YagelTasa/Smart_water_bar/PCB.png

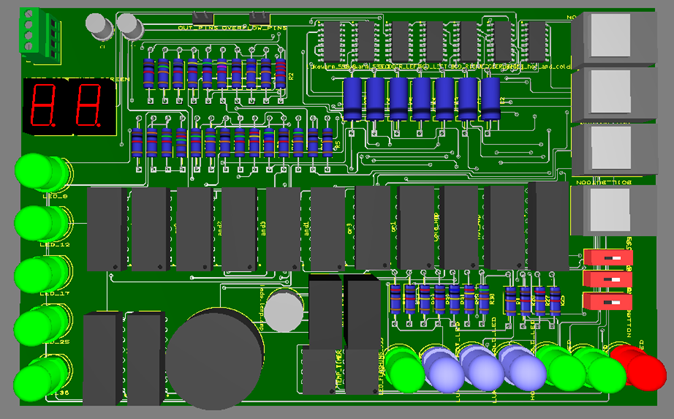
PCB.png
