YagelTasa/Smart_water_bar/Matrix image.jpg

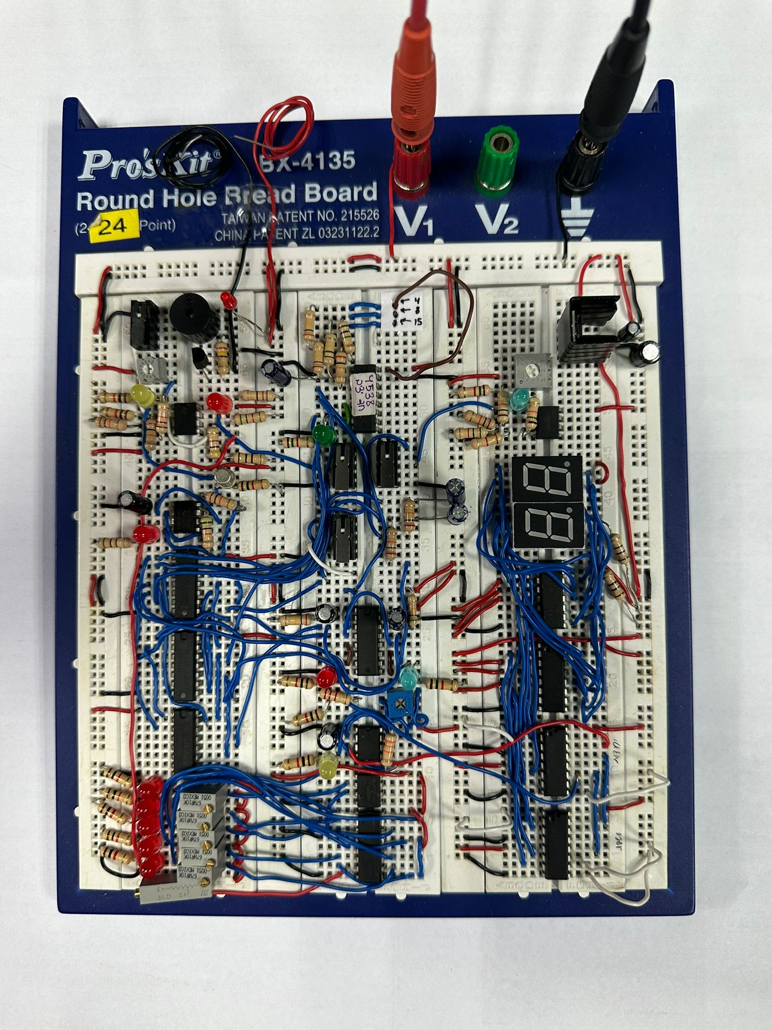
Matrix image.jpg
