YagelTasa/Smart_water_bar/Project summary (poster).pdf

## תיאור המערכת

.1 בקרת טווח טמפרטורה- בר המים שומר על טווח טמפרטורה מתאים, מים חמים

# בטווח של °C90 > ttttttt > °C50 ומים קרים בטווח של °C10 > ttttttt > °C.5

.2 הרתחת מים חמים- לאחר לחיצה על כפתור הרתחת מים מתבצע תהליך חימום

המים ל- °C92 (נבחר להרתיח את המים ב- °C2 מעל הדרישה על מנת לוודא שהדרישה תתקיים), בזמן הרתחת המים נדלקת נורת 1LLLLL אשר מהבהבת.

.3 מזיגת מים חמים- כפתור לחיצה המאפשר מזיגת מים חמים כאשר טמפרטורת המים

°C90 < ttttttt, בעת מזיגת המים נדלקת נורת 1LLLLL באופן רצוף.

.4 מזיגת מים קרים- לאחר לחיצה על כפתור מזיגת מים קרים מתבצעת הפעלת

משאבת המים הקרים, בעת מזיגת המים נדלקת נורת 2LLLLL באופן רצוף.

.5 לחיצה על כל לחצן במערכת בזמן מזיגת מים תפסיק באופן מידי את מזיגת המים. .6 הגדרת כמות מזיגת המים (גודל הכוס קרים וחמים)- ישנם 3 כפתורים אשר שולטים במשך זמן מזיגת המים, אפשרויות גודל הכוס הם מילוי מים במשך 4/8/15 שניות.
.7 מזיגת מים פושרים- כפתור לחיצה המאפשר מזיגת כוס מים פושרים למשך 8 שניות

בטווח טמפרטורת מים °C35 > ttttttt > °C,25 בעת מזיגת המים נדלקת נורת
3LLLLL באופן רצוף.

.8 הצגת טמפרטורת המים החמים והקרים בזמן אמת. .9 נורת אזהרה מפני גלישת מים- כאשר תא אחסון המים העודפים מלא (כתוצאה ממים שזלגו מחוץ לכוס) נדלקת נורת אזהרה מפני גלישת מים.
.10 צג אנלוגי המציג את משך הזמן הנותר למילוי הכוס (מניה לאחור בעת שהמשאבה עובדת).

מטרת הפרויקט .11 מימוש הפרויקט הן כ- PPPPP וגם באמצעות בקר מתוכנת (ארדואינו).

מטרת הפרויקט היא ליצור בר המים הנקרא "אריאל 8" אשר הינו מכשיר חשמלי נוח וקל לתפעול שמנגיש ומספק מי שתייה קרים וחמים ושמירתם בטמפרטורה הרצויה. בר המים מקרר או מחמם את המים עד לטמפרטורה שהוגדרה לו בעת תכנונו באמצעות שימוש בחיישנים ומערכות בקרה המתוכננות באמצעות רכיבי מעבדה. בנוסף לכך, מטרת הפרויקט היא למידה עמוקה של תכנון ובניית מערכת חשמלית עד הפרטים הקטנים על ידי סימולציות ומימוש אלקטרוני.

## מבוא

אופן צריכת מי שתייה נמצא בהתפתחות רבה בשנים האחרונות, השתלבות עולם ההנדסה בהתפתחות זו בא לידי ביטוי ביצור מערכות בקרה ושליטה על כלל הפרמטרים הנדרשים. התפתחות זו נבעה בשל צורך גדול בשיפור אספקת והנגשת מי השתייה. בעשורים האחרונים הגיעו לשוק ברי מים ושינו לטובה בצורה ניכרת את דרכי צריכת מי השתייה כיום.
ברי המים עובדים בצורה חכמה ויעילה כאשר גופי החימום והקירור, מופעלים על ידי חיישנים המודדים את טמפרטורת המים מידי פרק זמן קצוב, במידה והחיישנים מזהים שינוי טמפרטורה משמעותי במים, מופעלים שוב גופי החימום והקירור המחזירים את המים לטמפרטורה הרצויה.
פעולה זו המפעילה אך ורק בעת הצורך את גופי החימום או קירור מאפשרת למתקני בר מים להיות חסכוניים ומדויקים יחסית בצריכת החשמל. בשל הרצון להפיכתם לחסכוניים אף יותר, מתקני בר מים רבים מעלים או מורידים את הטמפרטורה מעט יותר כדי לאפשר פרק זמן גדול יותר בו גוף החימום או קירור לא יפעל. בנוסף לבקרת טמפרטורת המים, קיימות מערכות טכנולוגיות לשליטה ובקרה על כמות מזיגת המים לכוס, מזיגת מים פושרים באמצעות שילוב המים הקרים והחמים, אזהרה מפני גלישת מים עודפים, הרתחת מים, אינדיקציות המציגות בזמן אמת את מצב המכשיר באמצעות צג ונורות LED ועוד.

## תקציר

בפרויקט זה פותחה ומומשה מערכת חכמה מתקדמת לבקרה ושליטה על בר מים חכם. התהליך התחיל עם ניתוח הדרישות המלאות והפרמטרים הנדרשים למערכת. הדרישות כללו שליטה בטמפרטורה של מים חמים וקרים, הרתחת מים, מילוי כוסות חמות וקרות לפי זמן נבחר, שליטה בזמני המילוי, תצוגה של טמפרטורת המים בזמן אמת, תצוגת משך זמן הנותר למילוי הכוס ואזהרה מפני גלישת מים מתא האחסון. לאחר ניתוח הדרישות, נבנה תרשים באמצעות סכמת בלוקים המתארת את מבנה המערכת והקשרים בין הרכיבים. לאחר מכן, בוצע תכנון החומרה, אשר כלל תכנון של רכיבים וחיבורים בתוכנת הסימולציה Multisim.
במהלך תכנון החומרה, בוצעו סימולציות שנועדו לוודא את פעילות המעגל ולוודא את תקינותו.
לאחר התכנון, בוצע המימוש על גבי מטריצת החיבורים, לאחר המימוש נערכו בדיקות מתאימות על מנת לוודא שהמעגלים אכן פועלים כראוי. בנוסף, בוצע תכנון PCB המוכן להדפסה עבור המערכת. לאחר מכן, המערכת כולה תוכננה ומומשה באמצעות מיקרו-בקר (ארדואינו). המערכת יושמה בעזרת שפת תכנות ייעודית המתארת את דרישות המערכת. במהלך הבדיקות במעבדה בוצע תיעוד מפורט על מדידות, תוצאות ותיקונים שבוצעו. התיעוד תרם לשיפור ביצועי המערכת ולוודא שהיא פועלת באמינות וביעילות.

## תוצאות עיקריות

1 . בלוק מים חמים – בלוק זה מורכב מ- מעגל בקרת טמפרטורה, מעגל הרתחת מים ומעגל מזיגת מים.

2 . בלוק מים קרים – בלוק זה מורכב מ- מעגל בקרת טמפרטורה ומעגל מזיגת מים.

סיכום 3 . בלוק עצירת מערכת – בלוק זה אחראי על הפסקת המערכת בעת הצורך. בפרויקט הנדסי זה תוכננה ויושמה מערכת בר מים חכמה אשר מספקת ומנגישה מים חמים, קרים ופושרים לשתייה. מתוך דרישות הפרויקט תוכננה סכמת בלוקים אשר באמצעותה תוכננה ויושמה המערכת כולה ברמת החיבורים והרכיבים. תכנון החומרה בוצע לאחר מכן באמצעות תוכנת הדמיית הסימולציה Multisim אשר שימשה לבדיקה והדמיה של המעגלים במערכת בכדי לוודא שהם תקינים ואיכותיים. לאחר השלמת תכנון החומרה, התכנון יושם על גבי מטריצת חיבורים. מטריצת החיבורים הראתה כיצד הרכיבים יהיו מחוברים זה לזה פיזית. לאחר מכן בוצעו בדיקות תקינות המעגלים במטריצת החיבורים באמצעות סקופ. הסקופ שימש לבדיקת המעגלים כדי לוודא שהם פועלים כהלכה. בנוסף, המערכת כולה תוכננה ומומשה באמצעות מיקרו-בקר (ארדואינו), וב- PCB.

# תכנון ומימוש בר המים "אריאל 8"

## מגישים: ינון כהן יגל טסה

ת.ז: 208582643 206767469
מנחים : מר אלמוג גילדוב מר אור שלום.
