YagelTasa/Smart_water_bar/Project book.pdf

## הפקולטה להנדסה

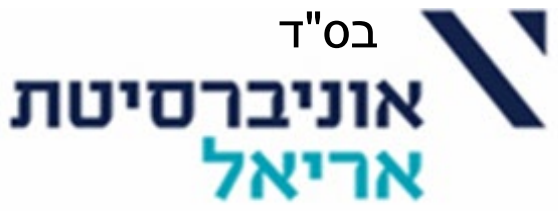
[picture p3: figure]

## המחלקה להנדסת חשמל ואלקטרוניקה

# תכנון ומימוש מערכת בר המים החדש "אריאל 8"

## פרויקט גמר המהווה חלק מהדרישות לתואר Sc.B

### מוגש ע"י: ינון כהן – 208582643 יגל טסה - 206767469

אחראיים אקדמיים : אלמוג גילדוב ואור שלום.

### תאריך הגשה: יוני .2023

תקציר.

בפרויקט זה פותחה ומומשה מערכת חכמה מתקדמת לבקרה ושליטה על בר מים חכם. התהליך התחיל עם ניתוח הדרישות המלאות והפרמטרים הנדרשים למערכת. הדרישות כללו שליטה בטמפרטורה של מים חמים וקרים, הרתחת מים, מילוי כוסות חמות וקרות לפי זמן נבחר, שליטה בזמני המילוי, תצוגה של טמפרטורת המים בזמן אמת, תצוגת משך זמן הנותר למילוי הכוס ואזהרה מפני גלישת מים מתא האחסון. לאחר ניתוח הדרישות, נבנה תרשים באמצעות סכמת בלוקים המתארת את מבנה המערכת והקשרים בין הרכיבים.
לאחר מכן, בוצע תכנון החומרה, אשר כלל תכנון של רכיבים וחיבורים בתוכנת הסימולציה .Multisim
במהלך תכנון החומרה, בוצעו סימולציות שנועדו לוודא את פעילות המעגל ולוודא את תקינותו.
לאחר התכנון, בוצע המימוש על גבי מטריצת החיבורים, לאחר המימוש נערכו בדיקות מתאימות על מנת לוודא שהמעגלים אכן פועלים כראוי. בנוסף, בוצע תכנון PCB המוכן להדפסה עבור המערכת. לאחר מכן, המערכת כולה תוכננה ומומשה באמצעות מיקרו-בקר (ארדואינו). המערכת יושמה בעזרת שפת תכנות ייעודית המתארת את דרישות המערכת. במהלך הבדיקות במעבדה בוצע תיעוד מפורט על מדידות, תוצאות ותיקונים שבוצעו. התיעוד תרם לשיפור ביצועי המערכת ולוודא שהיא פועלת באמינות וביעילות.

תוכן עניינים .

.1 מבוא.
אופן צריכת מי שתייה נמצא בהתפתחות רבה בשנים האחרונות, השתלבות עולם ההנדסה בהתפתחות זו בא לידי ביטוי ביצור מערכות בקרה ושליטה על כלל הפרמטרים הנדרשים. התפתחות זו נבעה בשל צורך גדול בשיפור אספקת והנגשת מי השתייה.

.1.1 התפתחות אספקת מי השתייה. מימי קדם הייתה מציאת מקורות מים צורך חשוב מאין כמוהו להישרדותו של האדם ולהתפתחות הציוויליזציה.
בתחילה צריכת המים הייתה באמצעות מקורות מים טבעיים, כגון מעיינות, בורות ונחלי מים. לאחר מכן כשבני האדם התחילו לבנות את המבנים הוקמו והתווספו בארות המים למקורות הטבעיים.
השימוש במקורות המים היה באמצעות העלאת המים בדליים בעזרת כוח האדם, מאוחר יותר הומצאה מכונה הממשיכה בתפקיד זה עוד בימינו בארצות הנחשלות והנקראת 'שאדוף'. מכונת השאדוף פועלת לפי עקרון המנוף, והוא עמוד קבוע באדמה עליו מתנופפת קורה ארוכה אשר אל הצד הפונה לעבר המים קושרים חבל עם דלי ואל הצד השני הפונה לעבר היבשה קושרים שק חול שמדמה משקולת. המים מועלים ביותר קלות מכיו ון והחלק הפנימי מכביד מצד השני ומקל על הדליה.

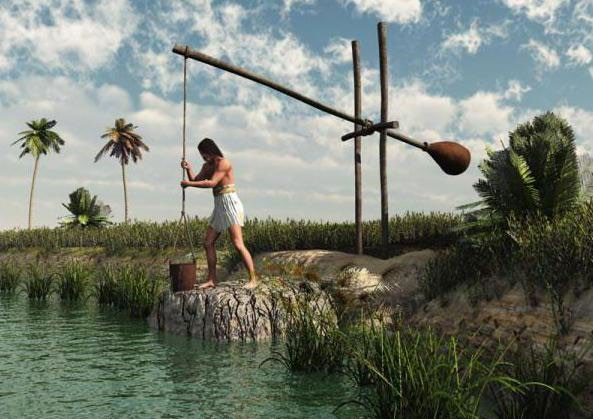
[picture p4: figure]

איור -1 מכונת השאדוף. השאדוף מורכב ממוט ארוך על ציר, בקצהו האחד דלי, או מצקת לשאיבת המים, ובקצהו השני משקל מאזן. המפעיל מושך את החבל עד שהכלי מלא במים ומאפשר למשקל המאזן להרים את המים. הפעלת השאדוף היא ידנית לגמרי, קל יותר למשוך את החבל כלפי מטה מאשר להרים את המים.

בהתפתחות העולם המודרני אספקת מי השתייה התקדמה לעבר השימוש בבקבוקים.

.1.2 אספקת מי שתייה בשילוב טכנולוגיה הנדסית. בעשורים האחרונים הגיעו לשוק ברי מים ושינו לטובה בצורה ניכרת את דרכי צריכת מי השתייה כיום.
ברי המים עובדים בצורה חכמה ויעילה כאשר גופי החימום והקירור, מופעלים על ידי חיישנים המודדים את טמפרטורת המים מידי פרק זמן קצוב, במידה והחיישנים מזהים שינוי טמפרטורה משמעותי במים, מופעלים שוב גופי החימום והקירור המחזירים את המים לטמפרטורה הרצויה.
פעולה זו המפעילה אך ורק בעת הצורך את גופי החימום או קירור מאפשרת למתקני בר מים להיות חסכוניים ומדויקים יחסית בצריכת החשמל. בשל הרצון להפיכתם לחסכוניים אף יותר, מתקני בר מים רבים מעלים או מורידים את הטמפרטורה מעט יותר כדי לאפשר פרק זמן גדול יותר בו גוף החימום או קירור לא יפעל. בנוסף לבקרת טמפרטורת המים, קיימות מערכות טכנולוגיות לשליטה ובקרה על כמות מזיגת המים לכוס, מזיגת מים פושרים באמצעות שילוב המים הקרים והחמים, אזהרה מפני גלישת מים עודפים, הרתחת מים, אינדיקציות המציגות בזמן אמת את מצב המכשיר באמצעות צג ונורות LED ועוד.

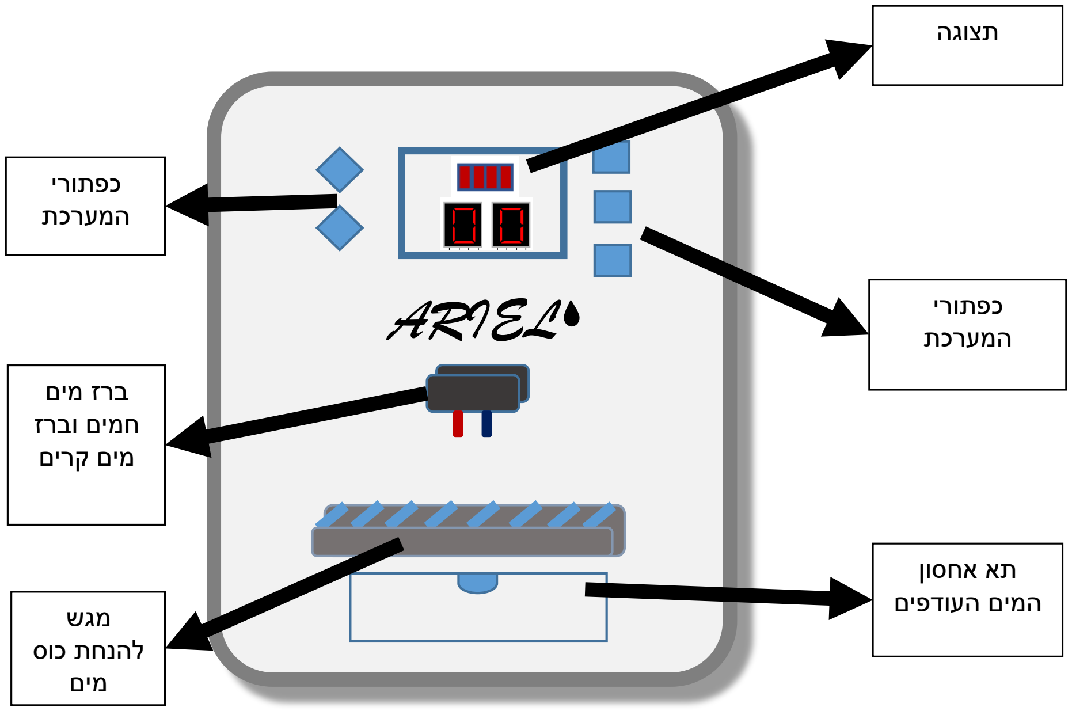
[picture p5: figure]
תצוגה; כפתורי המערכת; ברז מים חמים וברז מים קרים; מגש להנחת כוס מים; תא אחסון המים העודפים; ARIEL

איור -2 תצוגת בר המים אריאל .8

.1.3 יתרונות ברי המים.
- מים זמינים בקלות.
כיום ידוע שצריכת מים מספקת לכל אדם היא הכרח לאורח חיים בריא ומאוזן יותר. מאוד נוח כאשר יש בר מים על השולחן בבית או במשרד המספק באופן זמין מים קרים או חמים במהירות ובכמות מספקת על ידי לחיצת כפתור. אין צורך לסחוב בקבוקים או להעביר שישיות של מים ממקום למקום, דבר אשר מסיר מעלינו מעמסה כבדה ובמיוחד עבור קשישים או אנשים שיש להם קושי או מגבלה פיזית. בר המים גורם לכך שהמשתמשים השונים שותים יותר, בגלל הזמינות והנוחות. יתרון זה תקף למבוגרים וגם לילדים כאחד.
- ידידותי לסביבה.
מדי שנה מגיעים אל האשפה מיליוני בקבוקי מים מפלסטיק מתוך מיליארדים שנמצאים בשימוש ברחבי העולם. מדובר בנזק משמעותי לסביבה ממנו אפשר להימנע באמצעות בר מים. בר מים הוא מכשיר אשר מספק מי השתייה וניתן למלא באמצעותו בקבוקים ריקים ובכך לעשות בהם שימוש חוזר. מלבד זאת, אפשר לוותר על הצורך בבקבוק ולמזוג מים ישירות לכוס רב פעמית בנוחות מקסימלית ובכך לסייע לצמצם את המספרים העצומים של מוצרי פלסטיק אשר נזרקים ומזיקים לסביבה.
- חיסכון כספי.
אם עד עכשיו הייתם משקיעים את הכסף ברכישת בקבוקים של מים מינרלים, לאחר רכישת בר מים לא תצטרכו לעשות זאת יותר ותוכלו ליהנות מחיסכון מרבי. למרות שצפוי כי תשקיעו על רכישת המתקן, אולם מלבד זאת לא יהיו לכם הוצאות מרובות על תפעול ותחזוקה. בר מים זו דרך חסכונית לשתות יותר מים ובגלל זה היא מועדפת על רבים. כאשר תהיו צמאים אינכם צריכים לרכוש מים, המים במתקן זמינים עבורכם סביב השעון וכל שעליכם לעשות הוא פשוט למזוג, במבט לעתיד, זו השקעה משתלמת לכל הדעות.

.1.4 הצורך.
כפי שראינו, ישנו צורך גדול ויתרונות רבים בשימוש בבר מים. פיתוח בר המים "אריאל 8" ייתן מענה בנושא וישפר משמעותית את איכות החיים שלנו.

.2 מטרת הפרויקט.
מטרת הפרויקט היא ליצור בר המים הנקרא "אריאל 8" אשר הינו מכשיר חשמלי נוח וקל לתפעול שמנגיש ומספק מי שתייה קרים וחמים ושמירתם בטמפרטורה הרצויה. בר המים מקרר או מחמם את המים עד לטמפרטורה שהוגדרה לו בעת תכנונו באמצעות שימוש בחיישנים ומערכות בקרה המתוכננות באמצעות רכיבי מעבדה. בנוסף לכך, מטרת הפרויקט היא למידה עמוקה של תכנון ובניית מערכת חשמלית עד הפרטים הקטנים על ידי סימולציות ומימוש אלקטרוני.

.2.1 תנאי התכנון.
בר המים "אריאל 8" שתוכנן במסגרת הקורס יכלול:
- שליטה על טווח טמפרטור ת המים הקרים והחמים .
- שליטה על טווח טמפרטורת המים הפושרים באמצעות שילוב המים הקרים והחמים.
- הרתחת מים חמים.
- מערך כפתורים הנותן אפשרויות שונות של כמות מזיגת מים (קרים וחמים).
- מתן אפשרות להפסקת מזיגת המים באמצעות לחיצה על כל כפתור במכשיר.
- צג המציג למשתמש בזמן אמת את טמפרטורת המים ואת משך הזמן הנותר למזיגת כוס המים.
- התראה למשתמש כאשר תא אחסון המים העודפים מלא.

.2.2 דרישות המערכת.
עבור תכנון בר המים נדרשים הפרמטרים הבאים:
- בקרת טווח טמפרטורה- על בר המים לשמור על טווח טמפרטורה מתאים, מים חמים

# בטווח של °C90 > ttttttt > °C50 ומים קרים בטווח של °C10 > ttttttt > °C.5

- הרתחת מים חמים- לאחר לחיצה על כפתור הרתחת מים מתבצע תהליך חימום המים ל-

°C92 (נבחר להרתיח את המים ב- °C2 מעל הדרישה על מנת לוודא שהדרישה תתקיים), בזמן הרתחת המים נדלקת נורת 1LLLLL אשר מהבהבת.

- מזיגת מים חמים- כפתור לחיצה המאפשר מזיגת מים חמים כאשר טמפרטורת המים

°C90 < ttttttt, בעת מזיגת המים נדלקת נורת 1LLLLL באופן רצוף.

- מזיגת מים קרים- לאחר לחיצה על כפתור מזיגת מים קרים מתבצעת הפעלת משאבת

המים הקרים, בעת מזיגת המים נדלקת נורת 2LLLLL באופן רצוף.

- לחיצה על כל לחצן במערכת בזמן מזיגת מים תפסיק באופן מידי את מזיגת המים.
- הגדרת כמות מזיגת המים (קרים וחמים), כלומר גודל הכוס. ישנם 3 כפתורים אשר שולטים במשך זמן מזיגת המים, אפשרויות גודל הכוס הם מילוי מים במשך

# .15 SS SS, 8 SS SS, 4 SS SS

- מזיגת מים פושרים- כפתור לחיצה המאפשר מזיגת כוס מים פושרים למשך S S 8 בטווח טמפרטורת מים °C35 > ttttttt > °C,25 בעת מזיגת המים נדלקת נורת 3LLLLL באופן רצוף.
- צג אנלוגי המציג את טמפרטורת המים הקרים ואת טמפרטורת המים החמים בזמן אמת.
- נורת אזהרה מפני גלישת מים- כאשר תא אחסון המים העודפים מלא (כתוצאה ממים שזלגו מחוץ לכוס) נדלקת נורת אזהרה מפני גלישת מים.
- צג אנלוגי המציג את משך הזמן הנותר למילוי הכוס (מניה לאחור בעת שהמשאבה עובדת).
- מימוש הפרויקט הן כ- PPPPP וגם באמצעות בקר מתוכנת (ארדואינו).

.3 תיאור המערכת.
המערכת הנבנית היא מערכת הנקראת "אריאל 8" . מערכת זו הינה מכשיר חשמלי הנקרא בר מים, מכשיר זה נועד לאספקת מי שתייה קרים וחמים תוך שמירתם בטמפרטורה הרצויה שהוגדרה לו מראש.

.3.1 הסבר כללי על המערכת.
המערכת מופעלת על ידי חיישנים המודדים את טמפרטורת המים באמצעות ערך התנגדותי, במידה והחיישנים מזהים שינוי טמפרטורה משמעותי במים, מופעלים שוב גופי החימום והקירור המחזירים את המים לטמפרטורה הרצויה. בנוסף לכך, קיימות במערכת עוד הרבה אמצעי שליטה ובקרה נוספים שנועדו להקל על שימוש המשתמש במערכת, כמו שליטה בכמות מזיגת המים לכוס, מזיגת מים פושרים באמצעות שילוב המים הקרים והחמים, אזהרה מפני גלישת מים עודפים, הרתחת מים, אינדיקציות המציגות בזמן אמת את טמפרטורת המים וזמן שנותר למזיגה באמצעות צג ונורות LED ועוד .

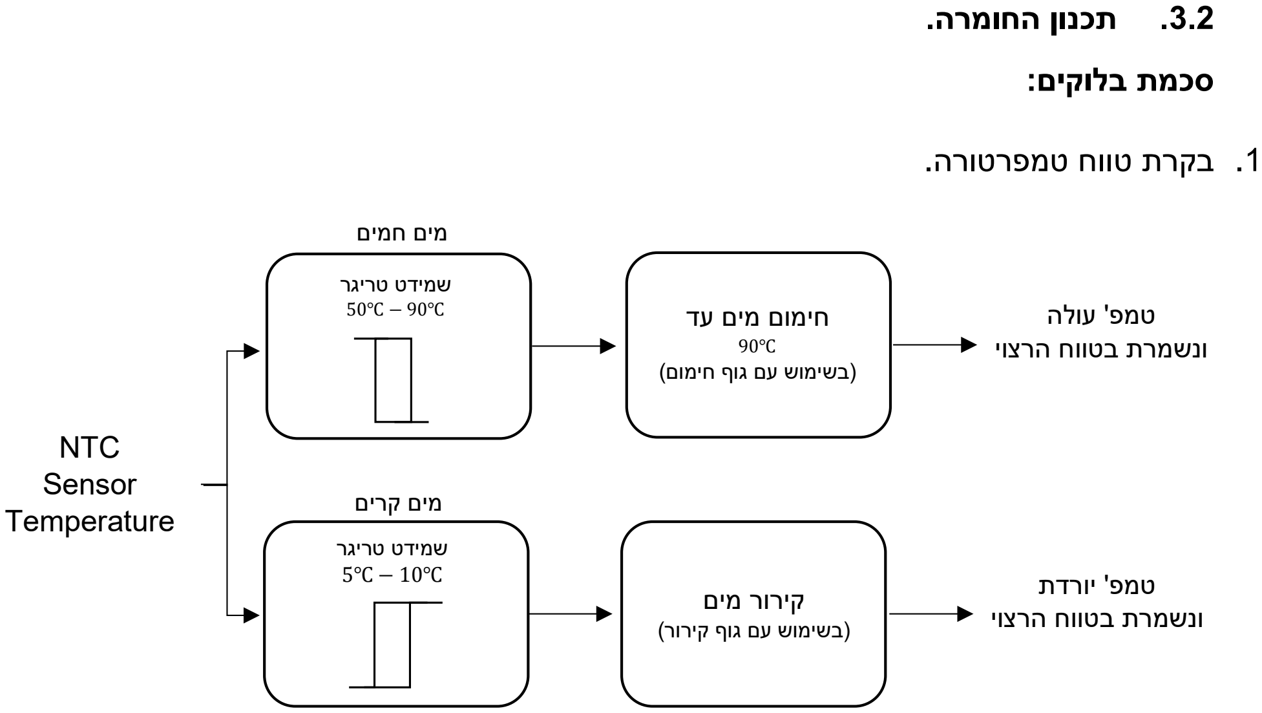
[picture p6: figure]
.3.2 תכנון החומרה. סכמת בלוקים:; .1 בקרת טווח טמפרטורה.; מים חמים; מים קרים; שמידט טריגר; NTC Sensor Temperature; חימום מים עד; (בשימוש עם גוף חימום); טמפ' עולה ונשמרת בטווח הרצוי; קירור מים (בשימוש עם גוף קירור); טמפ' יורדת ונשמרת בטווח הרצוי

איור -3 סכמת בלוקים עבור בקרת טמפרטורה.

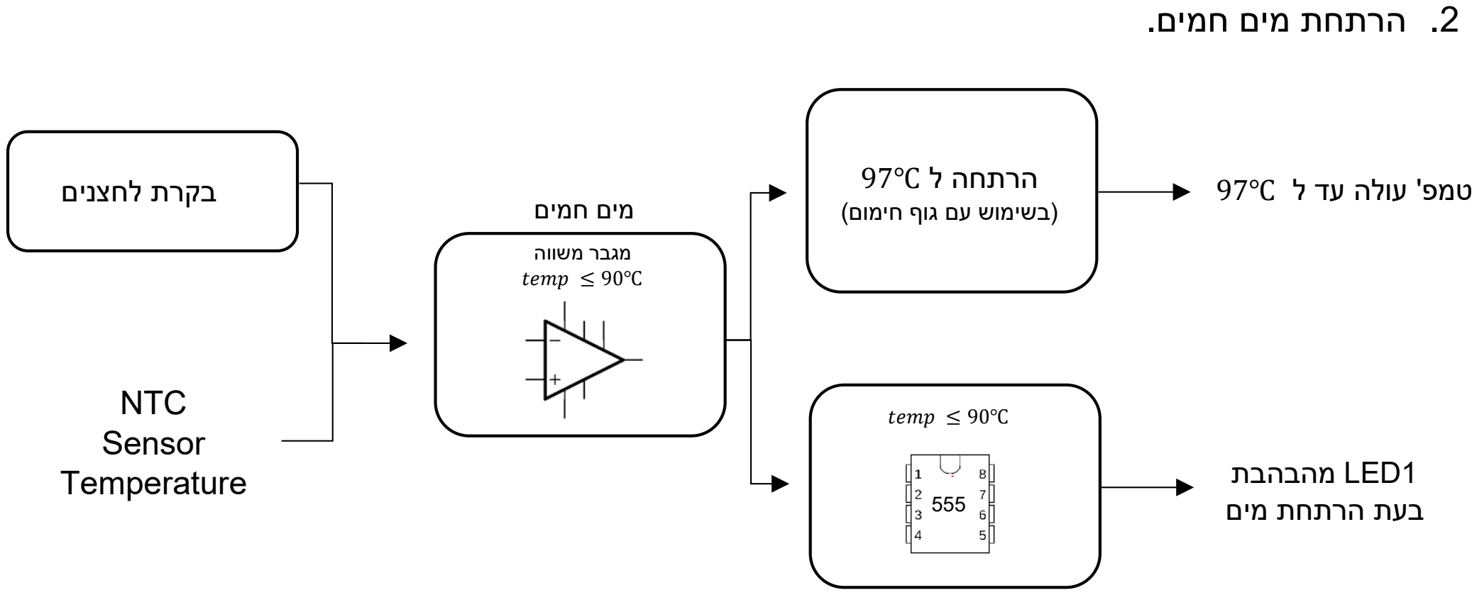
[picture p7: figure]
.2 הרתחת מים חמים.; מים חמים; מגבר משווה; tttttttt ≤ 90℃; הרתחה ל °C97; (בשימוש עם גוף חימום); טמפ' עולה עד ל °C97; 1LED מהבהבת; בעת הרתחת מים; בקרת לחצנים; NTC Sensor Temperature

איור -4 סכמת בלוקים עבור הרתחת מים חמים.

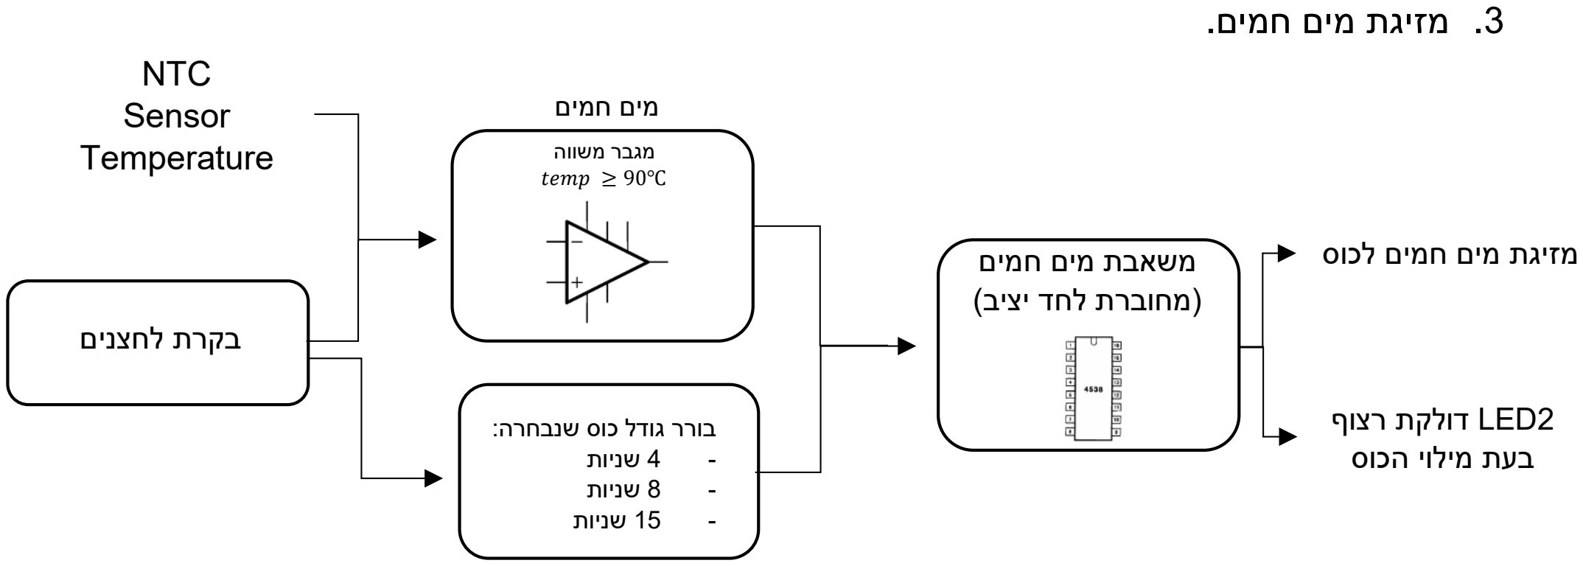
[picture p8: figure]
.3 מזיגת מים חמים.; משאבת מים חמים (מחוברת לחד יציב); מזיגת מים חמים לכוס; 2LED דולקת רצוף בעת מילוי הכוס; מים חמים; מגבר משווה; tttttttt ≥ 90℃; בורר גודל כוס שנבחרה: - 4 שניות - 8 שניות - 15 שניות; בקרת לחצנים; NTC Sensor Temperature

איור -5 סכמת בלוקים עבור מזיגת מים חמים.

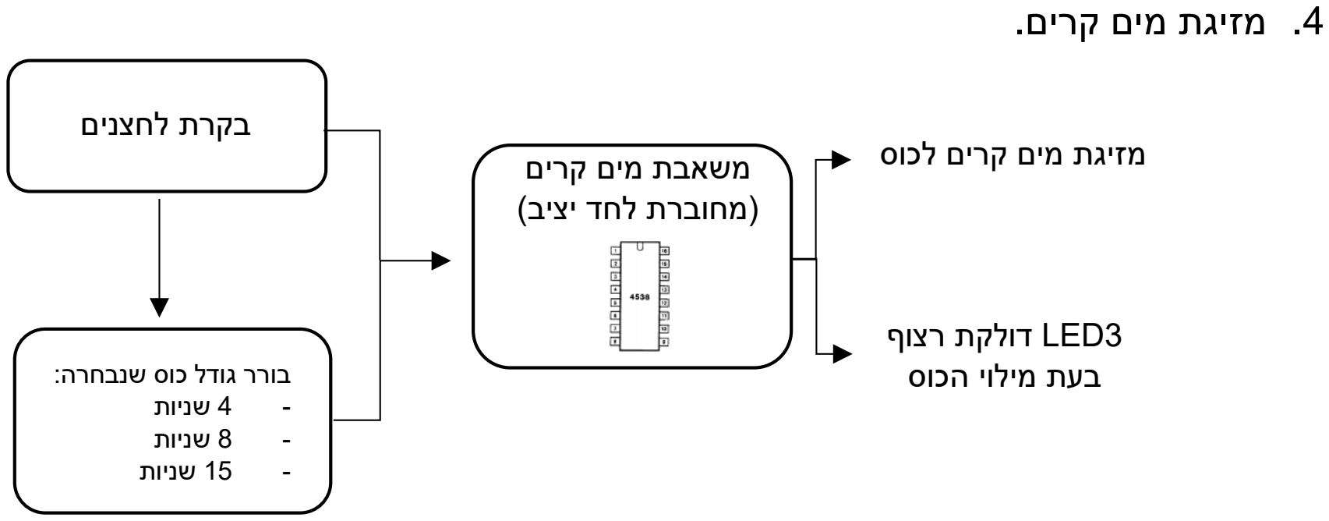
[picture p9: figure]
.4 מזיגת מים קרים.; משאבת מים קרים; מזיגת מים קרים לכוס; (מחוברת לחד יציב); 3LED דולקת רצוף בעת מילוי הכוס; בקרת לחצנים; בורר גודל כוס שנבחרה: - 4 שניות - 8 שניות - 15 שניות

איור -6 סכמת בלוקים עבור מזיגת מים קרים.

.5 בקרת גודל כוס (זמני מזיגה).

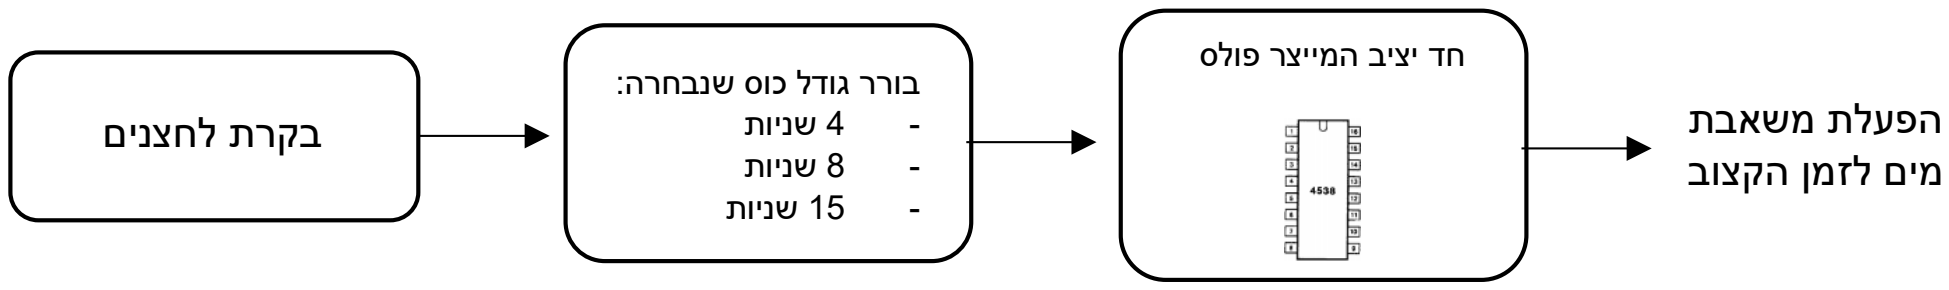
[picture p10: figure]
בקרת לחצנים; בורר גודל כוס שנבחרה: - 4 שניות - 8 שניות - 15 שניות; חד יציב המייצר פולס; הפעלת משאבת מים לזמן הקצוב

איור -7 סכמת בלוקים עבור בקרת גודל הכוס (זמן מזיגה).

.6 מזיגת מים פושרים (למשך 8 שניות).

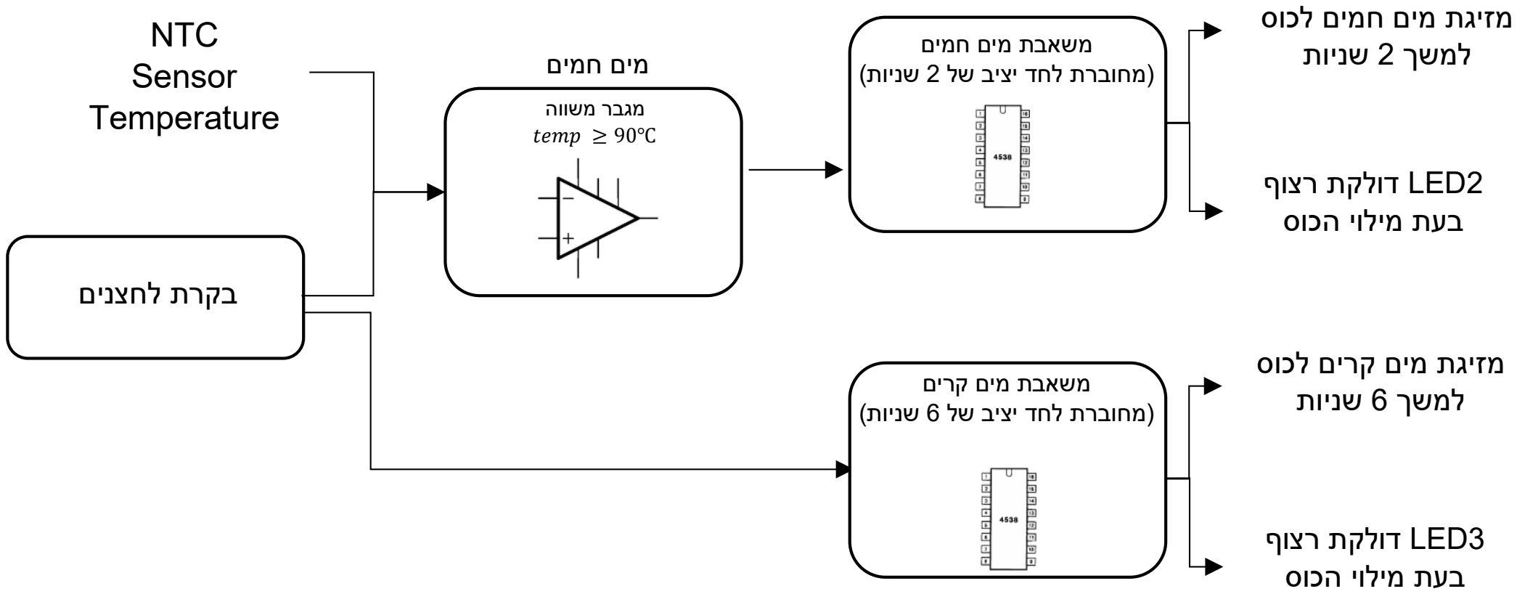
[picture p11: figure]
משאבת מים חמים (מחוברת לחד יציב של 2 שניות); מזיגת מים חמים לכוס למשך 2 שניות; 2LED דולקת רצוף בעת מילוי הכוס; מים חמים; מגבר משווה; tttttttt ≥ 90℃; בקרת לחצנים; NTC Sensor Temperature; משאבת מים קרים (מחוברת לחד יציב של 6 שניות); מזיגת מים קרים לכוס למשך 6 שניות; 3LED דולקת רצוף בעת מילוי הכוס

איור -8 סכמת בלוקים עבור מזיגת מים קרים. .7 ספירה לאחור בעת מזיגה.

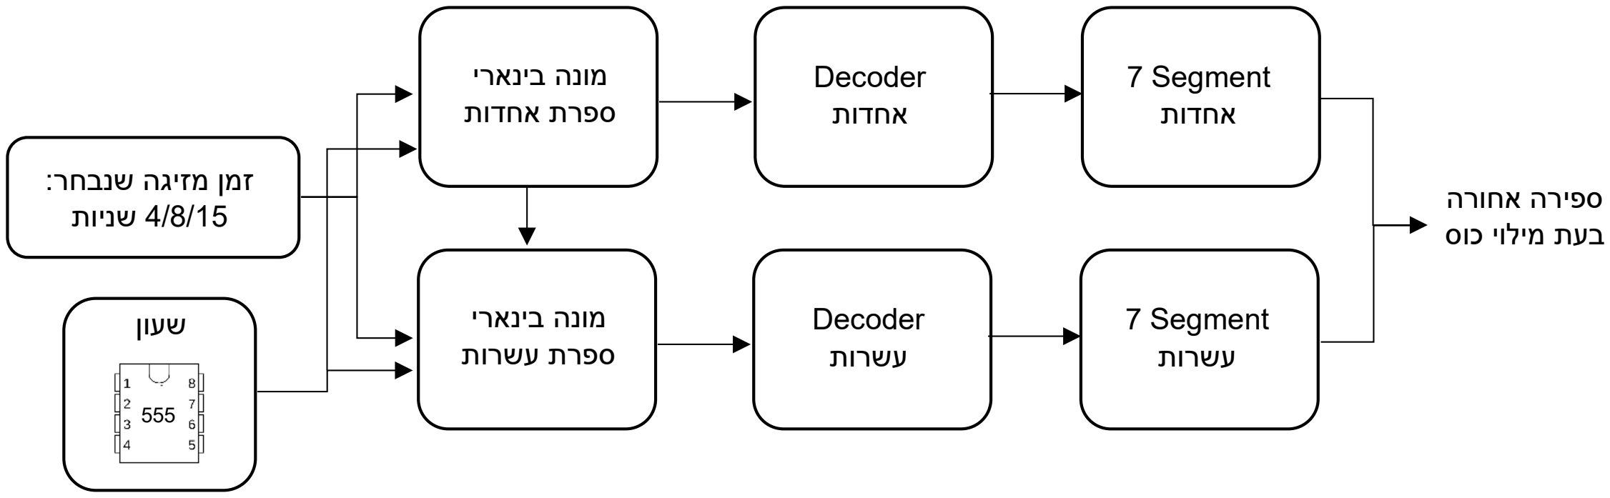
[picture p12: figure]
זמן מזיגה שנבחר: ספירה אחורה 4/8/15 שניות בעת מילוי כוס; מונה בינארי ספרת אחדות; Decoder אחדות; 7 Segment אחדות; מונה בינארי ספרת עשרות; Decoder עשרות; 7 Segment עשרות; שעון

איור -9 סכמת בלוקים עבור ספירה לאחור בעת מזיגה.

.8 הצגת ערך טווח טמפרטורה.

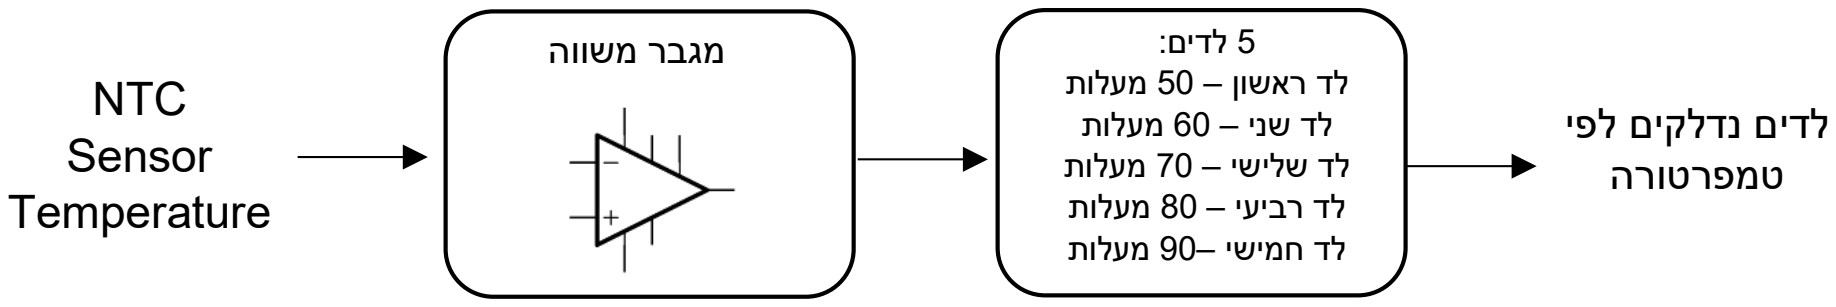
[picture p13: figure]
NTC Sensor Temperature; 5 לדים: מגבר משווה לד ראשון – 50 מעלות לד שני – 60 מעלות לד שלישי – 70 מעלות לד רביעי – 80 מעלות לד חמישי –90 מעלות; לדים נדלקים לפי טמפרטורה

איור -10 סכמת בלוקים עבור הצגת מערך טווח טמפרטורת.

.9 בקרת לחצנים (בודק לחיצה בעת מזיגה).

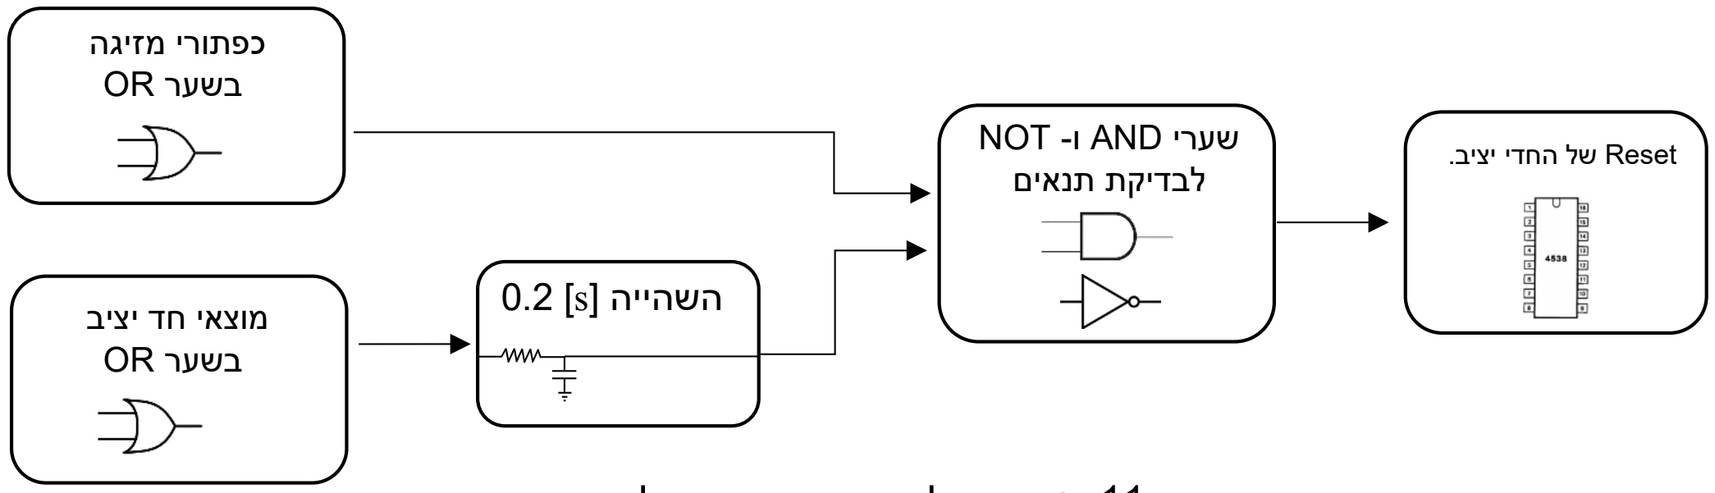
[picture p14: figure]
Reset של החדי יציב.; כפתורי מזיגה בשער OR; מוצאי חד יציב בשער OR; השהייה [s [0.2; שערי AND ו- NOT לבדיקת תנאים

איור -11 סכמת בלוקים עבור בקרת לחצנים.

.10בקרת גלישת מים.

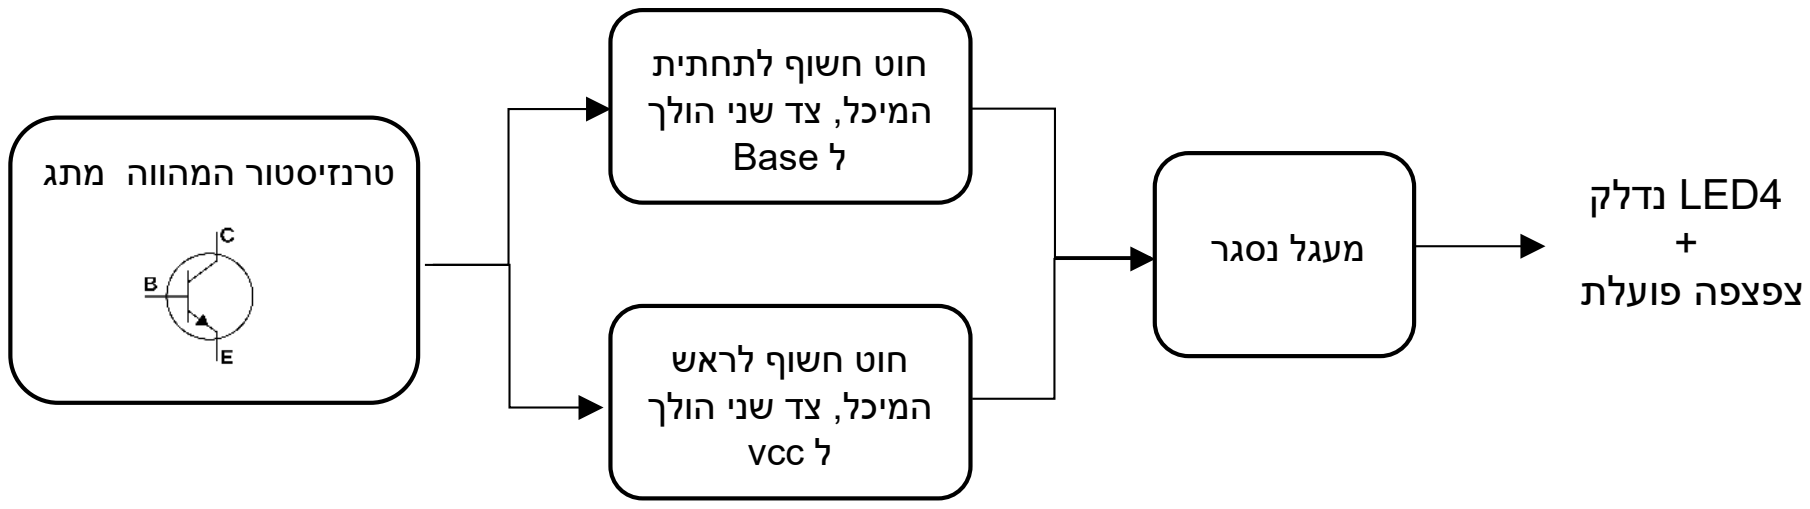
[picture p15: figure]
4LED נדלק + צפצפה פועלת; מעגל נסגר; חוט חשוף לתחתית המיכל, צד שני הולך ל Base; חוט חשוף לראש המיכל, צד שני הולך ל vcc; טרנזיסטור המהווה מתג

איור -12 סכמת בלוקים עבור בקרת גלישת מים.

מקרא רכיבים:
1LED – לד הרתחת מים.
2LED - לד מזיגת מים חמים.
3LED - לד מזיגת מים קרים.
4LED- לד אזהרה על גלישת מים במיכל.

תיאור החומרה:
טמפרטורה – חיישן NTC) Coefficient Temperature Negative (הוא חיישן שמשנה את ערכו ההתנגדותי בהתאם לשינוי בטמפרטורה. ההתנגדות של חיישן NTC יורדת כאשר הטמפרטורה עולה, ועולה כאשר הטמפרטורה יורדת. עבור תחומי הטמפרטורה הרצויים הובאו ערכי התנגדות החיישן מתוך דפי הנתונים כדלהלן:

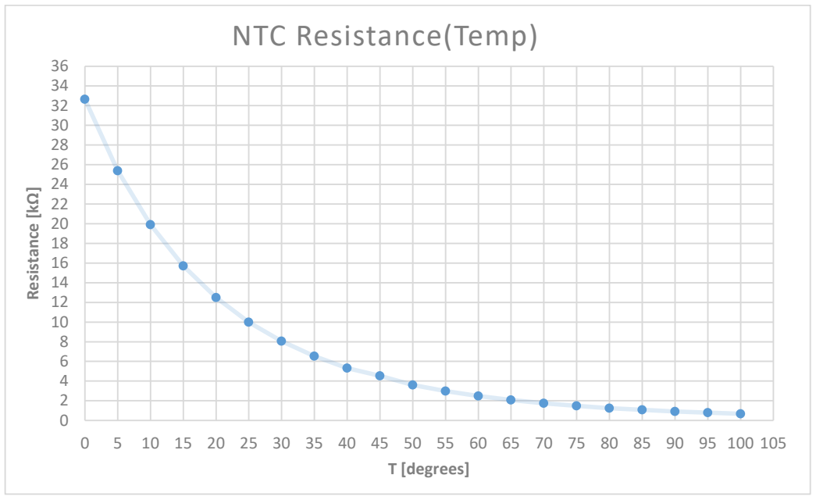
[picture p16: figure]
Resistance [k; T [degrees]; NTC Resistance(Temp)

איור -13 גרף של חיישן הטמפרטורה (NTC (ביחס להתנגדות. באיור 13 ניתן לראות את השפעת הטמפרטורה על ההתנגדות ומתוך כך ניתן לבנות את המערכת בהתאם לטווחי הטמפרטורה הרצויים בה. כמו כן ניתן לראות כי ההתנגדות של החיישן יורדת כאשר הטמפרטורה עולה, ועולה כאשר הטמפרטורה יורדת.

0 5 10 15 20 25 30 35 40 45 50 55 60 65 70 75 80 85 90 95 100 105

ערכים רצויים של חיישן הטמפרטורה לצורך דרישות המערכת: על מנת לקיים את דרישות המערכת לטווח טמפ' מים קרים, טווח טמפ' מים חמים והרתחת מים חמים, חיישן הטמפרטורה חובר לרב מודד כאשר בכל פעם הועלתה הטמפרטורה ונמדדה התנגדותו, לאחר מכן נעשה חישוב המתח על נגד הטמפ' בעזרת נוסחת המחלק מתח הבאה :

# (1) VVoooooo,NNNNNN = VV ∗ RR1kk RR1kk + RRNNNNNN

= 12 ∗ 1kk

# 1kk + RRNNNNNN

[VV]

טבלה 1 – ערכי התנגדות החיישן לפי הטמפרטורה:

בטבלה 1 ניתן לראות את ערכי הטמפ', ערכי ההתנגדות וערכי מתח המוצא של חיישן הטמפ' . בעזרת מתחים אלו נוכל לממש את דרישות המערכת.

טבלת יחס טמפרטורה למים פושרים: נדרש כי המים הפושרים יהיו בטווח הטמפרטורה של 35° − 25° למשך [ec[SS.8

על מנת לקיים דרישה זו תוכנן יחס הטמפרטורות בין המים הקרים לחמים,

כאשר זמן מזיגת מים חמים הינו [ec[SS2 , וזמן מזיגת מים קרים הינו [ec[SS.6

טבלה 2 – תיכנון מזיגת המים הפושרים

מטבלה 2 ניתן לראות את ערך טמפרטורות של המים החמים והקרים וערך הטמפרטורה של המים הפושרים לפי היחס בין זמני מזיגת המים החמים והקרים.

Temperature[ | RR RRRRRR RRRR [kkΩ] | VVoooooo,NNNNNN[VV] ° צורך | [
| | 3.39 25.4 5 טווח מים קרים
10 | 19.9 | 4.02
| | 2.6 3.6 50 טווח מים חמים
90 | 0.92 | 6.25
| | 6.89 0.74 97 הרתחה
[ טמפ' חמים | ° | [ טמפ' קרים ] | ° | [ טמפ' מים פושרים ] | ° ]
97 | 10 | 31.75
97 | 5 | 28

.3.3 תכנון התוכנה באמצעות מיקרו-בקר ( ארדואינו). ארדואינו (Arduino (הינו מערכת פיתוח פיזית ותוכנה פתוחה המבוססת על לוח מיקרו-בקר, המיועדת ליצירת מכשירים אלקטרוניים פשוטים ואינטראקטיביים. שפת התכנות המרכזית של ארדואינו היא " ++C".
ארדואינו מספקת ממשק פשוט ומותאם למתכנתים, המפשט את תהליך הפיתוח והקומפילציה של קוד בשפת ++C עבור מיקרו-בקרי הארדואינו. כלומר, אף על פי שמדובר בשפת תכנות מתקדמת ומורכבת, תהליך התכנות בארדואינו נעשה באמצעות פונקציות וספריות מובנות במערכת, שמסייעות למתכנתים ליישם פעולות פשוטות כמו קריאה לפורטים אנלוגיים או דיגיטליים, שליטה במנורה או במשאבה, ועוד. ארדואינו מאפשרת תכנות וטעינה של קוד ללוח מיקרו- בקר (הכרוך בשם "לוח ארדואינו") באמצעות חיבור הלוח למחשב באמצעות כבל USB. בנוסף ללוח המיקרו-בקר, לארדואינו יש סביבת פיתוח עצמאית שנקראת " "IDE Arduino (Environment Development Integrated(. זו תוכנה שנוצרה כדי לספק ממשק ידידותי למתכנתים ולאפשר להם ליצור, לערוך, לקמפל ולהעלות קוד ללוח הארדואינו. להלן תרשים זרימה כללי של המערכת:

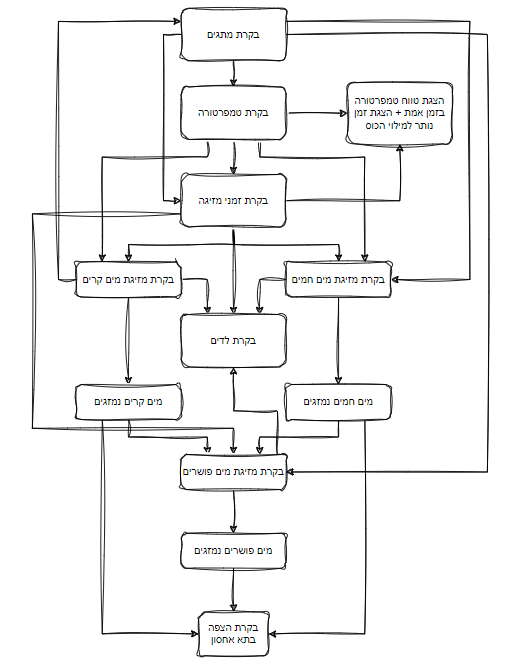
[picture p17: figure]

איור -14 תרשים זרימה כללי של המערכת.

.4 מימוש המערכת.
אופן המימוש בוצע על גבי מטריצת חיבורים אשר עליה נבנו כלל המעגלים על ידי הרכיבים הבאים:
.1 מימוש בקרת טווח טמפרטורת מים חמים, רכיבים- נגדים, מגבר 358LM) ע"מ לממש שמידט-טריגר הפוך), חיישן טמפרטורה NTC , נורת לד. .2 מימוש בקרת טווח טמפרטורת מים קרים, רכיבים- נגדים, מגבר 358LM) ע"מ לממש שמידט-טריגר), חיישן טמפרטורה NTC , נורת לד. .3 כפתור הרתחת מים חמים ונורה מהבהבת בעת מזיגה, רכיבים- נגדים, מגבר 358LM (מגבר משווה), נורות לד, טרנזיסטור 2222N,2 קבל, זמנן P555NE. .4 כפתור לחיצה המאפשר מזיגת מים חמים, רכיבים- כפתור, נגד ונורת לד. .5 כפתור לחיצה המאפשר מזיגת מים קרים, רכיבים- כפתור, נגד ונורת לד. .6 לחיצה על כל לחצן בעת מזיגה תפסיק את המזיגה, רכיבים- שערי NOT, OR, AND, נגדים וקבלים (לצורך השהייה). .7 בחירת גודל הכוס (זמן מזיגה), רכיבים- נגדים, קבלים וחד יציב 14538MC ושער OR. .8 כפתור לחיצה המאפשר מזיגת מים פושרים, רכיבים- כפתור, נגדים, קבלים, חד יציב 14538MC ו2 נורות לד.
.9 הצגת טמפרטורת המים בזמן אמת, רכיבים – נגדים משתנים, מגבר 358LM) מגבר משווה), 5 נורות לד, חיישן טמפרטורה NTC. .10נורת אזהרה מפני גלישת מים, רכיבים- טרנזיסטור 06031MPSA, Buzzer Active, נגד ונורת לד.
.11הצגת משך הזמן למילוי כוס, רכיבים – נגדים, רכיבי segment ,7 רכיבי D47LS74 Decoder, רכיבי BCD D190LS,74 לצורך שעון – נגדים, קבל, זמנן P555NE ונורת לד.
כמו כן המטריצה הוזנה לאספקת מתח קבוע של [V]12 להספקת כלל הרכיבים במעגלים.

אופן המימוש בארדואינו (בקר מתוכנת) בוצע על גבי מטריצת חיבורים אשר עליה הונחו הרכיבים הבאים:
7 כפתורים, נגדים, לוח UNO, מסך LCD, חיישן לחות, נורות במספר צבעים, 2 חיישני טמפרטורה NTC תוכנת IDE Arduino וחוטי קצר.

.4.1 מימוש החומרה.
סכמות חשמליות:
.1 תכנון מפורט ברמת החיבורים עבור בלוק בקרת טווח טמפרטורה מים חמים.

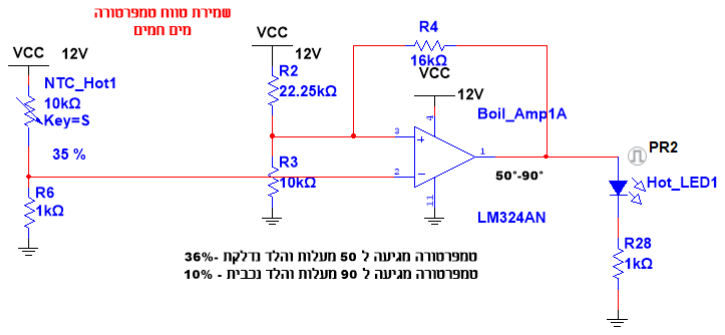
[picture p18: figure]

איור -15 מעגל שמירת טווח טמפ' של המים החמים.

חיישן הטמפ' NTC הינו נגד משתנה כפונקציה של הטמפרטורה, הוא מזין מתח כניסה למגבר משווה (נכנס לרגל ,2הרגל השלילית של המגבר). באיור 15 ניתן להבחין כי מעגל זה הינו שמידט טריגר הפוך שמוציא מתח בהתאם לטמפרטורה הנמדדת מהחיישן טמפ' (לפי עקומת החשל). במהלך הפעלת המעגל מתבצעת השוואה בין רגלי הכניסה של המגבר ומתח המוצא משתנה בהתאם למתחי הסף.
תפקיד ה – LED הינו לאותת למשתמש האם מתבצע חימום (טמפ' מתחת ל 50 מעלות) או שלא.

הסבר על אופן פעולת המעגל:
כאשר הנגד המשתנה על 36% - טמפרטורה מגיעה ל 50 מעלות והלד נדלקת. וכאשר הנגד המשתנה על 10% - טמפרטורה מגיעה ל 90 מעלות והלד נכבית.

.2 תכנון מפורט ברמת החיבורים עבור בלוק בקרת טווח טמפרטורה מים קרים.

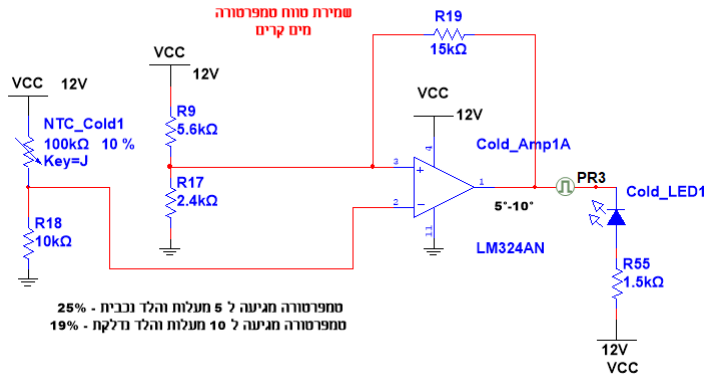
[picture p19: figure]

איור -16 מעגל שמירת טווח טמפ' של המים הקרים.

חיישן הטמפ' NTC הינו נגד משתנה כפונקציה של הטמפרטורה, הוא מזין מתח כניסה למגבר משווה (נכנס לרגל ,2הרגל השלילית של המגבר). באיור 16 ניתן להבחין כי מעגל זה הינו שמידט טריגר הפוך שמוציא מתח בהתאם לטמפרטורה הנמדדת מהחיישן טמפ' (לפי עקומת החשל). במהלך הפעלת המעגל מתבצעת השוואה בין רגלי הכניסה של המגבר ומתח המוצא משתנה בהתאם למתחי הסף.
ניתן לראות שבמוצא המגבר חובר הספק כך שיתקבל מעגל שמידט טריגר רגיל ולא הפוך כמו באיור .15
תפקיד ה – LED הינו לאותת למשתמש האם מתבצע קירור (טמפ' מעל 10 מעלות) או שלא.

הסבר על אופן פעולת המעגל:
כאשר הנגד המשתנה על 25% - טמפרטורה מגיעה ל 5 מעלות והלד נכבה. וכאשר הנגד המשתנה על 19% - טמפרטורה מגיעה ל 10 מעלות והלד נדלקת.

.3 תכנון מפורט ברמת החיבורים עבור בלוק הרתחת מים חמים.

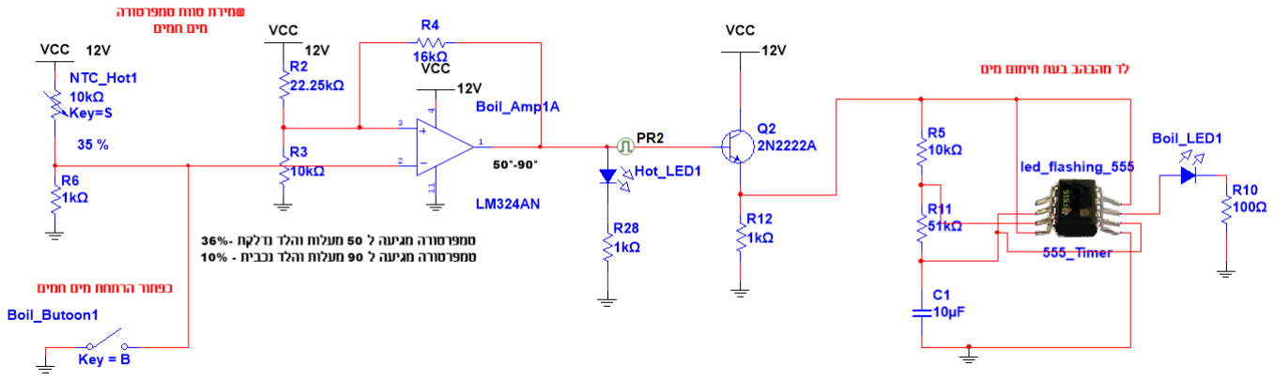
[picture p20: figure]

איור -17 מעגל הרתחת מים, נורת הלד מהבהבת בעת ההרתחה.

בתכנון בלוק זה (איור 17) בוצע שימוש בשני מעגלים:
- בוצע שימוש במגבר משווה מאיור ,15 שמתפקד כמעגל שמידט טריגר. רגל המינוס של המגבר חוברה לענף של נגד הטמפ' כדי לקבל מידע על הטמפ'.
- בוצע שימוש בטרנזיסטור כמתג להפעלת הבהוב בלד הרתחה.
- בוצע שימוש בזמנן (רכיב 555) על מנת לגרום לנורת לד להבהב בעת הרתחת המים. רכיב זה פועל כל עוד מקבל מתח הזנה (מתח ממוצא המגבר).

הסבר על אופן פעולת המגבר:
כאשר הנגד המשתנה על 9% - טמפרטורה מגיעה ל 90 מעלות והלד תכבה. במצב זה לא יהיה מתח במוצא המגבר ולכן מעגל ה - 555 יפסיק לפעול. כאשר הטמפרטורה יורדת ההתנגדות גדלה ולכן כל עוד הנגד המשתנה גדול מ 9% וקטן מ 36% (הטמפ' בין 50 מעלות ל 90 מעלות) הלד ידלק. במצב זה יהיה במוצא המגבר מתח אשר יאפשר את הפעלת מעגל ה – 555 והלד תתחיל להבהב.

כאשר כפתור הרתחת המים ילחץ, ענף הטמפ' יקוצר, מה שיגרום לקבל ערך של [V[0 לרגע

קצר ברגל השלילית של המגבר (שמידט טריגר) וכך המעגל יופעל כי "יחשוב" שהטמפ' מתחת ל 50 מעלות. במצב זה המעגל יופעל ויתבצע חימום עד ל 90 מעלות.

.4 תכנון מפורט ברמת החיבורים עבור בלוק מזיגת מים חמים.

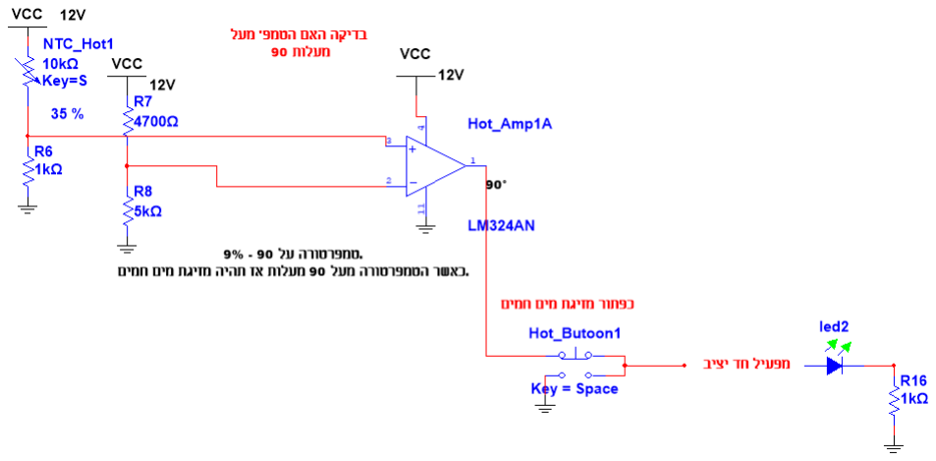
[picture p21: figure]

איור -18 מעגל מזיגת מים חמים.

בבלוק זה (איור 18) בוצע שימוש במגבר משווה שבודק שטווח הטמפרטורה מעל 90 מעלות ובמידה וכן מוציא מתח כדי להפעיל את מעגל החד יציב (איור 21) ולאפשר מזיגת מים חמים לכוס (בהתאם לזמני המזיגה/גודל הכוס).

הסבר על אופן פעולת המגבר:
כאשר הנגד המשתנה על 9% - טמפרטורה מעל 90 מעלות והלד נדלקת ובכך מעגל החד יציב יופעל, מה שמאפשר מזיגת מים חמים (כי הדרישה שהטמפ' מעל 90 מעלות מתקיימת).
כאשר הטמפרטורה יורדת ההתנגדות של הנגד טמפ' גדלה ולכן כל עוד גדול מ 9% הלד יכבה, כלומר המעגל יוציא מתח אפסי ובכך מעגל החד יציב לא יופעל.

.5 תכנון מפורט ברמת החיבורים עבור בלוק מזיגת מים קרים.

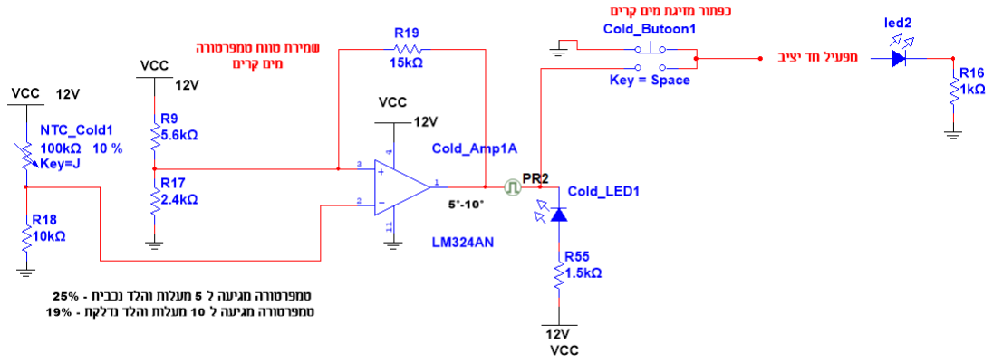
[picture p22: figure]

איור -19 מעגל מזיגת מים קרים.

ניתן לראות באיור ,19 כי בלוק "בקרת טווח טמפרטורה מים קרים" (איור 16) חובר במוצאו לכפתור המחובר למעגל החד יציב (הפועל לפי זמן מזיגה, איור 21), כך שכאשר טווח הטמפ' בין 5 ל 10 מעלות יתקבל מתח במוצא המגבר. כאשר כפתור המזיגה ילחץ, מתח מוצא המגבר יועבר להפעלת החד יציב, כך שכאשר הטפ' בטווח הרצוי תתאפשר מזיגת מים קרים.

הסבר על אופן פעולת המגבר:
כאשר הנגד המשתנה על 25% - טמפרטורה על 5 מ עלות והלד תכבה ובכך המעגל מאפשר מזיגת מים קרים (הסבר מפורט על אופן פעולת המגבר ניתן לראות באיור 16). כאשר הטמפרטורה עולה ההתנגדות של נגד הטמפ' קטנה ולכן כל עוד קטן מ 19% הלד נדלק, והמעגל יוציא מתח אפסי, מה שיגרום לכך שמעגל החד יציב לא יופעל. במצב זה לא תתאפשר מזיגה.

.6 תכנון מפורט ברמת החיבורים עבור בלוק עצירת מערכת בעת מזיגה ולחיצה.

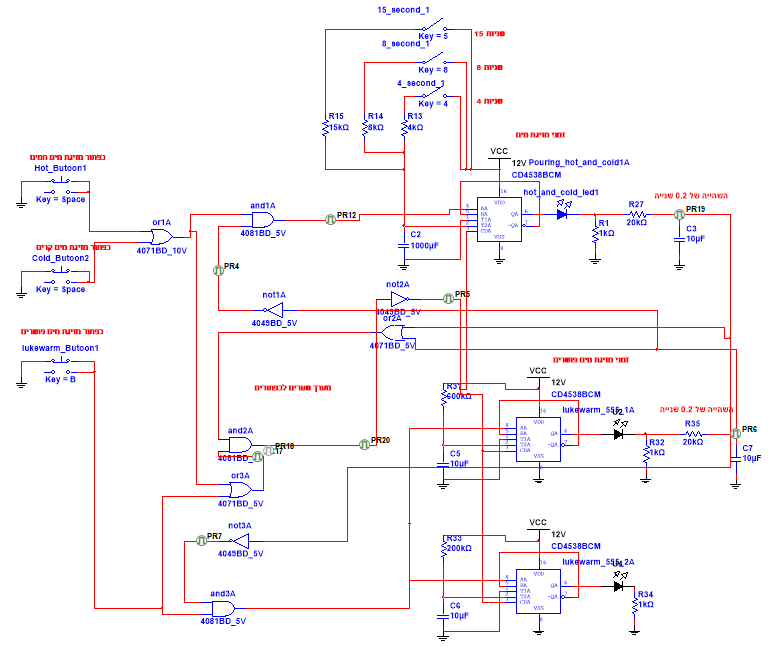
[picture p23: figure]

איור -20 בלוק עצירת מערכת בעת מזיגה ולחיצה.

באיור 20 ניתן לראות את המעגל שתפקידו לכבות את המשאבה כאשר נלחץ כפתור במערכת במהלך פעילות המשאבה. במעגל זה בוצע שימוש בשערים לוגים (AND ,NOT ,OR (על מנת לבדוק תנאים לוגיים ולבצע פעולות בהתאמה.

כמו כן חובר מעגל השהייה של [Sec[0.2 למוצאי החד יציב (האחרים על זמני המזיגה,

איורים ,21 22), מעגל ההשהיה חובר על מנת למנוע שגיאה כך שכאשר ילחץ כפתור מזיגת מים, המשאבה תפעל ותכבה בו זמנית עקב התנאים שהוגדרו. כאשר מעגל החד יציב פועל ונלחץ כפתור במערכת, מתבעת בדיקה דרך השערים הלוגיים

ומתקבל מתח של [V]0 לרגל 3 של החד יציב (רגל ה Reset (, מה שגורם לכיבוי מעגל החד

יציב ולהפסקת המזיגה.

.7 תכנון מפורט ברמת החיבורים עבור בלוק בקרת גודל כוס (זמני מזיגה).

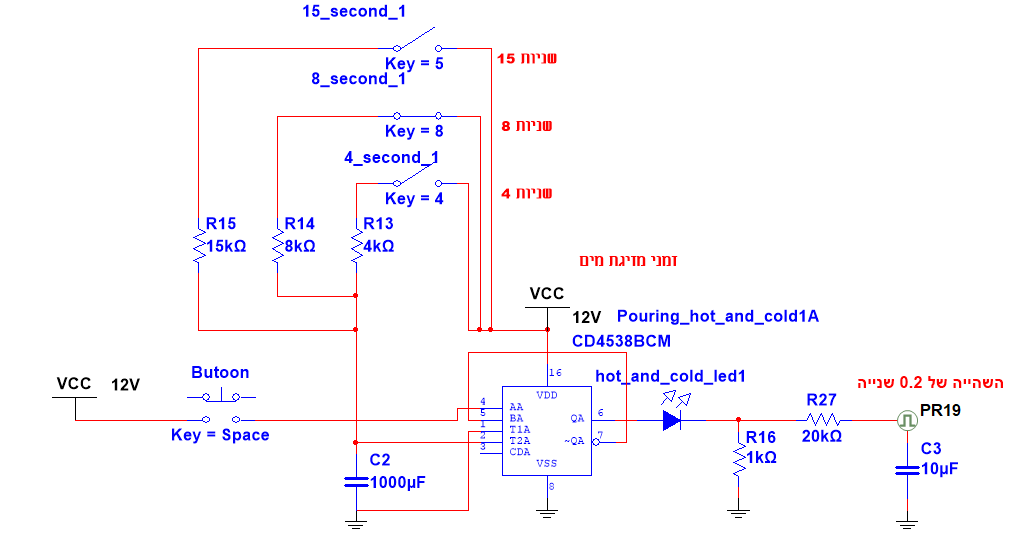
[picture p24: figure]

איור -21 מעגלי בקרת גדלי כוס. ניתן לראות באיור 21 כי בוצע שימוש ברכיב החד יציב על מנת לייצר פולס לזמן מוקצב להפעלת המשאבה של המים החמים והקרים בהתאם לזמן המזיגה הנבחר (גודל הכוס). ניתן לראות כי ישנם 3 ענפים עם נגדים אשר תפקידם זהה, ענפים אלו אחראיים על זמני המזיגה (4/8/15 שניות). כאשר מחברים את הענף עם המעגל נבחר זמן מזיגה (מעין בורר מצבים).
זמן המזיגה חושב לפי הנוסחה הבאה:

# 2 ∗ נבחרR = T (2)

תפקיד מעגל ההשהיה הינו לצורך בקרת הכיבוי במקרה של לחיצה בעת מזיגה (איור 20).

הסבר על אופן פעולת המעגל:
המשתמש בוחר את זמן המזיגה על ידי חיבור הענף וסגירת המעגל. במידה ונלחץ כפתור מזיגת מים מתקבל פולס אשר מפעיל את המערכת, במצב זה יתקבל פולס למשך זמן נבחר (לפי הענף המחובר) במוצא החד יציב, מה שיאפשר מזיגה למשך הזמן הנבחר.

.8 תכנון מפורט ברמת החיבורים עבור בלוק בקרת מים פושרים.

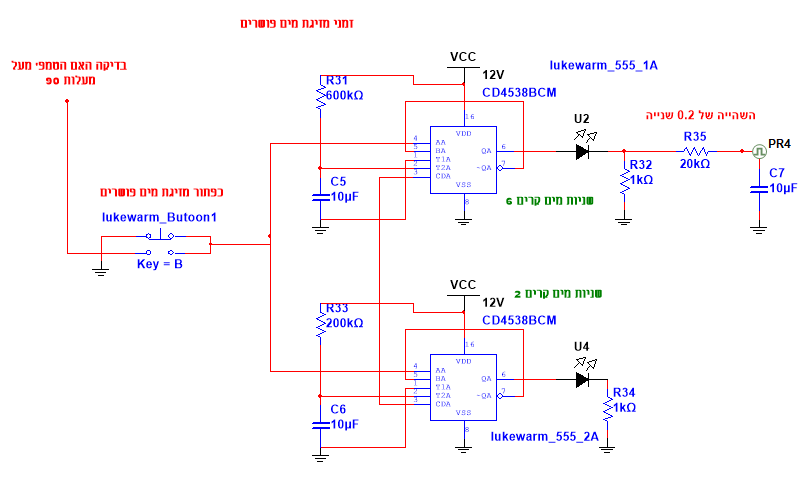
[picture p25: figure]

איור -22 מעגל בקרת מים פושרים. ניתן לראות באיור 22 כי בוצע שימוש ברכיבי החד יציב על מנת לייצר פולס לזמן מוקצב

להפעלת המשאבה של המים החמים והקרים על מנת למזוג מים פושרים (למשך [Sec[8(.

זמן המזיגה חושב לפי נוסחה (2). תפקיד מעגל ההשהיה במעגל העליון הינו לצורך בקרת הכיבוי במקרה של לחיצה בעת מזיגה (איור 20).

הסבר על אופן פעולת המעגלים: כאשר מתבצעת לחיצה על כפתור המים הפושרים, מתבצעת בדיקה האם הטמפ' מעל 90 מעלות (איור 18), במידה וכן מתקבל פולס בכניסות החד יציב אשר מפעיל אותם. המעגל העליון מחובר למשאבת המים הקרים והוא אחראי על מזיגת מים קרים למשך

[Sec[,6 והמעגל התחתון מחובר למשאבת המים החמים והוא אחראי על מזיגת מים קרים

# למשך [Sec[.2

במצב זה מתקבל טווח הטמפ' הרצוי למים הפושרים (ניתן לראות חישובים בטבלה 2).

.9 תכנון מפורט ברמת החיבורים עבור בלוק הצגת טמפרטורת חמים בזמן אמת.

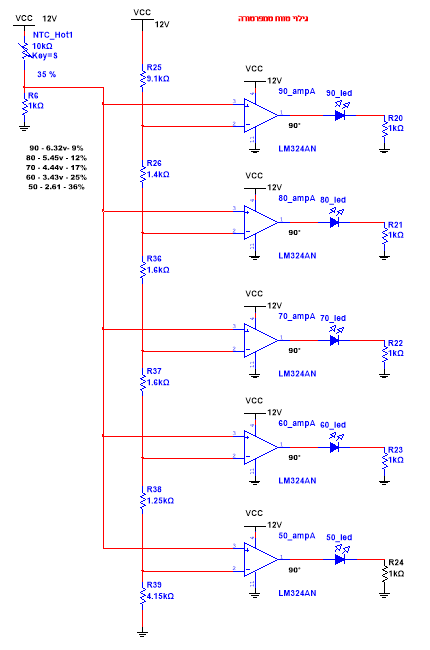
[picture p26: figure]

איור -23 מעגל הצגת טמפרטורת חמים בזמן אמת.

מאיור 23 ניתן לראות כי בוצע שימוש במספר מגברי משווה שתפקידם לבצע השוואה בין 2 רגלי הכניסה שלהם.
בוצע שימוש בענף נגדים שמשמשים כמחלק מתח הספקה אשר מתחברים לרגלי המינוס של המגבר, ולרגל הפלוס של המגברים חובר נגד הטמפ רטורה.

כאשר המתח ברגל פלוס (מתח של נגד הטמפרטורה) גדולה מרגל המינוס (מתח הסף המייצג ערך טמפרטורות) יתקבל במוצאי המגברים מתח בהתאמה, מה שיאפשר את הפעלת הלדים. מעגל זה מראה את ערך הטמפרטורה בזמן אמת, בטווח של 50-90 מעלות בקפיצות של 10 מעלות בין כל לד.

ניתן לראות בטבלה הבאה את ערך המתח המפעיל כל מגבר המייצג טמפרטורה: טבלה 3 – מתח כתלות בטמפרטורה.

מטבלה 3 ניתן לראות כי כל טמפרטורה מיוצגת כמתח הנכנס אל רגל הפלוס של המגבר. כמו כן, מתח הסף חושב לפי מחלק מתח (נוסחה 1) והופחת במעט כך שכאשר הטמפ' בערך הרצוי יתקבל מתח במוצא המגבר. מעגל זה מפעיל את הלדים המייצגים את ערך הטמפ' המדוד בזמן אמת.

[ טמפרטורה | ° | [V] מתח סף (רגל מינוס) [V] מתח נגד הטמפ' (רגל פלוס) ]
90 | 6.32 | 6.30
80 | 5.45 | 5.42
70 | 4.44 | 4.42
60 | 3.43 | 3.41
50 | 2.61 | 2.60

.10תכנון מפורט ברמת החיבורים עבור בלוק אזהרה מפני גלישת מים.

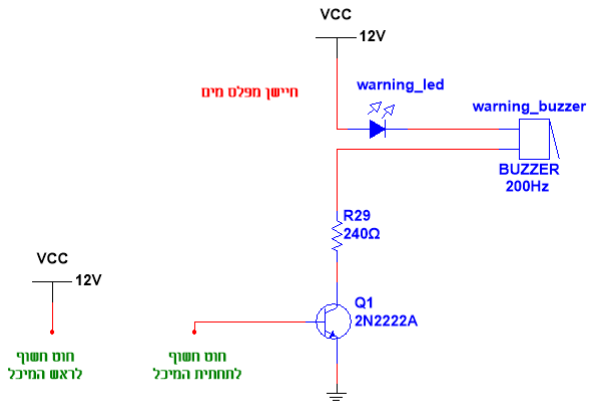
[picture p27: figure]

איור -24 מעגל אזהרה מפני גלישת מים.

באיור 24 ניתן כי בוצע שימוש בטרנזיסטור מסוג NPN אשר משמש כמתג. כמו כן ניתן לראות שלרגל ה BASE של הטרנזיסטור חובר חוט קצר חשוף אשר מחובר לתחתית מיכל המים. בנוסף חובר חוט חשוף נוסף אשר מחובר למתח ההספקה של המערכת, חוט זה מחובר לראש מיכל המים. במעגל זה בוצע שימוש בתכונת המים אשר הינם מוליכים.

הסבר על אופן פעולת המעגל:
כאשר מפלס המים עולה עד לסוף המיכל, המעגל נסגר וזורם זרם ל BASE של הטרנזיסטור.
במצב זה הטרנזיסטור במצב פעיל, מה שמאפשר זרימת זרם בין האמיטר לקולקטור, במצב זה יופעל לד וזמזם אזהרה.
כאשר אין סגירת מעגל (מפלס המים נמוך) הטרנזיסטור במצב קיטעון והלד והזמזם לא יופעלו.

.11תכנון מפורט ברמת החיבורים עבור בלוק משך זמן נותר למילוי כוס.

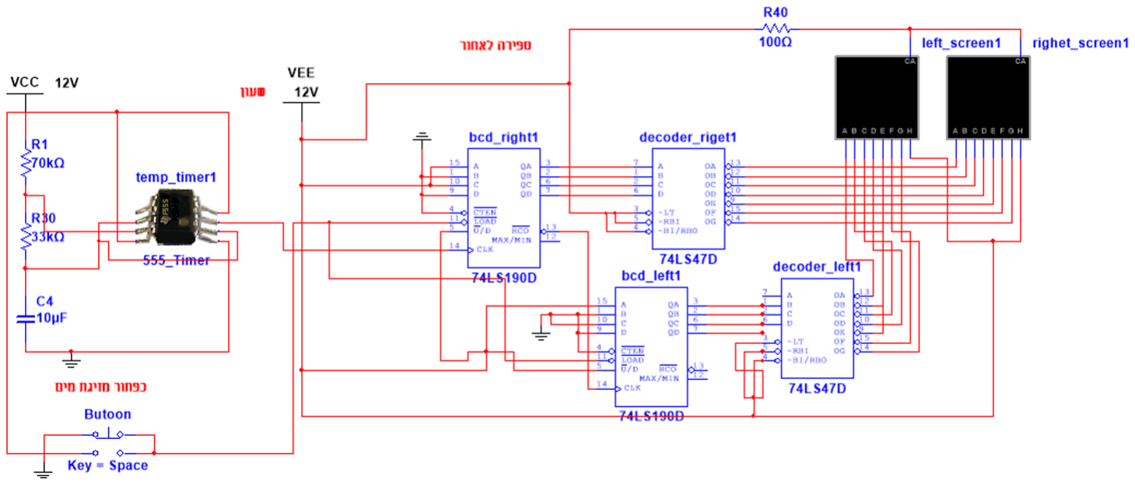
[picture p28: figure]

איור -25 מעגל הצגת משך זמן נותר למילוי כוס.

במעגל שבאיור 25 ניתן להבחין בשני מעגלים עיקריים:
- מעגל ספירה לאחור – מעגל זה בנוי ממספר רכיבים: .1 רכיב BCD אשר תפקידו לספור מ 9 עד ,0 מונה זה סופר מטה ע"י הכנסת ערך '1' לוגי לרגל .5 ניתן להכניס לרגלי הרכיב (9,10,1,15) ערך ממנו המונה יתחיל למנות מטה. כאשר כפתור המזיגה ילחץ יתקבל ערך לוגי '1' לרגל LOAD) רגל 11) המונה יתחיל למנות המערך הנבחר ומטה (לפי בחירת המשתמש). רכיב זה משורשר לרכיב BCD נוסף (הרכיב התחתון) אשר אחראי על ספרת העשרות, כאשר העליון אחראי על ספרת היחידות. ניתן לראות כי מוצאי הרכיבים מחוברים לרכיב ה Decoder. .2 רכיב Decoder אשר תפקידו להמיר את הכניסות שמקבל (ממוצאי המונה הבינארי) למספר יציאות גדול יותר ובכך מאפשר להדפיס בעזרת רכיב ה Segment 7 להדפיס את ערף מוצא המונה הבינארי כספרה עשרונית. .3 רכיב Segment 7 אשר תפקידו להראות את ערך מוצאי המונה הבינארי ולהציג את הערך כמספר עשרוני (ע"י מעבר ברכיב ה Decoder (
- שעון לספירת המונה הבינארי - מעגל זה בנוי מרכיב 555 אשר זמן המחזור שלו הינו

# .1[Sec]

מוצא השעון חובר לרגל השעון (רגל 14) של רכיב ה BCD, מה שמאפשר מנייה בכל שנייה.

בטבלה הבאה ניתן לראות את ערכי כניסות המונה הבינארי (9,10,1,15) ואיזה מספר עשרוני הם מייצגות.
טבלה 4 – ערכי כניסות המונה הבינארי.
| | | BCD עליון (אחדות) BCD תחתון (עשרות) ערך בינארי ערך עשרוני
| אחדות עשרות | 9 MSB | 10 | 1 | 15 LSB | 9 MSB | 10 | 1 | 15 LSB
15 | 0001 | 0101 | 0 | 0 | 0 | 1 | 0 | 1 | 0 | 1
8 | 0000 | 1000 | 0 | 0 | 0 | 0 | 1 | 0 | 0 | 0
4 | 0000 | 0100 | 0 | 0 | 0 | 0 | 0 | 1 | 0 | 0

ניתן לראות בטבלה 4 את ערכי הכניסות של המונה הבינארי (רגלים 9,10,1,15) וכיצד ניתן להגדיר מאיזה ערך עשרוני הספירה מטה תחל, בהתאם לבחירת המשתמש. רכיב ה BCD פועל כך שכאשר לא מחובר ערך לכניסות 9,10,1,15 הוא יתחיל למנות מ ,9 כלומר חשוב לשים לב ולחבר אדמה בכניסות הרצויות שיהיו 0 לוגי בהתאם לטבלה.

.12תכנון מפורט ברמת החיבורים עבור מעגל מייצב מתח.

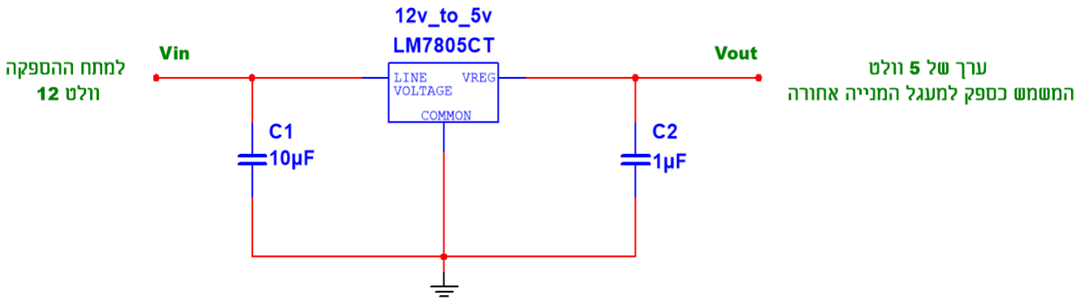
[picture p29: figure]

איור -26 מעגל המייצב מתח.
באיור 26 ניתן לראות מעגל מייצב מתח, תפקיד מעגל זה הוא להמיר מתח של [V]12 למתח

# של [V].5

הצורך במעגל זה נובע בגלל הגבלת מתח ההספקה של רכיב ה BCD מסעיף 11 (איור 25).

הגבלת מתח הרכיב הינה עד ל [V],5 כאשר מתח האספקה של המערכת הינו [V].12

מעגל זה בנוי מרכיב 7805LM בשילוב עם 2 קבלים.

רכיב זה פועל כך שבכניסתו מתקבל מתח מסוים, והוא מוציא מתח קבוע של [V],5 הפרש

המתח נופל על הרכיב עצמו.

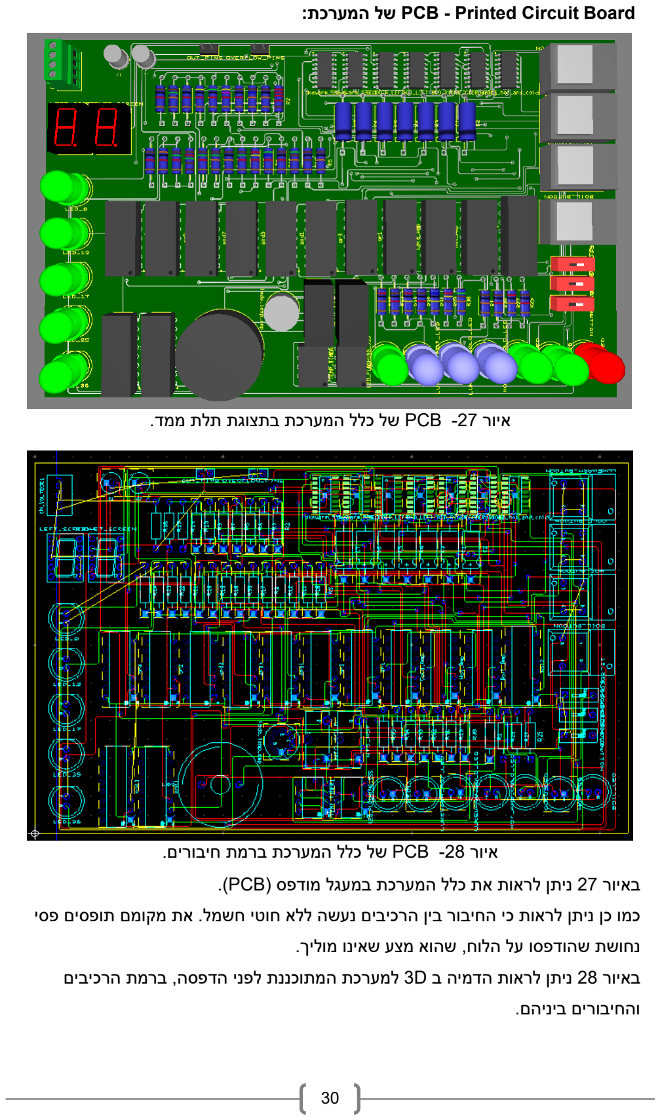
[picture p30: page 31]

: | המערכת | של PCB - Printed Circuit Board

איור -27 PCB של כלל המערכת בתצוגת תלת ממד.

איור -28 PCB של כלל המערכת ברמת חיבורים.
באיור 27 ניתן לראות את כלל המערכת במעגל מודפס (PCB(. כמו כן ניתן לראות כי החיבור בין הרכיבים נעשה ללא חוטי חשמל. את מקומם תופסים פסי נחושת שהודפסו על הלוח, שהוא מצע שאינו מוליך. באיור 28 ניתן לראות הדמיה ב D3 למערכת המתוכננת לפני הדפסה, ברמת הרכיבים והחיבורים ביניהם.

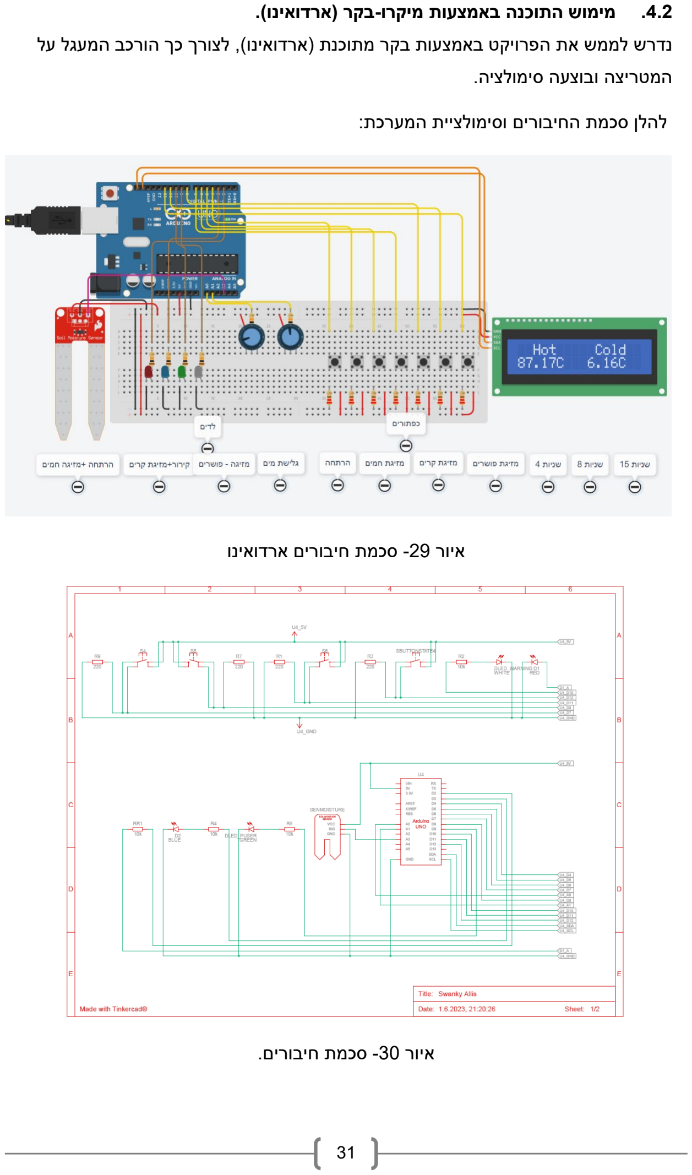
[picture p31: page 32]

.4.2 מימוש התוכנה באמצעות מיקרו-בקר ( ארדואינו). נדרש לממש את הפרויקט באמצעות בקר מתוכנת (ארדואינו), לצורך כך הורכב המעגל על המטריצה ובוצעה סימולציה.
להלן סכמת החיבורים וסימולציית המערכת:

איור -29 סכמת חיבורים ארדואינו

איור -30 סכמת חיבורים.

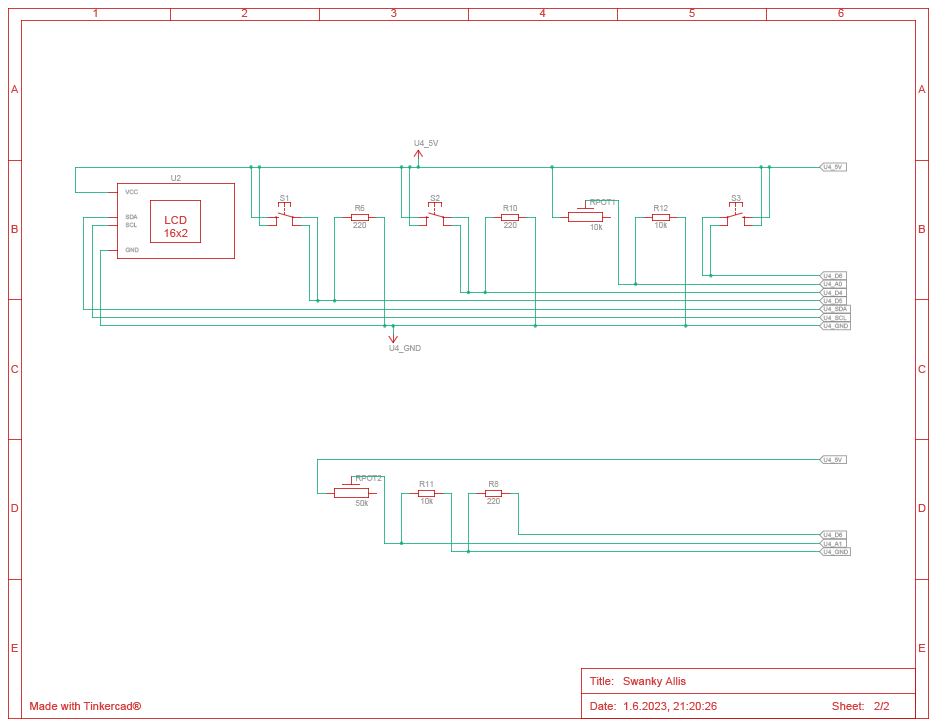
[picture p32: figure]

איור -31 סכמת חיבורים.
באיור 29 ניתן לראות את הסימולציה וסכמת חיבור המעגל לצורך מימוש הפרויקט באמצעות בקר מתוכנת.
באיורים ,30 31 ניתן לראות את סכמת החיבורים עם ערכי הרכיבים ששמשו לצורך בניית מערכת זו.
לאחר מכן בוצע שימוש בתוכנת IDE Arduino ונכתב קוד המתאים לדרישות המערכת. קוד זה נכתב בשפת תכנות "++C "ובוצע שימוש במגוון ספריות ע"מ לבצע שימוש ברכיבים אשר במעגל.
קוד זה נכתב ונבנה לפי תרשים הזרימה (איור 14) , תוך מתן תשומת לב לדרישות ולהתניות של המערכת.
לצורך חישוב ערך טמפרטורת חיישן ה NTC בוצע שימוש בנוסחה הבאה:

# (3)HHHH TT TT TTTT = 1 0.001129148+0.000234125∗nn nn_ll +0.0000000876741∗(NNNN llll)3 −

273.15

כאשר:

# (4)NN ll = log ((5 ∗ 10

# (RRNNNNNN) ∗ 5

1023

− 10) ∗ 1000)

נוסחה זו נרשמה כקוד וכך ניתן לקבל את הטמפרטורה בזמן אמת לפי התנגדות חיישן הטמפרטורה.
לאחר סיום כתיבת הקוד, הקוד הועלה ללוח ה UNO לצורך הפעלת המערכת ובדיקתה.

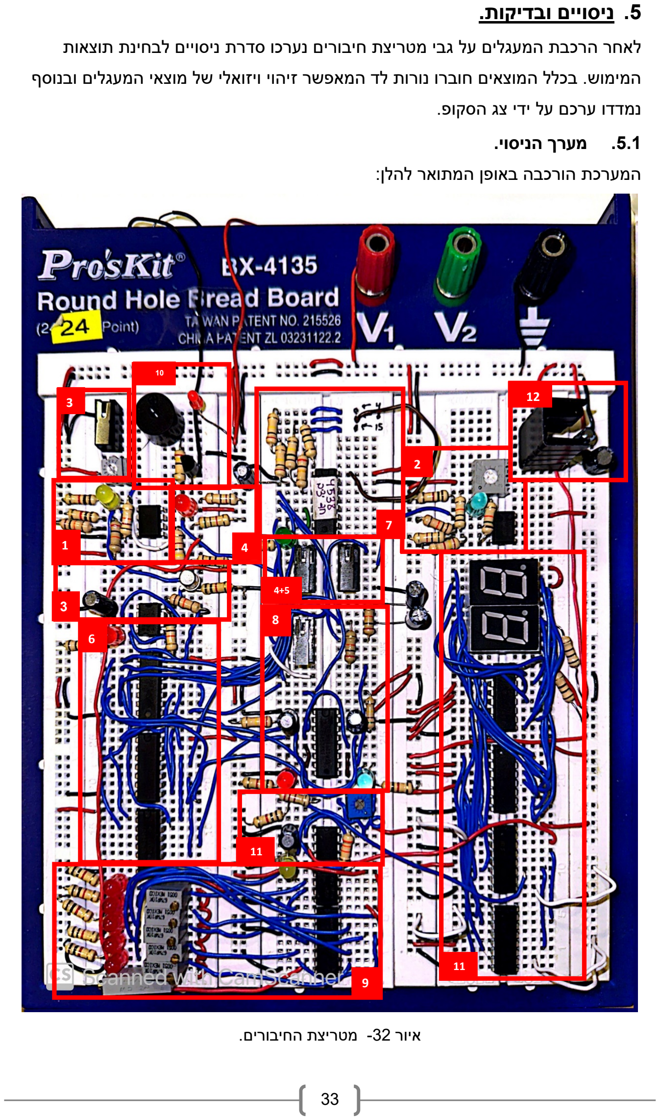
[picture p33: page 34]

.5 ניסויים ובדיקות .
לאחר הרכבת המעגלים על גבי מטריצת חיבורים נערכו סדרת ניסויים לבחינת תוצאות המימוש. בכלל המוצאים חוברו נורות לד המאפשר זיהוי ויזואלי של מוצאי המעגלים ובנוסף נמדדו ערכם על ידי צג הסקופ. .5.1 מערך הניסוי.
המערכת הורכבה באופן המתואר להלן:

איור -32 מטריצת החיבורים.

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
.5.2 מכשירי המדידה.
לצורך בדיקת תקינות מעגל בקרת טווח טמפרטורת מים חמים שנמצא בבלוק 1 באיור 32 במטריצה, ובסכמת החיבורים באיור ,15 חובר הסקופ למעגל. להלן תוצאות צג הסקופ:

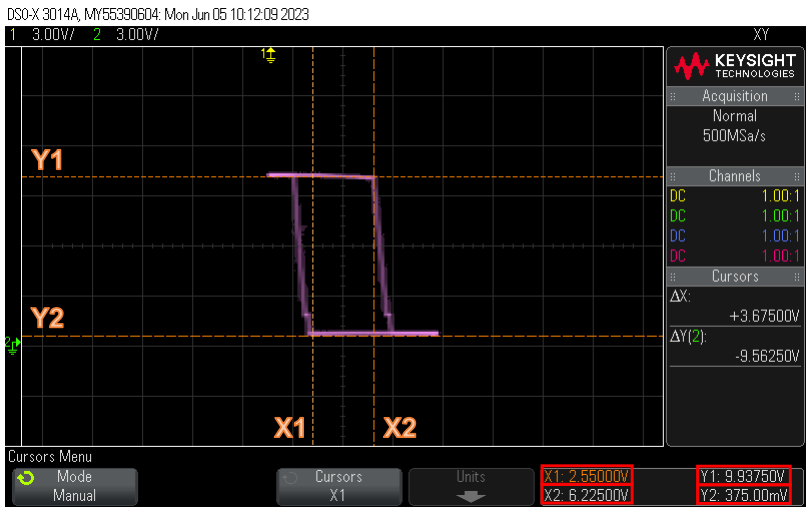
[picture p34: figure]

איור -33 מעגל בקרת טווח טמפרטורת מים חמים.

ניתן לראות באיור 33 את תצורת מעגל בקרת טווח טמפרטורת מים חמים במישור XY. בנוסף, ניתן להבחין כי מדובר בעקומת חשל ברורה שערכי הסף שלה מסומנים באמצעות .Cross X2 -ו Cross X1
עקומת חשל (עקומת היסטרזיס) היא עיכוב בתגובה לעירור של מערכת. ברגע שאות הכניסה מגיע למתח הסף התחתון (1X Cross (מתקבל במוצא 1 לוגי וברגע שאות הכניסה מגיע למתח הסף העליון (2X Cross (אות המוצא מקבל ערך של 0 לוגי. ערכי הסף 1X Cross ו- 2X Cross שהתקבלו הינם בהתאמה [V[2.55 ו- [V[.6.225 ערכים מדודים אלה כמעט זהים לערכים התיאורטיים שהינם:

מתח [V[2.6 מצביע על °C50 ומתח [V[6.25 מצביע על °C.90

ניתן לראות את הערכים התיאורטיים בטבלה .1 מתוך כך ניתן לראות כי אכן טווח הטמפרטורה הרצוי נשמר.

לצורך בדיקת תקינות מעגל בקרת טווח טמפרטורת מים קרים שנמצא בבלוק 2 באיור 32 במטריצה, ובסכמת החיבורים באיור ,16 חובר הסקופ למעגל. להלן תוצאות צג הסקופ:

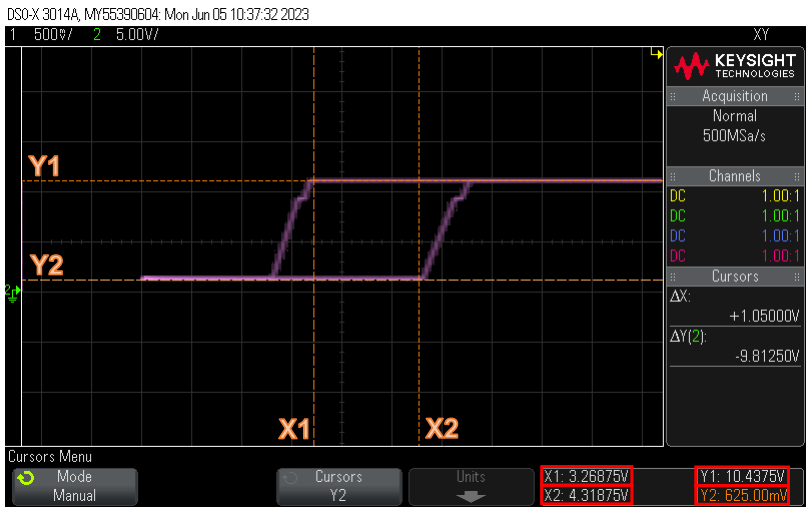
[picture p35: figure]

איור -34 מעגל בקרת טווח טמפרטורת מים קרים.

ניתן לראות באיור 34 את תצורת מעגל בקרת טווח טמפרטורת מים קרים במישור XY. בנוסף, ניתן להבחין כי מדובר בעקומת חשל ברורה שערכי הסף שלה מסומנים באמצעות .Cross X2 -ו Cross X1
עקומת חשל (עקומת היסטרזיס) היא עיכוב בתגובה לעירור של מערכת. ברגע שאות הכניסה מגיע למתח הסף התחתון (1X Cross (מתקבל במוצא 0 לוגי וברגע שאות הכניסה מגיע למתח הסף העליון (2X Cross (אות המוצא מקבל ערך של 1 לוגי. ערכי הסף 1X Cross ו- 2X Cross שהתקבלו הינם בהתאמה [V[3.27 ו- [V[.4.31 ערכים מדודים אלה קרובים מאוד לערכים התיאורטיים שהינם:

מתח [V[3.39 מצביע על 5° ומתח [V[4.02 מצביע על °C.10

ניתן לראות את הערכים התיאורטיים בטבלה .1 מתוך כך ניתן לראות כי אכן טווח הטמפרטורה הרצוי נשמר.

לצורך בדיקת תקינות מעגל הרתחת מים חמים שנמצ א בבלוק 3 + 4 באיור 32 במטריצה, ובסכמת החיבורים באיור ,17 חובר הסקופ למעגל. להלן תוצאות צג הסקופ:

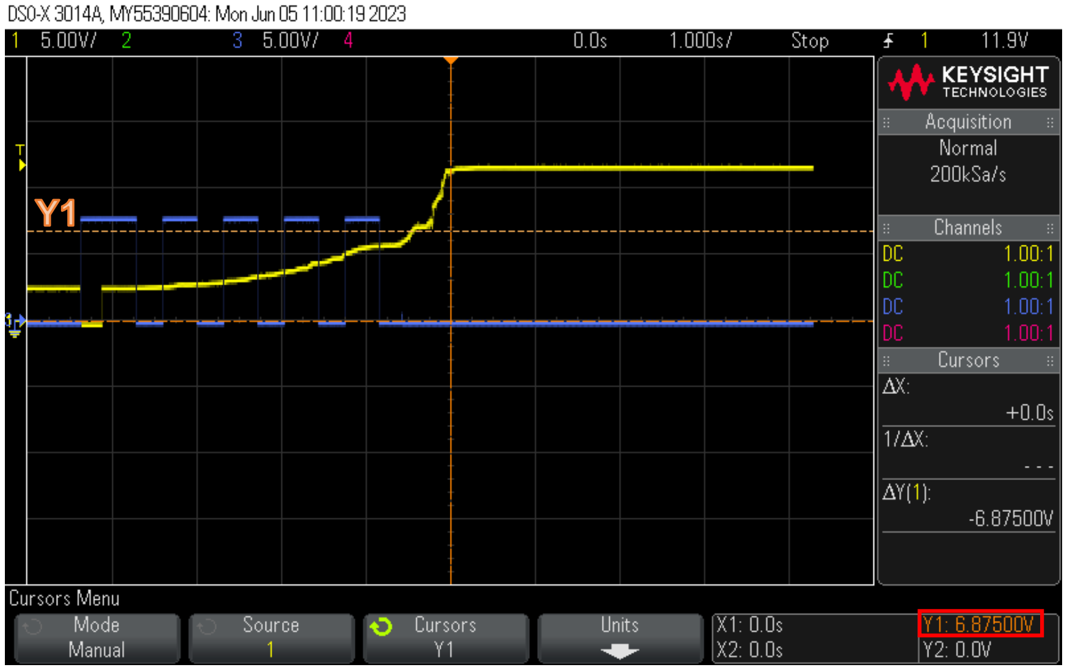
[picture p36: figure]
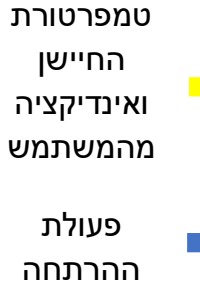
[picture p37: figure]
טמפרטורת החיישן ואינדיקציה מהמשתמש; פעולת ההרתחה

איור -35 מעגל הרתחת מי ם חמים.

ניתן לראות באיור 34 שני גרפים. בגרף הצהוב ניתן לראות את טמפרטורת החיישן באמצעות המתח עליו (ככל שטמפרטורת המים עולה כך יורד ערך ההתנגדות של החיישן וכתוצאה מכך המתח על החיישן עולה) ואת אינדיקציית ההפעלה מהמשתמש, בנוסף, ניתן לראות אות 'הלם' שלילי הנוצר מלחיצת המשתמש על כפתור מזיגת המים החמים. בגרף הכחול ניתן לראות את הבהוב נורת ההרתחה. ניתן להבחין כי לאחר שמתקבלת בגרף הצהוב אינדיקציה (לחיצת כפתור) מהמשתמש מתקבל בגרף הכחול אות ריבועי שמראה את הבהוב נורת ההרתחה, בנוסף לכך, המתח על החיישן גדל (כלומר הטמפרטורה גדלה) עד אשר הוא מגיע למתח של [V[6.875 שמצביע על

°C,97 מתח מדוד זה כמעט זהה לערכו התיאורטי שהוא [V[6.89 לפי טבלה .1

כאשר המתח על החיישן מגיע למתח זה ניתן לראות את הפסקת האות הריבועי, מתוך זה

ניתן לראות שהסתיימה פעולת ההרתחה ל- °C.97

לצורך בדיקת תקינות מעגל מזיגת מים חמים שנמצא בבלוק 4 + 5 באיור 32 במטריצה, ובסכמת החיבורים באיור ,18 חובר הסקופ למעגל. להלן תוצאות צג הסקופ:

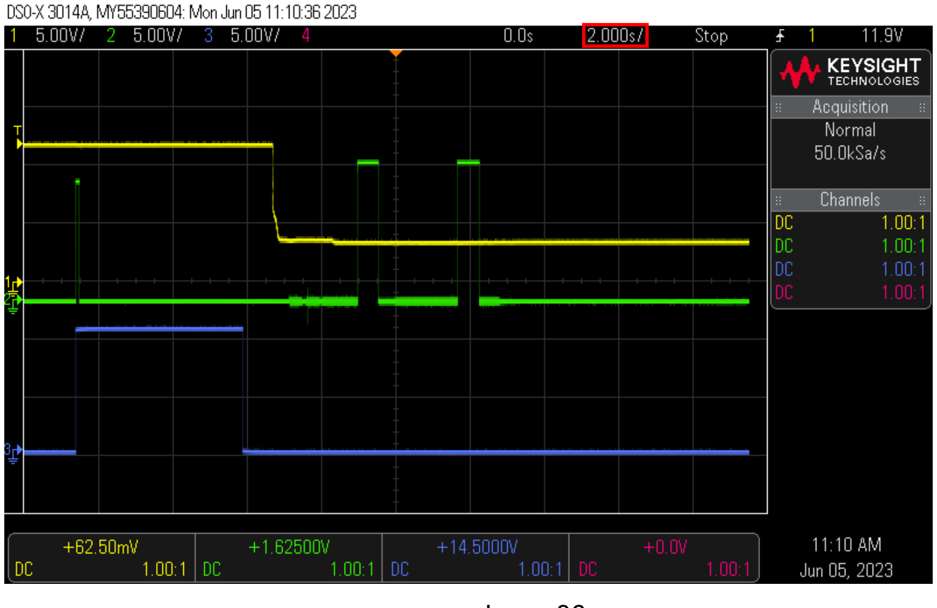
[picture p38: figure]
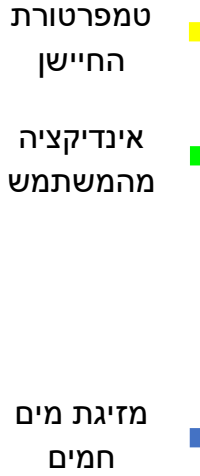
[picture p39: figure]
טמפרטורת החיישן; אינדיקציה מהמשתמש; מזיגת מים חמים

איור -36 מעגל מזיגת מים חמים.

ניתן לראות באיור 36 שלושה גרפים. בגרף הצהוב ניתן לראות את טמפרטורת החיישן באמצעות המתח עליו (ככל שטמפרטורת המים עולה כך יורד ערך ההתנגדות של החיישן וכתוצאה מכך המתח על החיישן עולה). בגרף הירוק ניתן לראות 'הלמים', הלמים אלו נוצרים מלחיצתו של המשתמש על מתג המזיגה.
בגרף הכחול ניתן לראות את משך פעולת המזיגה. כל ריבוע בתצוגה מייצג [Sec[2 וכי רוחבו של הפולס המתקבל הוא בערך שני ריבועים, דבר זה מראה על תקינות זמן המזיגה ([Sec[4(. ניתן להבחין בשלושה ניסיונות מזיגת מים מהמשתמש ('הלמים') כאשר רק הניסיון הראשון מצליח לגרום לפעולת מזיגה בעוד הניסיונות האחרים לא מצליחים, שוני זה נובע מכך

שטמפרטורת המים מעל °C90 רק בזמן ניסיון הלחיצה הראשון, בעוד שניתן לראות שלאחר

מכן בזמן הניסיונות האחרים המתח על החיישן ירד משמעותית, כלומר טמפרטורת המים

ירדה מ- °C,90 לכן ניסיונות הלחיצה האחרים לא מצליחים לגרום לפעולת מזיגה.

לצורך בדיקת תקינות מעגל מזיגת מים קרים שנמצא בבלוק 2 + 4 + 5 באיור 32 במטריצה, ובסכמת החיבורים באיור ,19 חובר הסקופ למעגל. להלן תוצאות צג הסקופ:

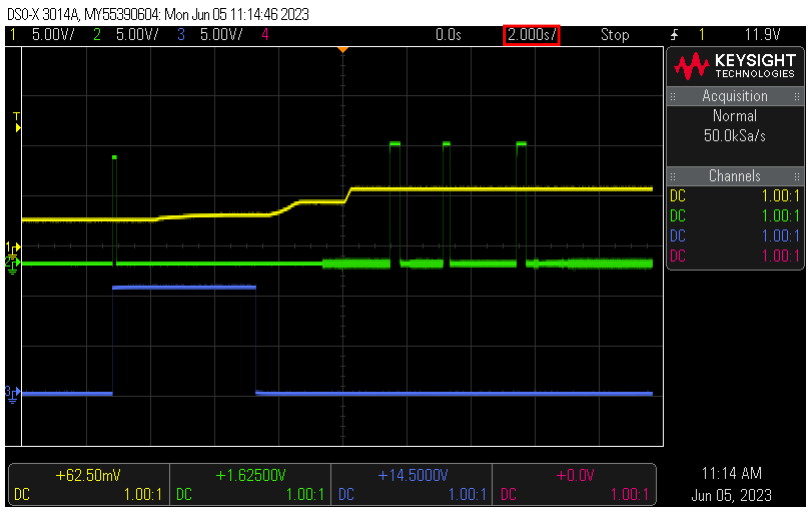
[picture p40: figure]
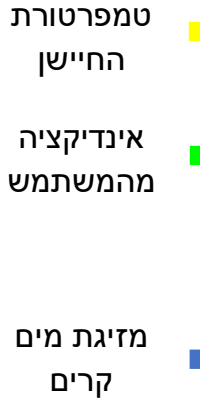
[picture p41: figure]
טמפרטורת החיישן; אינדיקציה מהמשתמש; מזיגת מים קרים

איור -37 מעגל מזיגת מים קרים.

ניתן לראות באיור 37 שלושה גרפים. בגרף הצהוב ניתן לראות את טמפרטורת החיישן באמצעות המתח עליו (ככל שטמפרטורת המים עולה כך יורד ערך ההתנגדות של החיישן וכתוצאה מכך המתח על החיישן עולה). בגרף הירוק ניתן לראות 'הלמים', הלמים אלו נוצרים מלחיצתו של המשתמש על מתג המזיגה.
בגרף הכחול ניתן לראות את משך פעולת המזיגה. כל ריבוע בתצוגה מייצג [Sec[2 וכי רוחבו של הפולס המתקבל הוא בערך שני ריבועים, דבר זה מראה על תקינות זמן המזיגה ([Sec[4(. ניתן להבחין בארבעה ניסיונות מזיגת מים מהמשתמש ('הלמים') כאשר רק הניסיון הראשון מצליח לגרום לפעולת מזיגה בעוד הניסיונות האחרים לא מצליחים, שוני זה נובע מכך

שטמפרטורת המים בטווח הרצוי °C10 > ttttttt > °C5 רק בזמן ניסיון הלחיצה הראשון,

בעוד שניתן לראות שלאחר מכן בזמן הניסיונות האחרים המתח על החיישן עלה משמעותית,

כלומר טמפרטורת המים עלתה מ- °C10 וכבר לא בטווח הרצוי, לכן ניסיונות הלחיצה

האחרים לא מצליחים לגרום לפעולת מזיגה.

לצורך בדיקת תקינות מעגל הפסקת מזיגת מים שנמצא בבלוק 6 באיור 32 במטריצה, ובסכמת החיבורים באיור ,20 חובר הסקופ למעגל. להלן תוצאות צג הסקופ:

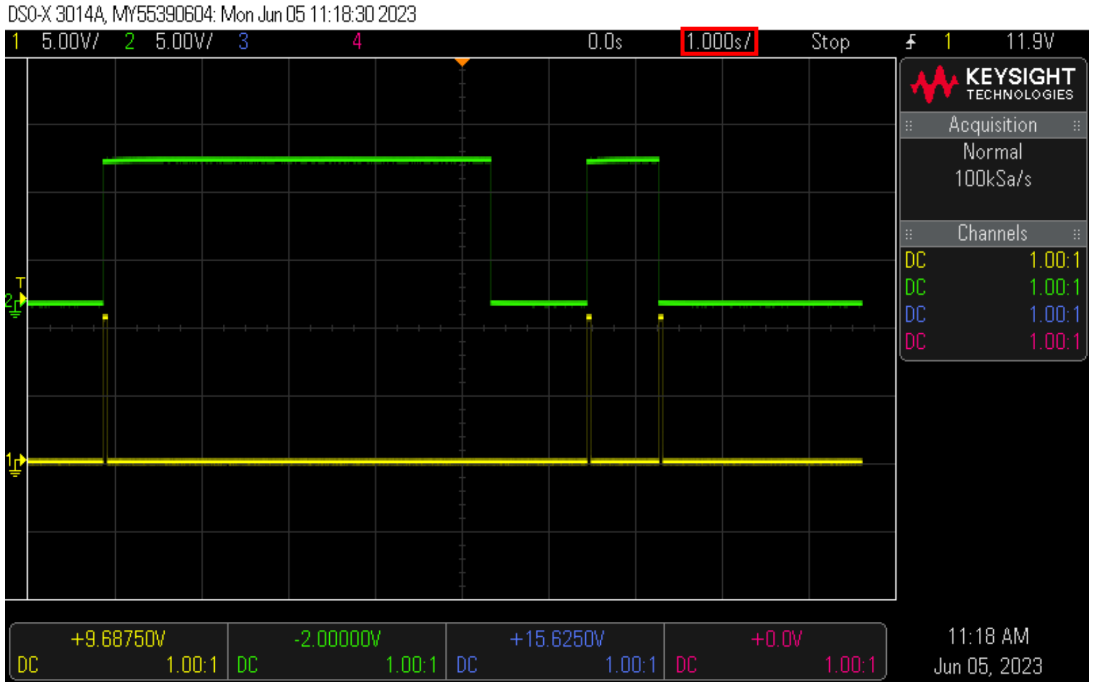
[picture p42: figure]

איור -38 מעגל הפסקת מזיגת מים.

ניתן לראות באיור 38 שני גרפים. בגרף הירוק ניתן לראות את משך פעולת מזיגת המים. בגרף הצהוב ניתן לראות ' הלמים', הלמים אלו נוצרים מלחיצתו של המשתמש על מתג המזיגה.
כל ריבוע בתצוגה מייצג [Sec[.1 בניסיון הלחיצה הראשון ניתן להבחין שזמן המזיגה הוא [Sec[,4 בערך 4 ריבועים, לאחר מכן, בוצע ניסיון הלחיצה השני וניתן לראות כי התחילה שוב פעולת מזיגה, לבסוף, בוצע ניסיון הלחיצה השלישי וניתן לראות שפעולת המזיגה שהתחילה בניסיון המזיגה הקודם נקטעה ונעצרה.
קטיעה זו נוצרת כתוצאה מלחיצה חוזרת על אחד מלחצני המערכת, דבר הגורם לעצירה מוחלטת של פעולת המזיגה לפי הדרישות.

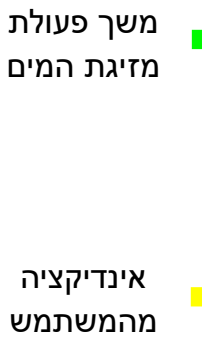
[picture p43: figure]
משך פעולת מזיגת המים; אינדיקציה מהמשתמש

לצורך בדיקת תקינות מעגל הגדרת גודל הכוס שנמצא בבלוק 7 באיור 32 במטריצה, ובסכמת החיבורים באיור ,21 חובר הסקופ למעגל. להלן תוצאות צג הסקופ:

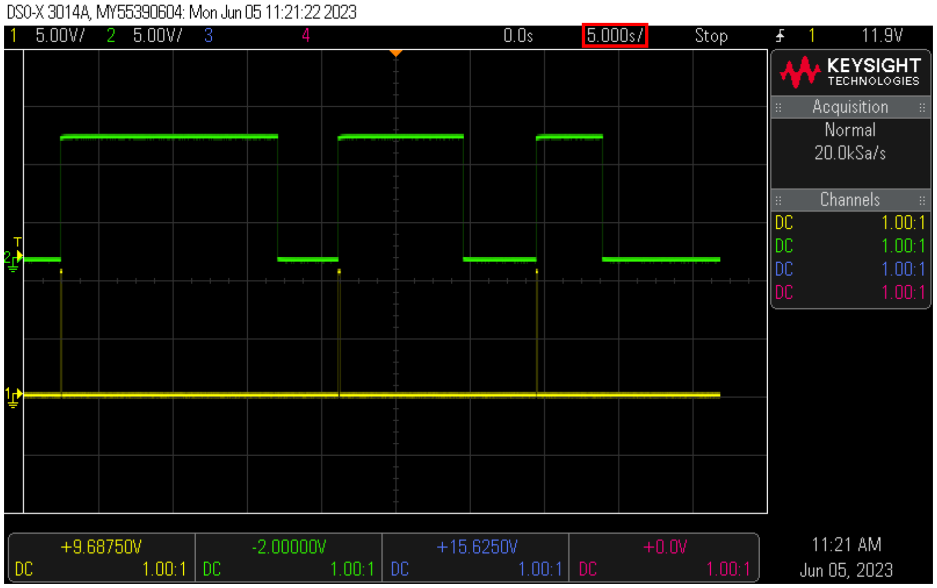
[picture p44: figure]

איור -39 מעגל הגדרת גודל הכוס.

ניתן לראות באיור 39 שני גרפים. בגרף הירוק ניתן לראות את זמני מזיגת המים. בגרף הצהוב ניתן לראות ' הלמים', הלמים אלו נוצרים מלחיצתו של המשתמש על מתג המזיגה.
כל ריבוע בתצוגה מייצג [Sec[.5 בכל פעם ברגע שמתקבל מהמשתמש לחיצת מזיגת מים נוכל להבחין שמתחיל פולס, כל פעם באורך אחר, דבר זה נובע מהבחירה שהמשתמש מזין למערכת. בלחיצה הראשונה ניתן להבחין באורך פולס המשתרע על בערך 3 משבצות אשר מייצג את זמן המזיגה הארוך שהוא [Sec[,15 לאחר מכן בלחיצה השנייה ישנו פולס המשתרע על בערך משבצת וחצי אשר מייצג את זמן המזיגה הבינוני שהוא [Sec[8 ולבסוף בלחיצה השלישית ישנו פולס המשתרע על כמעט משבצת אחת אשר מייצג את זמן המזיגה הקצר שהוא [Sec[.4

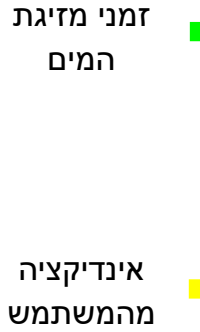
[picture p45: figure]
זמני מזיגת המים; אינדיקציה מהמשתמש

לצורך בדיקת תקינות מעגל מזיגת מים פושרים שנמצא בבלוק 8 באיור 32 במטריצה, ובסכמת החיבורים באיור ,22 חובר הסקופ למעגל. להלן תוצאות צג הסקופ:

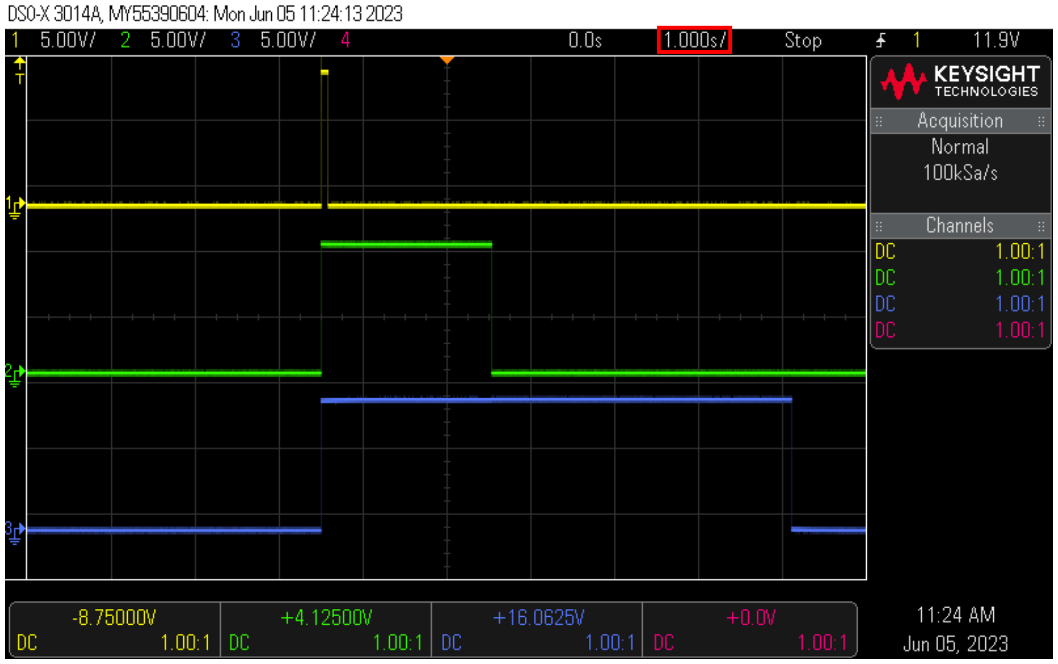
[picture p46: figure]

איור -40 מעגל מזיגת מים פושרים.

ניתן לראות באיור 40 שלושה גרפים. בגרף הצהוב ניתן לראות ' הלמים', הלמים אלו נוצרים מלחיצתו של המשתמש על מתג המזיגה.
בגרף הירוק ניתן לראות את משך פעולת המזיגה של המים החמים ובגרף הכחול את משך פעולת המזיגה של המים הקרים. כל ריבוע בתצוגה מייצג [Sec[.1 לאחר ניסיון הלחיצה מהמשתמש ניתן לראות את משך זמן המזיגה של המים החמים שהוא [Sec[,2 בערך 2 משבצות ואת משך זמן המזיגה של המים הקרים שהוא [Sec[,6 כמעט 6 משבצות.
ערכים מדודים אלו קרובים וכמעט זהים לערכים התיאורטיים שחושבו באמצעות טבלה .2

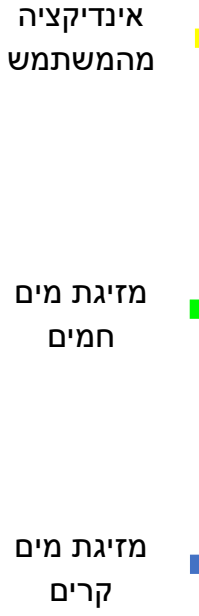
[picture p47: figure]
אינדיקציה מהמשתמש; מזיגת מים חמים; מזיגת מים קרים

לצורך בדיקת תקינות מעגל הצגת טמפרטורת מים חמים בזמן אמת שנמצא בבלוק 9 באיור 32 במטריצה, ובסכמת החיבורים באיור ,23 חובר הסקופ למעגל. להלן תוצאות צג הסקופ:

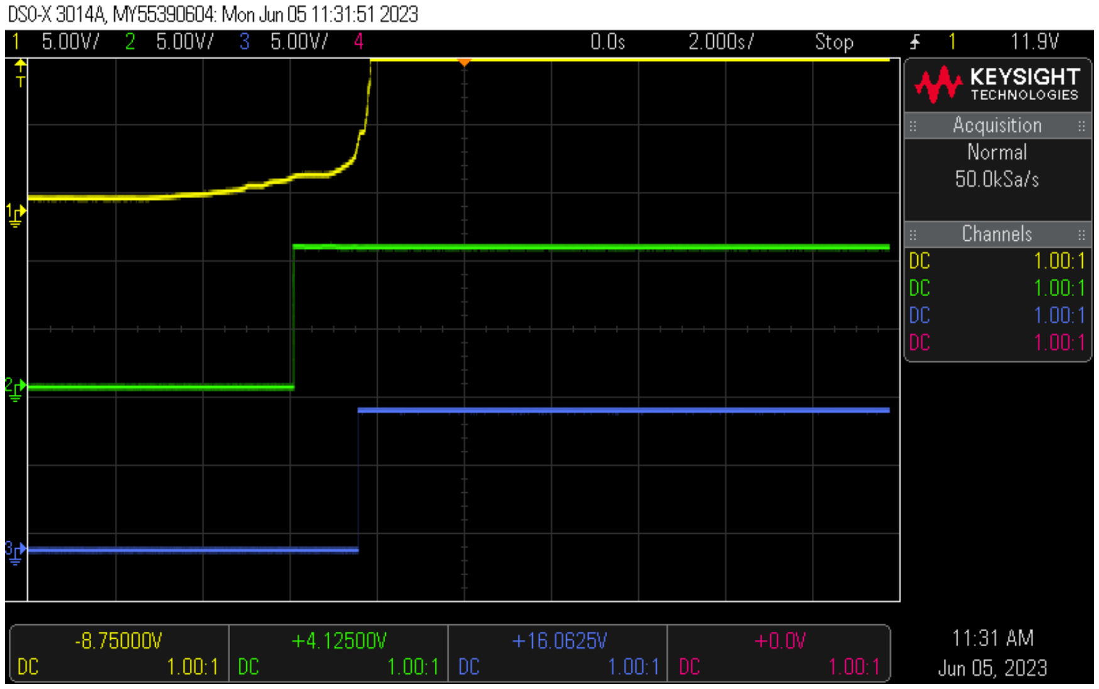
[picture p48: figure]

איור -41 מעגל הצגת טמפרטורת מים חמים בזמן אמת.

ניתן לראות באיור 41 שלושה גרפים. בגרף הצהוב ניתן לראות את טמפרטורת החיישן באמצעות המתח עליו (ככל שטמפרטורת המים עולה כך יורד ערך ההתנגדות של החיישן וכתוצאה מכך המתח על החיישן עולה). לאחר מכן טמפרטורת החיישן גדלה וניתן לראות שינויים בגרפים הירוק והכחול. בגרף הירוק ניתן לראות לאחר שטמפרטורת החיישן גדלה קצת את הדלקת נורת הלד

הראשונה שמסמלת שטמפרטורת המים הגיעה לטווח °C60 − °C.50

בגרף הכחול ניתן לראות לאחר שטמפרטורת החיישן גדלה יותר את הדלקת נורת הלד

האחרונה שמסמלת שטמפרטורת המים הגיעה ליותר מ- °C.90

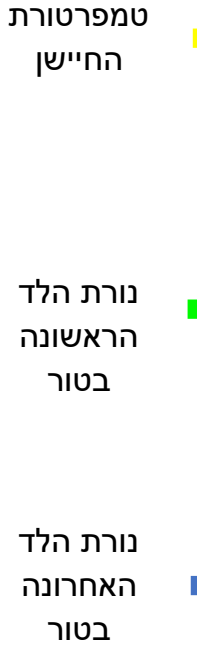
[picture p49: figure]
טמפרטורת החיישן; נורת הלד הראשונה בטור; נורת הלד האחרונה בטור

לצורך בדיקת תקינות מעגל אזהרה מפני גלישת מים שנמצא בבלוק 10 באיור 32 במטריצה, ובסכמת החיבורים באיור ,24 חובר הסקופ למעגל. להלן תוצאות צג הסקופ:

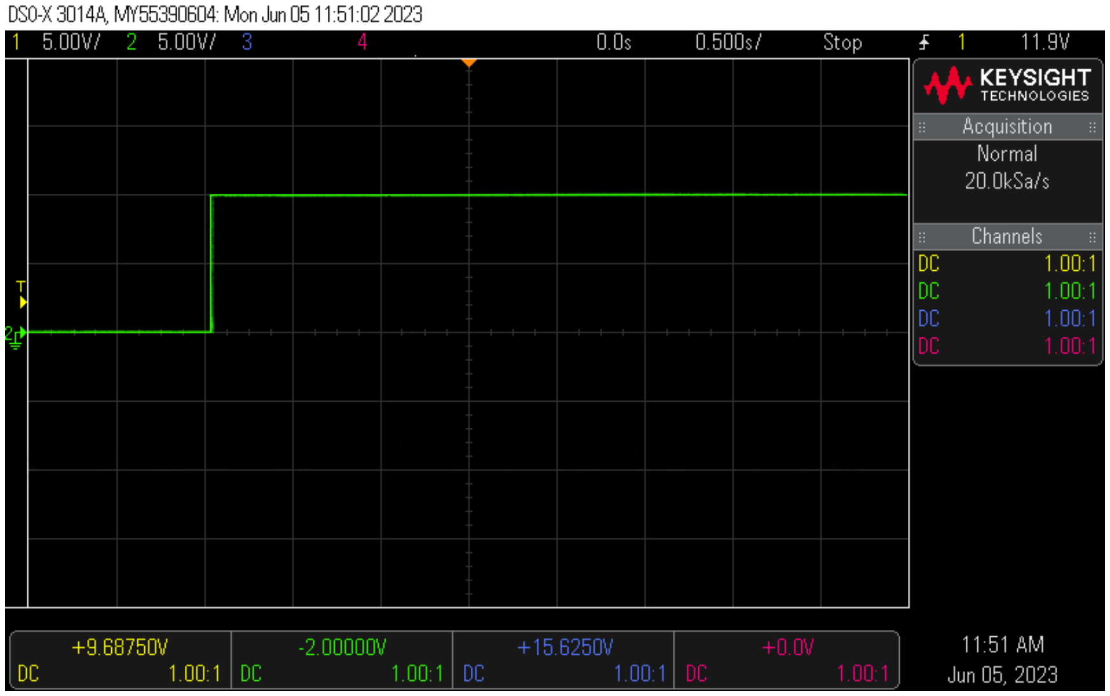
[picture p50: figure]

איור -42 מעגל אזהרה מפני גלישת מים.

ניתן לראות באיור 42 גרף אחד. ניתן להבחין בתצוגה ולראות כי כאשר נסגר המעגל, כלומר כאשר תא אחסון המים מתמלא במים וגורם לכך שהמעגל ייסגר, המשתמש מקבל אזהרה מפני גלישת מים בתא האחסון באמצעות נורת לד.

לצורך בדיקת תקינות שעון המערכת של מעגל הצגת משך הזמן הנותר למילוי הכוס שנמצא בבלוק 11 באיור 32 במטריצה, ובסכמת החיבורים באיור ,25 חובר הסקופ למעגל. להלן תוצאות צג הסקופ:

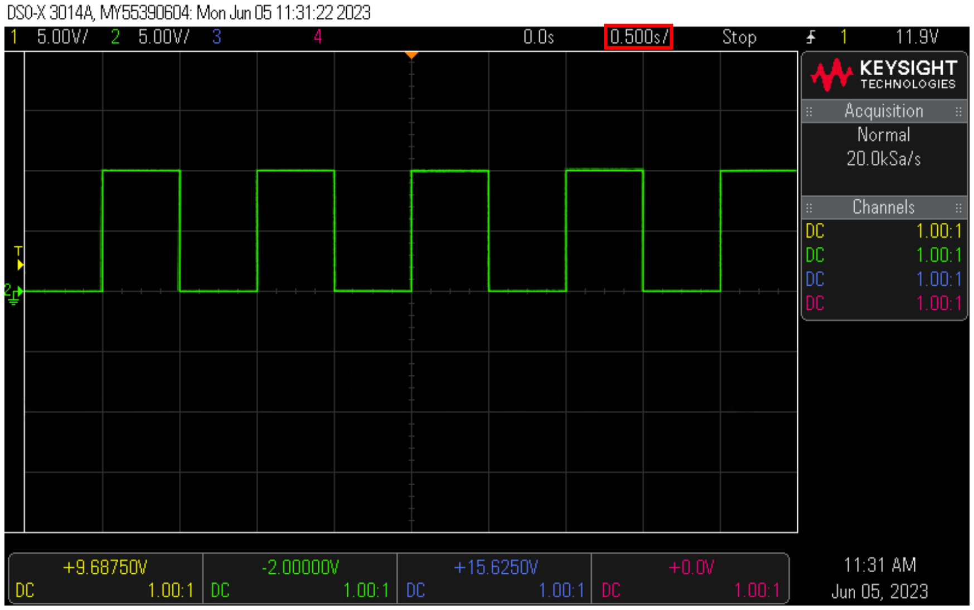
[picture p51: figure]

איור -43 מעגל הצגת משך הזמן הנותר למילוי הכוס.

ניתן לראות באיור 43 גרף אחד. ניתן להבחין בתצוגה ולראות את שעון המערכת. שעון זה משמש ליצירת המונה הבינארי הנועד לצורך הצגת משך הזמן הנותר למילוי הכוס באמצעות רכיבי segment .7
ניתן לראות שכל ריבוע בתצוגה מייצג [Sec[,0.5 בנוסף, את זמן המחזור של הגרף שווה בדיוק ל2- משבצות, לכן ניתן להבין מכך שזמן המחזור של שעון המערכת הינו [Sec[.1

לצורך בדיקת תקינות מעגל מייצב מתח שנמצא בבלוק 12 באיור 32 במטריצה, ובסכמת החיבורים באיור ,26 חובר הסקופ למעגל. להלן תוצאות צג הסקופ:

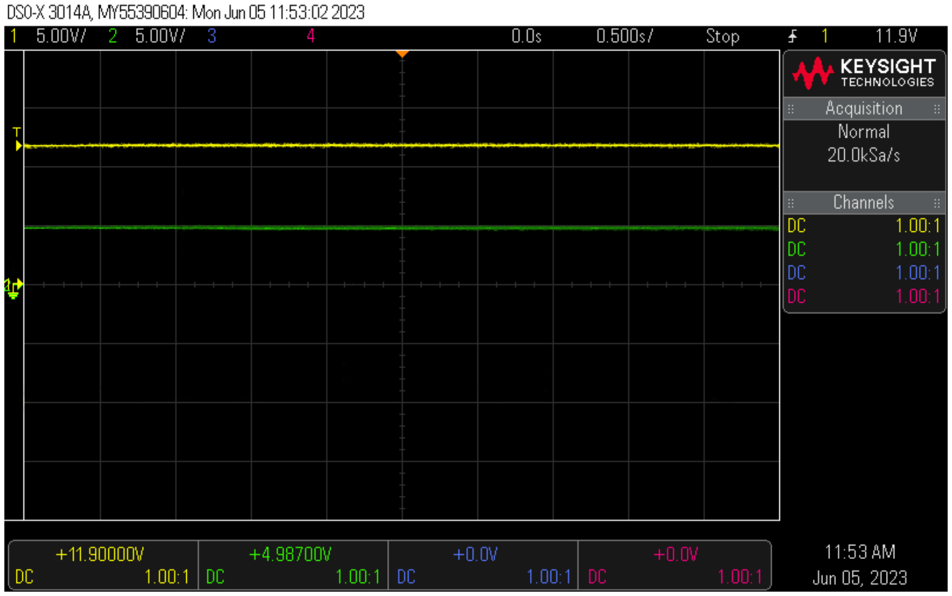
[picture p52: figure]

איור -44 מעגל מייצב מתח.

ניתן לראות באיור 44 שני גרפים. בגרף הצהוב ניתן לראות את רמת המתח לפני מייצב המתח. בגרף הירוק ניתן לראות את רמת המתח לאחר מייצב המתח. ניתן להבחין שהמעגל עושה את תפקידו כנדרש וכצפוי ומוריד את רמת המתח מ- [V[12 לפני מייצב המתח ל- [V[5 אחרי מייצב המתח.

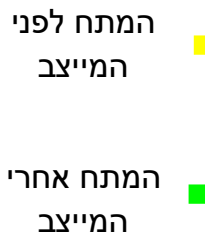
[picture p53: figure]
המתח לפני המייצב; המתח אחרי המייצב

.6 תוצאות ומסקנות הפרויקט.
.6.1 תוצאות הפעלת המערכת.
- במעגלי טווח הטמפרטורה התקבל כצפוי כי עבור טווח טמפרטורה רצוי במים חמים קיים

היסטרזיס בין °C90 − °C50 להפעלת מכשיר חימום בכדי להגיע לרתיחה, וכן עבור טווח טמפרטורה רצוי במים קרים קיים היסטרזיס בין °C10 − °C5 להפעלת מכשיר קירור

בכדי להוריד טמפרטורה למצב הרצוי.
- במעגל הרתחת מים חמים התקבלה עבור אינדיקציית הרתחה מהמשתמש הפעלת נורת

לד מהבהבת כנדרש והפעלת מכשיר חימום בכדי להגיע לרתיחה ב- °C97 כצפוי.

- במעגלי מזיגת מים חמים או קרים בהתאמה מתקבלת כצפוי הפעלה של המשאבה האחראית על מזיגת המים והפעלת הלד המתאים עבור אינדיקציה מתאימה מהמשתמש

לטווח הטמפרטורה הרצוי במים החמים ( °C90 − °C50) או הקרים (°C10 − °C5).

כשמתקבלת בהתאמה אינדיקציה מהמשתמש למזיגת מים חמים או קרים כאשר המים לא בטווח הטמפרטורה הרצוי שלהם לא מופעלת המשאבה.
- במעגל הפסקת מזיגת מים חמים, קרים או פושרים מתקבלת כצפוי עצירה מוחלטת של פעולת המזיגה עבור קבלת אינדיקציה כלשהיא מהמשתמש באמצעות אחד הכפתורים במעגל בזמן מזיגת המים.
- במעגל הגדרת גודל הכוס התקבלו זמני המזיגה הנדרשים ([S S]15 ,[S S]8 ,[S S]4)

כפי שהיה ניתן לצפות בעבור קבלת האינדיקציה המתאימה מהמשתמש.
- במעגל מזיגת מים פושרים מתקבלת כצפוי הפעלה של המשאבות האחראיות על מזיגת

המים החמים ( [S S]2) והקרים ([S S]6) במקביל והפעלת הלד המתאים עבור אינדיקציה מהמשתמש המתאימה לטווח הטמפרטורה הרצוי במים הפושרים ( − °C25 °C35). כשמתקבל ת אינדיקציה מהמשתמש למזיגת מים פושרים כאשר המים לא בטווח

הטמפרטורה הרצוי לא מופעלות המשאבות.
- במעגל הצגת טמפרטורת מים חמים בזמן אמת התקבל (באמצעות הסקופ ובאמצעות

רצף נורות הלד על המטריצה) שכאשר טמפרטורת המים החמים הם °C50 נדלקת נורת הלד הראשונה וכאשר טמפרטורת המים החמים הם °C90 נדלקת נורת הלד האחרונה. ישנן 5 נורות לד, כל נורה מסמלת את המעלות שבין °C90 − °C50 בטווח של °C.10

- במעגל אזהרה מפני גלישת מים התקבל כנדרש הפעלת נורת הלד והצפצפה כאשר נסגר מעגל ותא אחסון המים התמלא לחלוטין.
- במעגל הצגת משך הזמן הנותר למילוי הכוס התקבלה באמצעות רכיבי ה- segment 7

הצגת משך הזמן המתאים ([S S]15 או [S S]8 או [S S]4) שנותר למילוי הכוס

באמצעות שעון המערכת וחיבורי הרכיבים המתאימים במטריצה כצפוי. בנוסף, המעגל הופעל רק באמצעות רמת המתח שהתקבלה לאחר מייצב המתח- [V[.5

.6.1.1 שגיאות במערכת.

טווח טמפרטורה מים חמים וקרים- ישנה אפשרות שגיאה של עד כ- .±2° טווח טמפרטורה מים פושרים- ישנה אפשרות שגיאה של עד כ- .±1° טווח זמני המזיגה והספירה לאחור- ישנה אפשרות שגיאה של עד כ- [S S].±0.5

- כל השגיאות במערכת נובעות מחוסר אידיאליות של רכיבי המעבדה וציוד הבדיקה.

.6.1.2 אתגרים במהלך הפרויקט . במהלך הפרויקט נתקלנו בקשיים ואתגרים רבים במעגלים שונים שדרשו חשיבה מאומצת. על ידי ביצוע ניסויים ובדיקות רבות בוצעו שינויים ותוספות מתאימות למעגלים השונים בכדי להגיע לפתרונות מתאימים ויעילים. מוצגים להלן האתגרים הרבים בהן נתקלנו ודרכי החשיבה והפתרון שלהן:

- בקרת טווח טמפרטורת מים חמים- בתחילה נקבע מתח סף של °C90 למים החמים ובכל

פעם כשירדה אפילו מעלה אחת הופעלה מחדש פעולה ההרתחה.
- בעיה זאת נפתרה בעזרת מגבר משוב חיובי הנותן עקומת חשל בטווח הטמפרטורה הרצוי.
- בקרת טווח טמפרטורת מים קרים- בתחילה נבדק המעגל כאשר קוטביות נורת הלד שלו בממתח קדמי (כמו במים החמים) והמעגל אינו הגיב כצפוי.
- רק לאחר בדיקה והסקת המסקנה שנורת הלד צריכה להיות בממתח אחורי המעגל הגיב ותפקד כצפוי.
- בקרת טווח טמפרטורת מים פושרים- לא נמצאה הדרך להגיע למצב כלשהו שיתקבלו מים פושרים בטווח הנדרש באמצעות ערבוב ביחס מסוים של מים חמים וקרים.
- לאחר בדיקות וניסיונות רבות נמצאה הדרך לקבלת מים פושרים בטווח הרצוי. מים

פושרים יתקבלו רק כאשר טמפרטורת המים החמים תהיה מעל ל- °C90 באמצעות יחס מזיגה של מים חמים- [ S]2 ושל מים קרים- [S S].6

- הרתחת מים חמים- כשנבנה המעגל בחיבור בטור למעגל בקרת טווח טמפרטורת מים חמים קרה משהו מוזר לרמת המתח במעגל, מסיבה לא ברורה המתח לאחר חיבור המעגל בטור ירד למתח אפסי שגרם לכך שהמעגל לא יפעל ולא תתבצע הרתחה, למרות זאת שכאשר המעגל היה מנותק מהטור המתח בנקודת חיבור המעגל נבדק באמצעות הרב מודד שהראה שהיה גבוה בהרבה וברור שמספיק להפעלת המעגל.
- בעיה זו נפתרה באמצעות טרנזיסטור כאשר חובר המתח בנקודה לרגל B של הטרנזיסטור, הטרנזיסטור שלט בהעברת המתח למעגל באמצעות קבלת מתח ברגל B.

- הגדרת גודל הכוס- כשהורכבו רכיבי החד יציב במעגל התקבלו מעגלים מרצדים כשכל נגיעה קטנה במטריצה גרמה להפעלה של פולס חדש כלשהו מרכיבי החד יציב.
- לאחר חקירה עמוקה נמצאה הסיבה והפתרון לתופעה. בתחילה הורכבו במעגלים כפתורים שאין להם חיבור לאדמה לכן כל תנועה קטנה גרמה לפולס (אות 'הלם') קטן אשר הפעיל את החד יציב. לאחר שהורכב בכל כפתור נגד עומס קטן שחובר לאדמה המעגלים עבדו כנדרש. לבסוף נמצאו כפתורים בעלי רגל נוספת אשר לה חיבור לאדמה, מה שגרם לכך שכבר אין צורך בנגד העומס הקטן.
- עצירת מזיגת מים- כשהורכב המעגל התגלתה בעיה בעצירת המערכת.
- בעיה זו נפתרה באמצעות השהייה קטנה של נגד וקבל לאחר כל כפתור, השהייה יצרה פעולה תקינה של ברכיבי החד יציב.
- הצגת משך הזמן הנותר למילוי הכוס- המעגל נבנה באמצעות כמה סוגי רכיבים כשחלק מהם הוא רכיבי ה- Decoder D47LS,74 לאחר שנבדק ה- Datasheet שלו נמצא כי

רכיב יכול לעבוד במקסימום מתח של [ VVV]5 מה שלא תואם את המערכת שלנו שהופעלה במתח של [ VVV].12

- לאחר חקירה על אמצעים להורדת מתח נמצאה ומומשה אפשרות של שימוש ברכיב

7805LM שתפקידו הוא מייצב מתח ל- [ VVV].5

- הצגת טמפרטורת מים חמים בזמן אמת- כשנבנה המעגל הובן שהמעגל צורך מעל [V[12 בשל צריכה רבה של נגדים ונורות לד, נבדקה האפשרות להגברת המתח באמצעות מגבר אך אפשרות זו לא צלחה והמתח לא הוגבר כראוי.
- לאחר חשיבה מרובה עלה הרעיון לפצל את המגבר ל- 5 מגברים ולשים מגבר לפ ני כל נורת לד עם הגברת מתח יותר קטנה מהתכנון וככה להתגבר על מכשול המגבר.

.6.2 מסקנות הפרויקט.
- התכנון הראשוני הינו גורם מאוד משמעותי באיכות מימוש המעגל, לכן נדרש לבצע תכנון ראשוני מעמיק הכולל הבנת דרישות, סכמת בלוקים וביצוע סימולציות. דבר זה יעלה משמעותית את איכות מימוש המערכת בפועל.
- בעת בחירת רכיב, חשוב לעבור על דפי הנתונים שלו ולבדוק את אופן פעולתו ומתח ההספקה אליו הוא נדרש, דבר ימנע שריפת רכיבים ופגיעה כללית במערכת.
- חשוב לבצע מדידות לאחר כל מימוש של מעגל ולבצע השוואה לסימולציות שבוצעו קודם לכן, דבר זה מאמת כי אכן המעגל נבנה ומומש כנדרש, והוא מקיים את הדרישות.
- כאשר יש קשר בין מעגלים שונים, מומלץ להשתמש בטרנזיסטור כמתג בין המעגלים (ניתן לראות איור 17 לדוגמא), דבר זה יכול לעזור למנוע פגיעה במעגלים.
- בעת מימוש חלקי המעגל על המטריצה, מומלץ לתכנן את אופן בניית המעגל וזאת כדי שיהיה מספיק מקום לבניית כל המערכת על מטריצת החיבורים.
- ניתן לצמצם רכיבים במעגל ע"י שימוש ברכיב אחד בעל מימוש כפול.
- בעת מדידות בפועל מתקלים שגיאות גדולות יותר ביחס לסימולציות התאורטיות, כדי למנוע זאת חשוב לוודא כי ערכם של הרכיבים קרוב ככל שניתן לערכם של הרכיבים התאורטיים.
- כאשר יש הגבלת מתח ברכיב, אשר קטנה ממתח האספקה של המעגל, ניתן להשתמש במעגל מייצב מתח (ניתן לראות באיור 26).
- שימוש בבקר מתוכנת (ארדואינו) יעיל בהרבה מבניית מעגל על מטריצה, ניתן לראות כי המימוש של הארדואינו הינו מימוש קל יותר, גמיש יותר, מהיר יותר, נוח יותר ופשוט יותר. כמו כן ניתן לשנות בקלות בכל רגע את דרישות המערכת על ידי שינוי הקוד בקלות. שינוי בדרישות המערכת על המטריצה הינו שינוי מאוד מסורבל וארוך.
- בעת ביצוע סימולציה למערכת טרם הדפסת ה PCB, חשוב מאוד לרשום את שמו של כל רכיב וזאת כדי לאפשר לנו למקם בקלות את הרכיבים לאחר קבלת המעגל המודפס.
- בעת עבודה במעבדה, חשוב מאוד להקפיד על עבודה תקניה עם הציוד, לשמור על סביבה יבשה ונקייה. דברים אלו מונעים בעיות לא נעימות.

.6.3 סיכום.
בפרויקט הנדסי זה תוכננה ויושמה מערכת בר מים חכמה אשר מספקת ומנגישה מים חמים, קרים ופושרים לשתייה.
בתחילה נלמדו ונותחו. דרישות אלו כללו: שליטה בטווח הטמפרטורו ת של מים קרים וחמים, יצירת מים פושרים בטווח מסוים על ידי ערבוב מים חמים קרים ביחס מסוים, הרתחת מים חמים, מזיגת כוסות מים חמים וקרים

בכמויות שונות ([S S]15 ,[S S]8 ,[S S]4), מתן אפשרות לעצירת מזיגת המים באמצעות

לחיצה על אחד מכפתורי המערכת, הצגת טמפרטורת המים החמים והקרים ואת משך הזמן שנותר למזיגת הכוס בזמן אמת והתראת אזהרה למשתמש כאשר תא אחסון המים העודפים מלא.
מתוך דרישות אלו תוכננה סכמת בלוקים אשר באמצעותה תוכננה ויושמה המערכת כולה ברמת החיבורים והרכיבים.
תכנון החומרה בוצע לאחר מכן באמצעות תוכנת הדמיית הסימולציה Multisim אשר שימשה לבדיקה והדמיה של המעגלים במערכת בכדי לוודא שהם תקינים ואיכותיים. לאחר השלמת תכנון החומרה, התכנון יושם על גבי מטריצת חיבור ים. מטריצת החיבורים הראתה כיצד הרכיבים יהיו מחוברים זה לזה פיזית. לאחר מכן בוצעו בדיקות תקינות המעגלים במטריצת החיבורים באמצעות סקופ . הסקופ שימש לבדיקת המעגלים כדי לוודא שהם פועלים כהלכה. לאחר השלמת בדיקות תקינות המעגל במטריצה, תוכנן מעגל PCB עבור המערכת. מעגל PCB הוא לוח מעגלים מודפסים אשר משמש להפוך את המעגלים לקלים יותר לייצור. לאחר המימוש תוכנן מעגל PCB המוכן להדפסה עבור מערכת זו. בנוסף, המערכת כולה תוכננה ומומשה באמצעות מיקרו-בקר (ארדואינו), מיקרו- בקר זה הוא מחשב קטן שניתן לתכנת ו לשלוט במכשירים אלקטרוניים. שימוש במיקרו-בקר מאפשר את יישום מערכת בר המים בקלות ומאפשר שדרוגים והתאמות אישיות עתידיות. במהלך כל העבודה בפרויקט נעשה תיעוד של המדידות שנעשו. תיעוד זה שימש לביצוע תיקונים במעגלים בכדי לייעל את המערכת.

.7 רשימות.
.7.1 רשימת טבלאות.
טבלה -1 ערכי התנגדות חיישן טמפרטורה 13 |
טבלה -2 ערכי התנגדות חיישן הטמפרטורה למים פושרים 13 |
טבלה -3 מתח כתלות בטמפרטורה עבור הצגת טמפ' 25 |
טבלה -4 ערכי כניסות המונה הבינארי 28 |

.7.2 רשימת איורים.
איור -1 מכונת השאדוף 3 |
איור -2 תצוגת בר המים אריאל .8 4 |
איור -3 סכמת בלוקים עבור בקרת טמפרטורה 8 |
איור -4 סכמת בלוקים עבור הרתחת מים חמים 9 |
איור -5 סכמת בלוקים עבור מזיגת מים חמים 9 |
איור -6 סכמת בלוקים עבור מזיגת מים קרים. 9 |
איור -7 סכמת בלוקים עבור בקרת גודל הכוס (זמן מזיגה)10 |
איור -8 סכמת בלוקים עבור מזיגת מים קרים 10 |
איור -9 סכמת בלוקים עבור ספירה לאחור בעת מזיגה10 |
איור -10 סכמת בלוקים עבור הצגת מערך טווח טמפרטורת11 |
איור -11 סכמת בלוקים עבור בקרת לחצנים. 11 |
איור -12 סכמת בלוקים עבור בקרת גלישת מים 11 |
איור -13 גרף של חיישן הטמפרטורה (NTC (ביחס להתנגדות 12 |
איור -14 תרשים זרימה כללי של המערכת 14 |
איור -15 מעגל שמירת טווח טמפ' של המים החמים 16 |
איור -16 מעגל שמירת טווח טמפ' של המים הקרים 17 |
איור -17 מעגל הרתחת מים, נורת הלד מהבהבת בעת ההרתחה 18 |
איור -18 מעגל מזיגת מים חמים19 |
איור -19 מעגל מזיגת מים קרים 20 |
איור -20 בלוק עצירת מערכת בעת מזיגה ולחיצה 21 |
איור -21 מעגלי בקרת גדלי כוס 22 |
איור -22 מעגל בקרת מים פושרים. 23 |
איור -23 מעגל הצגת טמפרטורת חמים בזמן אמת. 24 |
איור -24 מעגל אזהרה מפני גלישת מים. 26 |
איור -25 מעגל הצגת משך זמן נותר למילוי כוס. 27 |

איור -26 מעגל המייצב מתח29 |
איור -41 מעגל הצגת טמפרטורת מים חמים בזמן אמת42 |

.8 נספחים .
.8.1 דפי נתונים.
מגברי שרת 358LM-
https://www.sparkfun.com/datasheets/Components/General/LM358.pdf חיישן טמפרטורה NTC-
https://www.tme.eu/Document/7f93a3d121ea8402378cf8bc6239e8d2/B57164 K104J-EPCOS-datasheet-10192.pdf נורות לד-
http://www1.futureelectronics.com/doc/EVERLIGHT%C2%A0/334-15__T1C1-4WYA.pdf
טרנזיסטור 2222N-2
https://www.farnell.com/datasheets/296640.pdf -NE555P זמנן
https://www.ti.com/lit/ds/symlink/ne555.pdf שערי NOT-
https://www.ti.com/lit/ds/symlink/cd4049ub.pdf?ts=1686026190157&ref_url=ht tps%253A%252F%252Fwww.google.com%252F שערי AND-
https://www.ti.com/lit/ds/symlink/cd4081b.pdf?ts=1686048579648&ref_url=htt ps%253A%252F%252Fwww.google.com%252F שערי OR-
https://www.ti.com/lit/ds/symlink/cd4071b.pdf חד יציב 14538MC-
https://www.onsemi.com/pdf/datasheet/mc14538b-d.pdf טרנזיסטור 06031MPSA-
https://www.onsemi.com/pdf/datasheet/mpsa05-d.pdf -Active Buzzer
http://www.electronicoscaldas.com/datasheet/LTE12-Series.pdf -7 segment
https://www.farnell.com/datasheets/2095789.pdf -74LS47D Decoder
http://www.sycelectronica.com.ar/semiconductores/74LS47.pdf -74LS190D BCD
https://www.ti.com/lit/ds/symlink/sn74ls191.pdf?ts=1686064523218&ref_url=h ttps%253A%252F%252Fwww.google.com%252F

.8.2 קוד התוכנה של הבקר המתוכנת (ארדואינו).

#include <math.h>

#include <Wire.h>

#include <LiquidCrystal_I2C.h> // | למסך | ספרייה

#define sensor1 A0 // ntc | חמים

#define sensor2 A1 // ntc | קרים

#define lukewarm_led 9 // | פושרים | לד

#define warning_led 10 // | אזהרה | לד

LiquidCrystal_I2C lcd(0x27, 16, 2);

const int ntc_hot = A0; // | חמים | טמפרטורה | חיישן
const int ntc_cold = A1; // | קרים | טמפרטורה | חיישן
const int boil_led = 2; // | הרתחה | לד | הבהוב
int boil_button = 0; // | הרתחה
int hot_button = 0; // | חמים | מזיגה
int cold_button = 0; // | קרים | מזיגה
int lukewarm_button = 0; // | פושרים | מזיגה
int sec_4_button = 0; // 4 | מזיגה | שניות
int sec_8_button = 0; // 8 | מזיגה | שניות
int sec_15_button = 0; // 15 | מזיגה | שניות
משתנה לזמן מזיגת כוס // ;0=time_pouring int
חיישן לחות // ;0 = overflow int
משתנה לטמפרטורת מים פושרים // ;0 = temperature_lukewarm double

byte degree[] = {B00110,B01001,B01001,B00110,B00000,B00000,B00000,B00000}; קוד לסימן מעלות //

תוכנית ראשית שרצה בהתחלה // ()setup void
{
הפעלת מסך // ;()init.lcd
הפעלת תאורה אחורית // ;()backlight.lcd
הדפסה בשורה ועמודה ספציפית // ;(16,2)begin.lcd הגדרת 1 לסימן מעלות // ;(degree 1,(createChar.lcd הדפסה בשורה ועמודה ספציפית // ;(3,0)setCursor.lcd lcd.print("Welcome to"); // הדפסה
הדפסה בשורה ועמודה ספציפית // ;(5,1)setCursor.lcd lcd.print("Ariel 8");
השהייה של 2 וחצי שניות // ;(2500)delay
נקה מסך // ;()clear.lcd
הגדר קצב העברת נתונים עבור תקשורת טורית // ;(9600)begin.Serial לד הבהוב בעת הרתחה // ;(OUTPUT ,led_boil(pinMode
}

תוכנית שרצה בצורת לולאה // ()loop void
{
/*------------------------ בלוק חישוב טמפרטורת מים חמים וקרים---------------------*/ /*--------------חישוב טמפרוטרת חמים-----------------*/
int ntc_hot_adc;
double output_voltage_1, ntc_hot_resistance, ntc_hot_resistance_ln, hot_temperature;
ntc_hot_adc = analogRead(ntc_hot);
output_voltage_1 = ( (ntc_hot_adc * 5.0) / 1023.0 ); ntc_hot_resistance = ( ( 5 * ( 10.0 / output_voltage_1 ) ) - 10 ); /* Resistance in kilo ohms */
ntc_hot_resistance = ntc_hot_resistance * 1000;
ntc_hot_resistance_ln = log(ntc_hot_resistance); // | באוהם | התנגדות
hot_temperature = ( 1 / ( 0.001129148 + ( 0.000234125 * ntc_hot_resistance_ln ) + ( 0.0000000876741 * ntc_hot_resistance_ln *
ntc_hot_resistance_ln * ntc_hot_resistance_ln ) ) ) - 273.15; // | במעלות | טמפרטורה
/*--------------חישוב טמפרוטרת קרים-----------------*/
int ntc_cold_adc;
double output_voltage_2, ntc_cold_resistance, ntc_cold_resistance_ln, cold_temperature;
ntc_cold_adc = analogRead(ntc_cold);
output_voltage_2 = ( (ntc_cold_adc * 5.0) / 1023.0 ); ntc_cold_resistance = ( ( 5 * ( 10.0 / output_voltage_2 ) ) - 10 ); /* Resistance in kilo ohms */
ntc_cold_resistance = ntc_cold_resistance * 1000; ntc_cold_resistance_ln = log(ntc_cold_resistance);
cold_temperature = ( 1 / ( 0.001129148 + ( 0.000234125 * ntc_cold_resistance_ln ) + ( 0.0000000876741 * ntc_cold_resistance_ln * ntc_cold_resistance_ln * ntc_cold_resistance_ln ) ) ) - 273.15; /* /*--------------הדפסת טמפרוטרת חמים וקרים -----------------*/
ניקוי מסך // ;()clear.lcd
הדפסה בשורה ועמודה ספציפית // ;(1,0)setCursor.lcd
lcd.print("Hot");
הדפסה בשורה ועמודה ספציפית // ;(11,0)setCursor.lcd lcd.print("Cold");
הדפסה בשורה ועמודה ספציפית // ;(0,1)setCursor.lcd lcd.print(hot_temperature);
הדפסת סימן מעלות // ;(1)write.lcd lcd.print("C");
הדפסה בשורה ועמודה ספציפית // ;(9,1)setCursor.lcd lcd.print(cold_temperature);
הדפסת סימן מעלות // ;(1)write.lcd
lcd.print("C");
השהייה של שנייה // ;(1000)delay
/*----------------------------סוף בלוק חישוב טמפרטורה -------------------------*/ /*------------------------------ בלוק זמני מזיגת מים חמים וקרים--------------------*/

/*-----------------בחירת זמן מזיגה-------------------*/
boil_button = digitalRead(4); // | הרתחה
hot_button = digitalRead(5); // | חמים | מזיגה
cold_button = digitalRead(6); // | קרים | מזיגה
lukewarm_button = digitalRead(7); // | פושרים | מזיגה
sec_4_button = digitalRead(8); // 4 | מזיגה | שניות
sec_8_button = digitalRead(11); // 8 | מזיגה | שניות
sec_15_button = digitalRead(12); // 15 | מזיגה | שניות
if((hot_button == HIGH && pouring_time == 0) || (cold_button == HIGH && אם נלחץ כפתור מזיגת חמים/ קרים ולא נבחר זמן מזיגה // ((0 == time_pouring
{
ניקוי מסך// ;()clear.lcd
מבקש לבחור זמן מזיגה // ;("Select Please("print.lcd
הדפסה בשורה ועמודה ספציפית // ;(0,1)setCursor.lcd
lcd.print("a pouring time");
while(sec_4_button == LOW && sec_8_button == LOW && sec_15_button == LOW) לולאה לבדיקת לחיצה //
{
בודק אם נבחר 4 שניות // ;(8)digitalRead = button_4_sec
בודק אם נבחר 8 שניות // ;(11)digitalRead = button_8_sec בודק אם נבחר 15 שניות // ;(12)digitalRead = button_15_sec
if(sec_4_button==HIGH) // | שניות | 4 | נבחר | אם
{
משתנה זמן מזיגה // ;4 = time_pouring
נקה מסך // ;()clear.lcd
lcd.print("Pouring time:"); // | נבחר | זמן | מדפיס
הדפסה בשורה ועמודה ספציפית // ;(3,1)setCursor.lcd lcd.print("4 Seconds");
השהייה של 2 שניות // ;(2000)delay
ניקוי מסך // ;()clear.lcd
}
else if(sec_8_button==HIGH) // | שניות | 8 | נבחר | אם
{
משתנה זמן מזיגה // ;8 = time_pouring
ניקוי מסך // ;()clear.lcd
lcd.print("Pouring time:"); // | נבחר | זמן | מדפיס
הדפסה בשורה ועמודה ספציפית // ;(3,1)setCursor.lcd lcd.print("8 Seconds");
השהייה של 2 שניות // ;(2000)delay
ניקוי מסך // ;()clear.lcd
}
else if(sec_15_button==HIGH) // | שניות | 15 | נבחר | אם
{
משתנה זמן מזיגה // ;15 = time_pouring
ניקוי מסך // ;()clear.lcd
lcd.print("Pouring time:"); // | נבחר | זמן | מדפיס
הדפסה בשורה ועמודה ספציפית // ;(3,1)setCursor.lcd lcd.print("15 Seconds");

השהייה של 2 שניות // ;(2000)delay ניקוי מסך // ;()clear.lcd
}
}
}
/*----------שינוי בחירת זמן מזיגה תוך כדי ריצה ------------*/
if(sec_4_button==HIGH) // | שניות | 4 | נבחר | אם
{
משתנה זמן מזיגה // ;4 = time_pouring
נקה מסך // ;()clear.lcd
lcd.print("Pouring time:"); // | נבחר | זמן | מדפיס
הדפסה בשורה ועמודה ספציפית // ;(3,1)setCursor.lcd lcd.print("4 Seconds");
השהייה של 2 שניות // ;(2000)delay
נקה מסך // ;()clear.lcd
}
else if(sec_8_button==HIGH) // | שניות | 8 | נבחר | אם
{
משתנה זמן מזיגה // ;8 = time_pouring
נקה מסך // ;()clear.lcd
lcd.print("Pouring time:"); // | נבחר | זמן | מדפיס
הדפסה בשורה ועמודה ספציפית // ;(3,1)setCursor.lcd lcd.print("8 Seconds");
השהייה של 2 שניות // ;(2000)delay
נקה מסך // ;()clear.lcd
}
else if(sec_15_button==HIGH) // | שניות | 15 | נבחר | אם
{
משתנה זמן מזיגה // ;15 = time_pouring
נקה מסך // ;()clear.lcd
lcd.print("Pouring time:"); // | נבחר | זמן | מדפיס
הדפסה בשורה ועמודה ספציפית // ;(3,1)setCursor.lcd lcd.print("15 Seconds");
השהייה של 2 שניות // ;(2000)delay
נקה מסך // ;()clear.lcd
}
/*-----------------------------סוף בלוק זמני מזיגת מים חמים וקרים----------------*/ /*-----------------------------------בלוק מזיגת מים חמים ---------------------*/ ערך לחצן חמים // ;(5)digitalRead = button_hot
תנאי אם נלחץ מזיגת חמים וטמפ' // ( 90.00 < temperature_hot && HIGH == button_hot( if מעל 90 מעלות
{
מדליק לד מזיגת חמים // ;(HIGH 2,(digitalWrite
for(int i=0; i < pouring_time ; i++) // | נותר | מזיגה | זמן | להדפסת | לולאה
{
נקה מסך // ;()clear.lcd
lcd.print("Time left for"); // | מזיגה | זמן | מדפיס
הדפסה בשורה ועמודה ספציפית // ;(0,1)setCursor.lcd

lcd.print("pouring : ");
lcd.print(pouring_time - i);
השהייה של שנייה // ;(1000)delay
boil_button = digitalRead(4); // | הרתחה
hot_button = digitalRead(5); // | חמים | מזיגה
cold_button = digitalRead(6); // | קרים | מזיגה
lukewarm_button = digitalRead(7); // | פושרים | מזיגה
sec_4_button = digitalRead(8); // 4 | מזיגה | שניות
sec_8_button = digitalRead(11); // 8 | מזיגה | שניות
sec_15_button = digitalRead(12); // 15 | מזיגה | שניות
/*---תנאי לבדיקה אם נלחץ כפתור בעת מזיגה אז מפסיק מזיגה--*/
if(boil_button == HIGH || hot_button == HIGH || cold_button == HIGH || lukewarm_button == HIGH || sec_4_button == HIGH|| sec_8_button == HIGH || sec_15_button == HIGH)
מפסיק מזיגה // ;break
}
מכבה לד מזיגת חמים // ;(LOW 2,(digitalWrite
השהייה של חצי שנייה // ;(500)delay
}
/*-----------------------------סוף בלוק מזיגת מים חמים ------------------------*/ /*--------------------------בלוק מזיגת מים קרים ----------------------------*/ ערך לחצן קרים // ;(6)digitalRead = button_cold
תנאי אם נלחץ מזיגת קרים // (HIGH == button_cold( if
{
מדליק לד מזיגת קרים // ;(HIGH 3,(digitalWrite
for(int i=0; i < pouring_time ; i++) // | נותר | מזיגה | זמן | להדפסת | לולאה
{
נקה מסך // ;()clear.lcd
lcd.print("Time left for"); // | מזיגה | זמן | מדפיס
הדפסה בשורה ועמודה ספציפית // ;(0,1)setCursor.lcd lcd.print("pouring : ");
lcd.print(pouring_time - i);
השהייה של שנייה // ;(1000)delay
boil_button = digitalRead(4); // | הרתחה
hot_button = digitalRead(5); // | חמים | מזיגה
cold_button = digitalRead(6); // | קרים | מזיגה
lukewarm_button = digitalRead(7); // | פושרים | מזיגה
sec_4_button = digitalRead(8); // 4 | מזיגה | שניות
sec_8_button = digitalRead(11); // 8 | מזיגה | שניות
sec_15_button = digitalRead(12); // 15 | מזיגה | שניות
/*---תנאי לבדיקה אם נלחץ כפתור בעת מזיגה אז מפסיק מזיגה--*/
if(boil_button == HIGH || hot_button == HIGH || cold_button == HIGH || lukewarm_button == HIGH || sec_4_button == HIGH|| sec_8_button == HIGH || sec_15_button == HIGH)
מפסיק מזיגה // ;break
}
מכבה לד מזיגת קרים // ;(LOW 3,(digitalWrite השהייה של חצי שנייה // ;(500)delay

}
/*-------------------------------------סוף בלוק מזיגת מים קרים -----------------*/ /*---------------------- -------בלוק מזיגת מים פושרים (8 שניות) ------------------*/ lukewarm_temperature = ((hot_temperature*2 + cold_temperature*6) / 8 ); // חישוב טמפרטורת פושרים ע"י נוסחאה לפי 2,6 שניות של זמני מזיגה בהכפלת הטמפרטורה בהתאמה
ערך לחצן פושרים // ;(7)digitalRead = button_lukewarm
// delay(100);
תנאי אם נלחץ מזיגת קרים // ( HIGH == button_lukewarm (if
{
if (lukewarm_temperature > 25 && lukewarm_temperature < 35 ) // | מים | למזיגת | תנאי
פושרים
{
לולאה להדפסת זמן מזיגה נותר // (++i ; 8 < i; 0 = i int(for
{
digitalWrite(lukewarm_led, HIGH); // | פושרים | לד | מדליק
תנאי שבודק האם עבר 2 שניות ואז לוקח מהמים הקרים // (2 > i(if מדליק לד חמים למשך 2 שניות // ;(HIGH 2,(digitalWrite else
{
מכבה לד חמים לאחר 2 שניות // ;(LOW 2,(digitalWrite מדליק לד קרים למשך 6 שניות // ;(HIGH 3,(digitalWrite }
נקה מסך // ;()clear.lcd
lcd.print("Time left for");
הדפסה בשורה ועמודה ספציפית // ;(0,1)setCursor.lcd lcd.print("pouring : ");
lcd.print(7-i+1);
השהייה של שנייה // ;(1000)delay
boil_button = digitalRead(4); // | הרתחה
hot_button = digitalRead(5); // | חמים | מזיגה
cold_button = digitalRead(6); // | קרים | מזיגה
lukewarm_button = digitalRead(7); // | פושרים | מזיגה
sec_4_button = digitalRead(8); // 4 | מזיגה | שניות
sec_8_button = digitalRead(11); // 8 | מזיגה | שניות
sec_15_button = digitalRead(12); // 15 | מזיגה | שניות
/*---תנאי לבדיקה אם נלחץ כפתור בעת מזיגה אז מפסיק מזיגה--*/
if(boil_button == HIGH || hot_button == HIGH || cold_button == HIGH || lukewarm_button == HIGH || sec_4_button == HIGH|| sec_8_button == HIGH || sec_15_button == HIGH)
מפסיק מזיגה // ;break
}
מכבה לד קרים // ;(LOW 3,(digitalWrite
מכבה לד חמים // ;(LOW 2,(digitalWrite
digitalWrite(lukewarm_led, LOW); // | פושרים | לד | מכבה
השהייה של חצי שנייה // ;(500)delay
}

else
{
נקה מסך // ;()clear.lcd
lcd.print("lukewarm temperature");
הדפסה בשורה ועמודה ספציפית // ;(5,1)setCursor.lcd lcd.print(lukewarm_temperature);
השהייה של 2 שניות // ;(2000)delay
}
}
/*--------------------------סוף בלוק מזיגת מים פושרים ---------------------------*/ /*--------------------------בלוק לד אזהרה מפני גלישת מים ------------------------*/ בודק ערך מפלס חיישן לחות // ;(3A(analogRead = overflow
//Serial.println(overflow); // | הערך | הדפסת
תנאי לגלישת מים // (550 < overflow (if
digitalWrite(warning_led, HIGH); // | אזהרה | לד | מדליק
אם לא גולש מכבה לד אזהרה // else
digitalWrite(warning_led, LOW); // | אזהרה | לד | מכבה
/*------------------------------------- סוף בלוק לד אזהרה ------------*/ /************************************************************************** /*------------------------------ בלוק בקרת הרתחת מים ------------------------*/ /*-----------בקרת הרתחת מים--------------*/
ערך לחצן הרתחה // ;(4)digitalRead = button_boil
if (boil_button == HIGH || hot_temperature <= 50.00) // או | הרתחה | נלחץ | האם | בודק
שטמפ' חמים מתחת ל 50 מעלות
{
לולאת הרתחת מים חמים עד ל 97 מעלות // (97.00 => temperature_hot(while
{
/*--------------חישוב טמפרוטרת חמים-----------------*/
ntc_hot_adc = analogRead(ntc_hot);
output_voltage_1 = ( (ntc_hot_adc * 5.0) / 1023.0 ); ntc_hot_resistance = ( ( 5 * ( 10.0 / output_voltage_1 ) ) - 10 ); /* Resistance in kilo ohms */
ntc_hot_resistance = ntc_hot_resistance * 1000;
ntc_hot_resistance_ln = log(ntc_hot_resistance); /* Resistance in ohms */ hot_temperature = ( 1 / ( 0.001129148 + ( 0.000234125 * ntc_hot_resistance_ln ) + ( 0.0000000876741 * ntc_hot_resistance_ln * ntc_hot_resistance_ln * ntc_hot_resistance_ln ) ) ) - 273.15; /* Temperature in degree Celsius */
/*--------------חישוב טמפרוטרת קרים-----------------*/
ntc_cold_adc = analogRead(ntc_cold);
output_voltage_2 = ( (ntc_cold_adc * 5.0) / 1023.0 ); ntc_cold_resistance = ( ( 5 * ( 10.0 / output_voltage_2 ) ) - 10 ); ntc_cold_resistance = ntc_cold_resistance * 1000; ntc_cold_resistance_ln = log(ntc_cold_resistance);
cold_temperature = ( 1 / ( 0.001129148 + ( 0.000234125 * ntc_cold_resistance_ln ) + ( 0.0000000876741 * ntc_cold_resistance_ln * ntc_cold_resistance_ln * ntc_cold_resistance_ln ) ) ) - 273.15;

/*--------------הדפסת טמפרוטרת חמים וקרים -----------------*/ נקה מסך // ;()clear.lcd
הדפסה בשורה ועמודה ספציפית // ;(0,0)setCursor.lcd lcd.print("Heats-Up");
הדפסה בשורה ועמודה ספציפית // ;(11,0)setCursor.lcd lcd.print("Cold");
הדפסה בשורה ועמודה ספציפית // ;(0,1)setCursor.lcd lcd.print(hot_temperature);
הדפסת סימן מעלות // ;(1)write.lcd lcd.print("C");
הדפסה בשורה ועמודה ספציפית // ;(9,1)setCursor.lcd lcd.print(cold_temperature);
הדפסת סימן מעלות // ;(1)write.lcd
lcd.print("C");
/*----------הבהוב לד הרתחה---------------*/
digitalWrite(boil_led, HIGH); // | הרתחה | לד | מדליק
השהייה של חצי שנייה // ;(500)delay
digitalWrite(boil_led, LOW); // | הרתחה | לד | מכבה
השהייה של חצי שנייה // ;(500)delay
/*----------------מזיגת מים קרים --------------*/
ערך לחצן קרים // ;(6)digitalRead = button_cold
if( cold_button == HIGH && pouring_time != 0) // | קרים | מזיגת | נלחץ | אם | תנאי
{
מדליק לד קרים // ;(HIGH 3,(digitalWrite
לולאת הבהוב לד הרתחה ומזיגת מים קרים // (++i;time_pouring < i; 0=i int(for {
/*----------הבהוב לד הרתחה---------------*/
digitalWrite(boil_led, HIGH); // | הרתחה | לד | מדליק
השהייה של חצי שנייה // ;(500)delay
digitalWrite(boil_led, LOW); // | הרתחה | לד | מכבה
השהייה של חצי שנייה // ;(500)delay
נקה מסך // ;()clear.lcd
lcd.print("Time left for"); // | מזיגה | זמן | מדפיס
הדפסה בשורה ועמודה ספציפית // ;(0,1)setCursor.lcd lcd.print("pouring : ");
lcd.print(pouring_time - i);
השהייה של שנייה // ;(1000)delay
boil_button = digitalRead(4); // | הרתחה
hot_button = digitalRead(5); // | חמים | מזיגה
cold_button = digitalRead(6); // | קרים | מזיגה
lukewarm_button = digitalRead(7); // | פושרים | מזיגה
sec_4_button = digitalRead(8); // 4 | מזיגה | שניות
sec_8_button = digitalRead(11); // 8 | מזיגה | שניות
sec_15_button = digitalRead(12); // 15 | מזיגה | שניות

/*---תנאי לבדיקה אם נלחץ כפתור בעת מזיגה אז מפסיק מזיגה--*/
if(boil_button == HIGH || hot_button == HIGH || cold_button == HIGH || lukewarm_button == HIGH || sec_4_button == HIGH|| sec_8_button == HIGH || sec_15_button == HIGH)
מפסיק מזיגה // ;break
}
מכבה לד מזיגת קרים // ;(LOW 3,(digitalWrite
השהייה של חצי שנייה // ;(500)delay
}
/*---------------בחירת זמן מזיגה----------------*/
boil_button = digitalRead(4); // | הרתחה
hot_button = digitalRead(5); // | חמים | מזיגה
cold_button = digitalRead(6); // | קרים | מזיגה
lukewarm_button = digitalRead(7); // | פושרים | מזיגה
sec_4_button = digitalRead(8); // 4 | מזיגה | שניות
sec_8_button = digitalRead(11); // 8 | מזיגה | שניות
sec_15_button = digitalRead(12); // 15 | מזיגה | שניות
if((hot_button == HIGH && pouring_time == 0) || (cold_button == HIGH && אם נלחץ כפתור מזיגת חמים/ קרים ולא נבחר זמן מזיגה // ((0 == time_pouring
{
נקה מסך // ;()clear.lcd
מבקש לבחור זמן מזיגה // ;("Select Please("print.lcd
הדפסה בשורה ועמודה ספציפית // ;(0,1)setCursor.lcd
lcd.print("a pouring time");
while(sec_4_button == LOW && sec_8_button == LOW && sec_15_button == LOW) לולאה לבדיקת לחיצה //
{
בודק אם נבחר 4 שניות // ;(8)digitalRead = button_4_sec
בודק אם נבחר 8 שניות // ;(11)digitalRead = button_8_sec בודק אם נבחר 15 שניות // ;(12)digitalRead = button_15_sec
if(sec_4_button==HIGH) // | שניות | 4 | נבחר | אם
{
משתנה זמן מזיגה // ;4 = time_pouring
נקה מסך // ;()clear.lcd
lcd.print("Pouring time:"); // | נבחר | זמן | מדפיס
הדפסה בשורה ועמודה ספציפית // ;(3,1)setCursor.lcd lcd.print("4 Seconds");
השהייה של 2 שניות // ;(2000)delay
נקה מסך // ;()clear.lcd
}
else if(sec_8_button==HIGH) // | שניות | 8 | נבחר | אם
{
משתנה זמן מזיגה // ;8 = time_pouring
נקה מסך // ;()clear.lcd
lcd.print("Pouring time:"); // | נבחר | זמן | מדפיס
הדפסה בשורה ועמודה ספציפית // ;(3,1)setCursor.lcd lcd.print("8 Seconds");
השהייה של 2 שניות // ;(2000)delay

נקה מסך // ;()clear.lcd
}
else if(sec_15_button==HIGH) // | שניות | 15 | נבחר | אם
{
משתנה זמן מזיגה // ;15 = time_pouring
נקה מסך // ;()clear.lcd
lcd.print("Pouring time:"); // | נבחר | זמן | מדפיס
הדפסה בשורה ועמודה ספציפית // ;(3,1)setCursor.lcd lcd.print("15 Seconds");
השהייה של 2 שניות // ;(2000)delay
נקה מסך // ;()clear.lcd
}
}
}
/*----------שינוי בחירת זמן מזיגה תוך כדי ריצה ------------*/
if(sec_4_button==HIGH) // | שניות | 4 | נבחר | אם
{
משתנה זמן מזיגה // ;4 = time_pouring
נקה מסך // ;()clear.lcd
lcd.print("Pouring time:"); // | נבחר | זמן | מדפיס
הדפסה בשורה ועמודה ספציפית // ;(3,1)setCursor.lcd lcd.print("4 Seconds");
השהייה של 2 שניות // ;(2000)delay
נקה מסך // ;()clear.lcd
}
else if(sec_8_button==HIGH) // | שניות | 8 | נבחר | אם
{
משתנה זמן מזיגה // ;8 = time_pouring
נקה מסך // ;()clear.lcd
lcd.print("Pouring time:"); // | נבחר | זמן | מדפיס
הדפסה בשורה ועמודה ספציפית // ;(3,1)setCursor.lcd lcd.print("8 Seconds");
השהייה של 2 שניות // ;(2000)delay
נקה מסך // ;()clear.lcd
}
else if(sec_15_button==HIGH) // | שניות | 15 | נבחר | אם
{
משתנה זמן מזיגה // ;15 = time_pouring
נקה מסך // ;()clear.lcd
lcd.print("Pouring time:"); // | נבחר | זמן | מדפיס
הדפסה בשורה ועמודה ספציפית // ;(3,1)setCursor.lcd lcd.print("15 Seconds");
השהייה של 2 שניות // ;(2000)delay
נקה מסך // ;()clear.lcd
}
/*------------מזיגת מים פושרים למשך 8 שניות בזמן הרתחה ------------*/ lukewarm_temperature = ((hot_temperature*2 + cold_temperature*6) / 8 ); חישוב טמפרטורת פושרים ע"י נוסחאה לפי 2,6 שניות של זמני מזיגה בהכפלת הטמפרטורה בהתאמה //

ערך לחצן פושרים // ;(7)digitalRead = button_lukewarm // delay(100);
תנאי אם נלחץ מזיגת קרים // ( HIGH == button_lukewarm (if
{
if (lukewarm_temperature > 25 && lukewarm_temperature < 35 ) // | למזיגת | תנאי
מים פושרים
{
לולאה להדפסת זמן מזיגה נותר // (++i ; 8 < i; 0 = i int(for
{
digitalWrite(lukewarm_led, HIGH); // | פושרים | לד | מדליק
תנאי שבודק האם עבר 2 שניות ואז לוקח מהמים הקרים // (2 > i(if מדליק לד חמים למשך 2 שניות // ;(HIGH 2,(digitalWrite else
{
מכבה לד חמים לאחר 2 שניות // ;(LOW 2,(digitalWrite מדליק לד קרים למשך 6 שניות // ;(HIGH 3,(digitalWrite }
נקה מסך // ;()clear.lcd
lcd.print("Time left for");
הדפסה בשורה ועמודה ספציפית // ;(0,1)setCursor.lcd lcd.print("pouring : ");
lcd.print(7-i+1);
השהייה של שנייה // ;(1000)delay
boil_button = digitalRead(4); // | הרתחה
hot_button = digitalRead(5); // | חמים | מזיגה
cold_button = digitalRead(6); // | קרים | מזיגה
lukewarm_button = digitalRead(7); // | פושרים | מזיגה
sec_4_button = digitalRead(8); // 4 | מזיגה | שניות
sec_8_button = digitalRead(11); // 8 | מזיגה | שניות
sec_15_button = digitalRead(12); // 15 | מזיגה | שניות
/*---תנאי לבדיקה אם נלחץ כפתור בעת מזיגה אז מפסיק מזיגה --*/
if(boil_button == HIGH || hot_button == HIGH || cold_button == HIGH || lukewarm_button == HIGH || sec_4_button == HIGH|| sec_8_button == HIGH || sec_15_button == HIGH)
מפסיק מזיגה // ;break
}
מכבה לד קרים // ;(LOW 3,(digitalWrite
מכבה לד חמים // ;(LOW 2,(digitalWrite
digitalWrite(lukewarm_led, LOW); // | פושרים | לד | מכבה
השהייה של חצי שנייה // ;(500)delay
}
else
{
נקה מסך // ;()clear.lcd
lcd.print("lukewarm temperature");
הדפסה בשורה ועמודה ספציפית // ;(5,1)setCursor.lcd lcd.print(lukewarm_temperature);
השהייה של שנייה // ;(2000)delay

}
}
/*---------------לד אזהרת גלישה תוך כדי רתיחה --------------*/ בודק ערך מפלס חיישן לחות // ;(3A(analogRead = overflow
//Serial.println(overflow); // | הערך | הדפסת
תנאי לגלישת מים // (550 < overflow (if
digitalWrite(warning_led, HIGH); // | אזהרה | לד | מדליק
אם לא גולש מכבה לד אזהרה // else
digitalWrite(warning_led, LOW); // | אזהרה | לד | מכבה
}
}
/*------------------------- סוף בלוק בקרת הרתחת מים ----------------------*/ }

.9 מקורות ספרותיים .
.9.1 מקורות.
Bazza, M. Overview of the History of Water Resources and Irrigation Management in the Near East Region. Water Sci. Technol Water Supply 2007, 7, 201–209.
.9.2 קישורים ברשת.
ערך "בר מים" בויקיפדיה:
https://he.wikipedia.org/wiki/%D7%91%D7%A8_%D7%9E%D7%99%D7%9D ערך "באר מים" בויקיפדיה:
https://he.wikipedia.org/wiki/%D7%91%D7%90%D7%A8_%D7%9E%D7%99 %D7%9D
מכללת הרצוג דעת, השקאה בתקופת המקרא, ד"ר יהושע בראנד: https://www.daat.ac.il/daat/kitveyet/mahanaim/hashkaa-2.htm
