YagelTasa/Smart_water_bar/Arduino/Arduino image.jpg

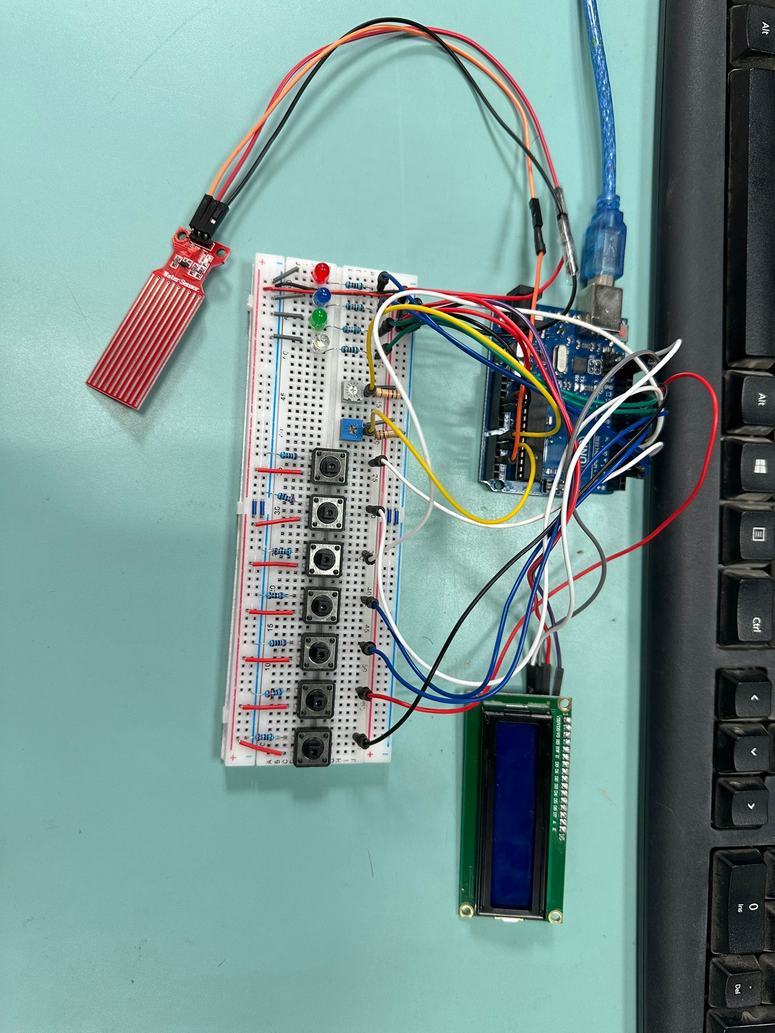
Arduino/Arduino image.jpg
