YagelTasa/Smart_water_bar/Arduino/Simulation arduino.png

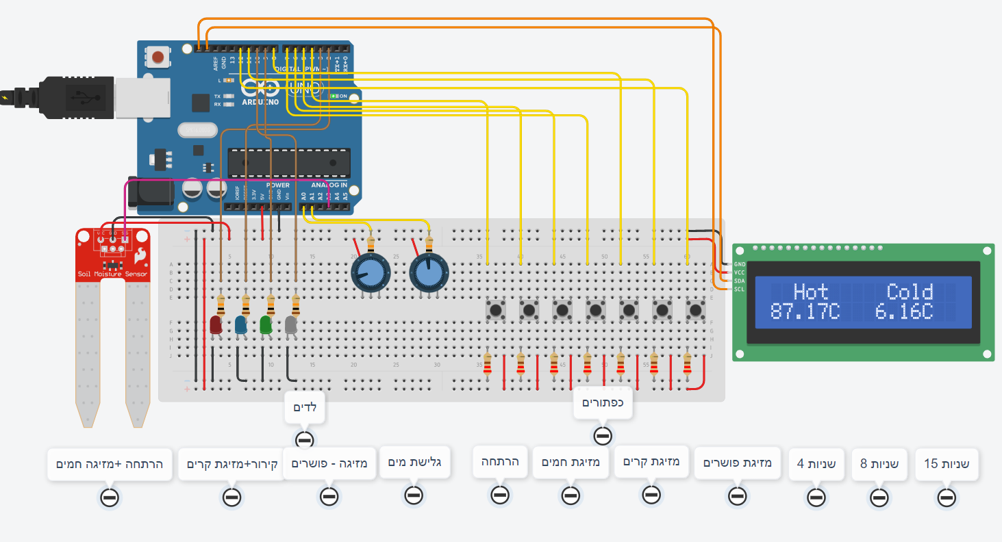
Arduino/Simulation arduino.png
