YagelTasa/Smart_water_bar/Arduino/Swanky Allis.pdf

A

1 | 2 | 3 | 4 | 5 | 6

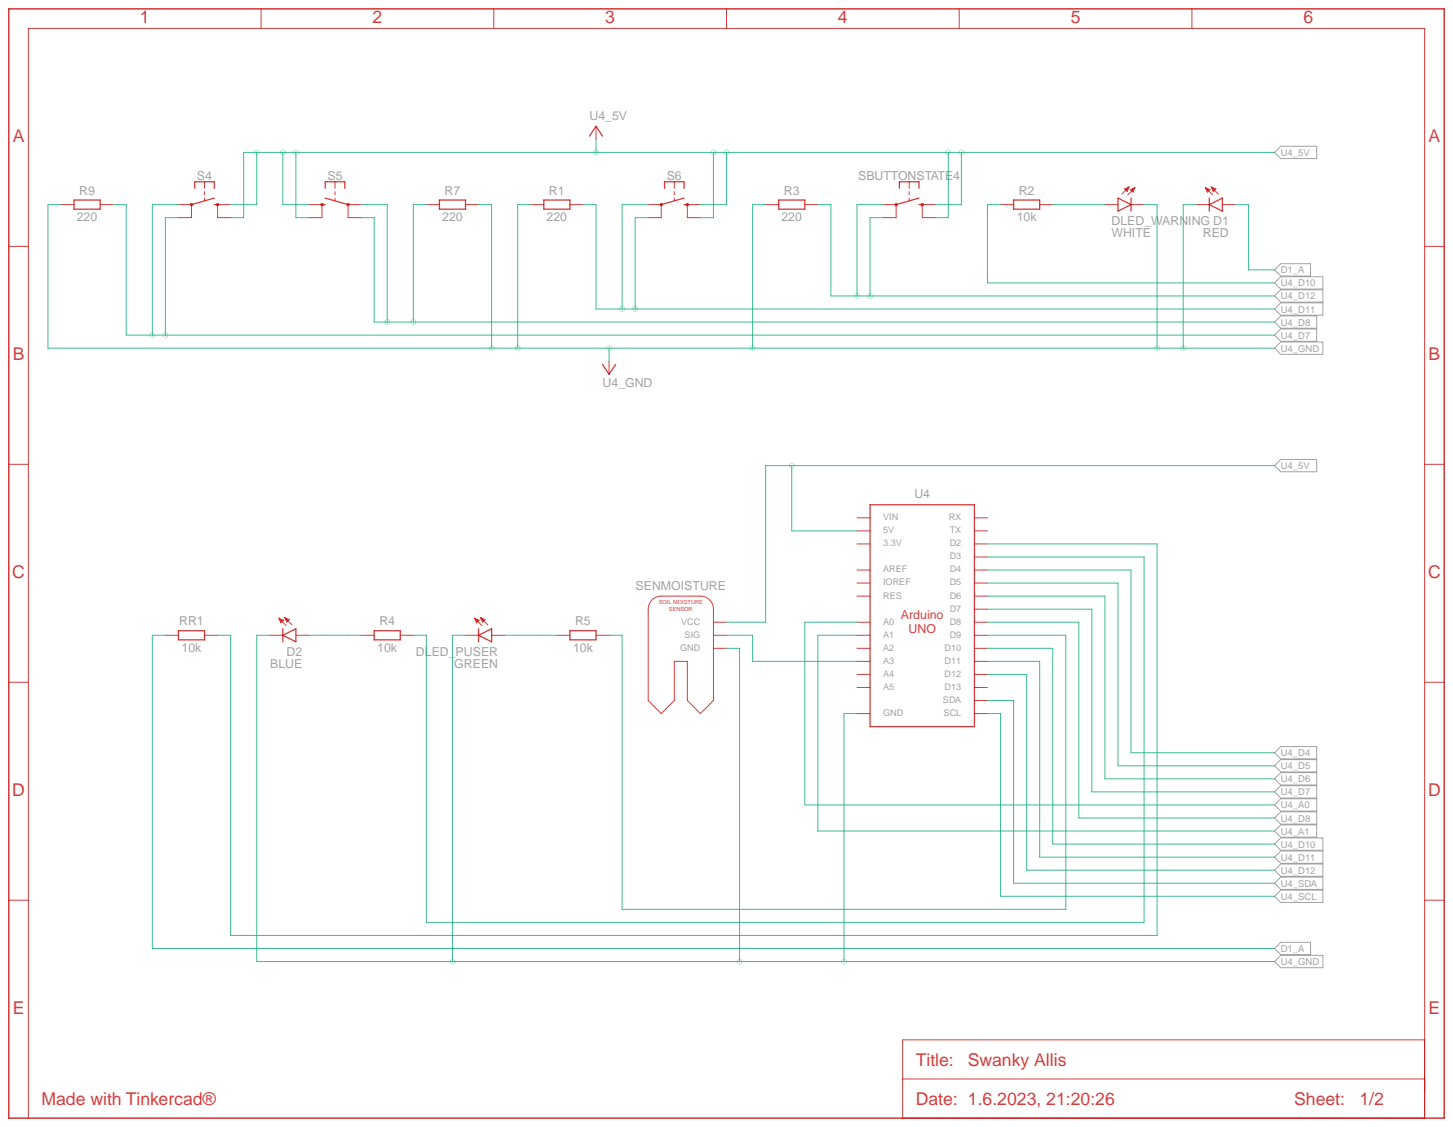
[picture p56: page 1]

A

1 | 2 | 3 | 4 | 5 | 6

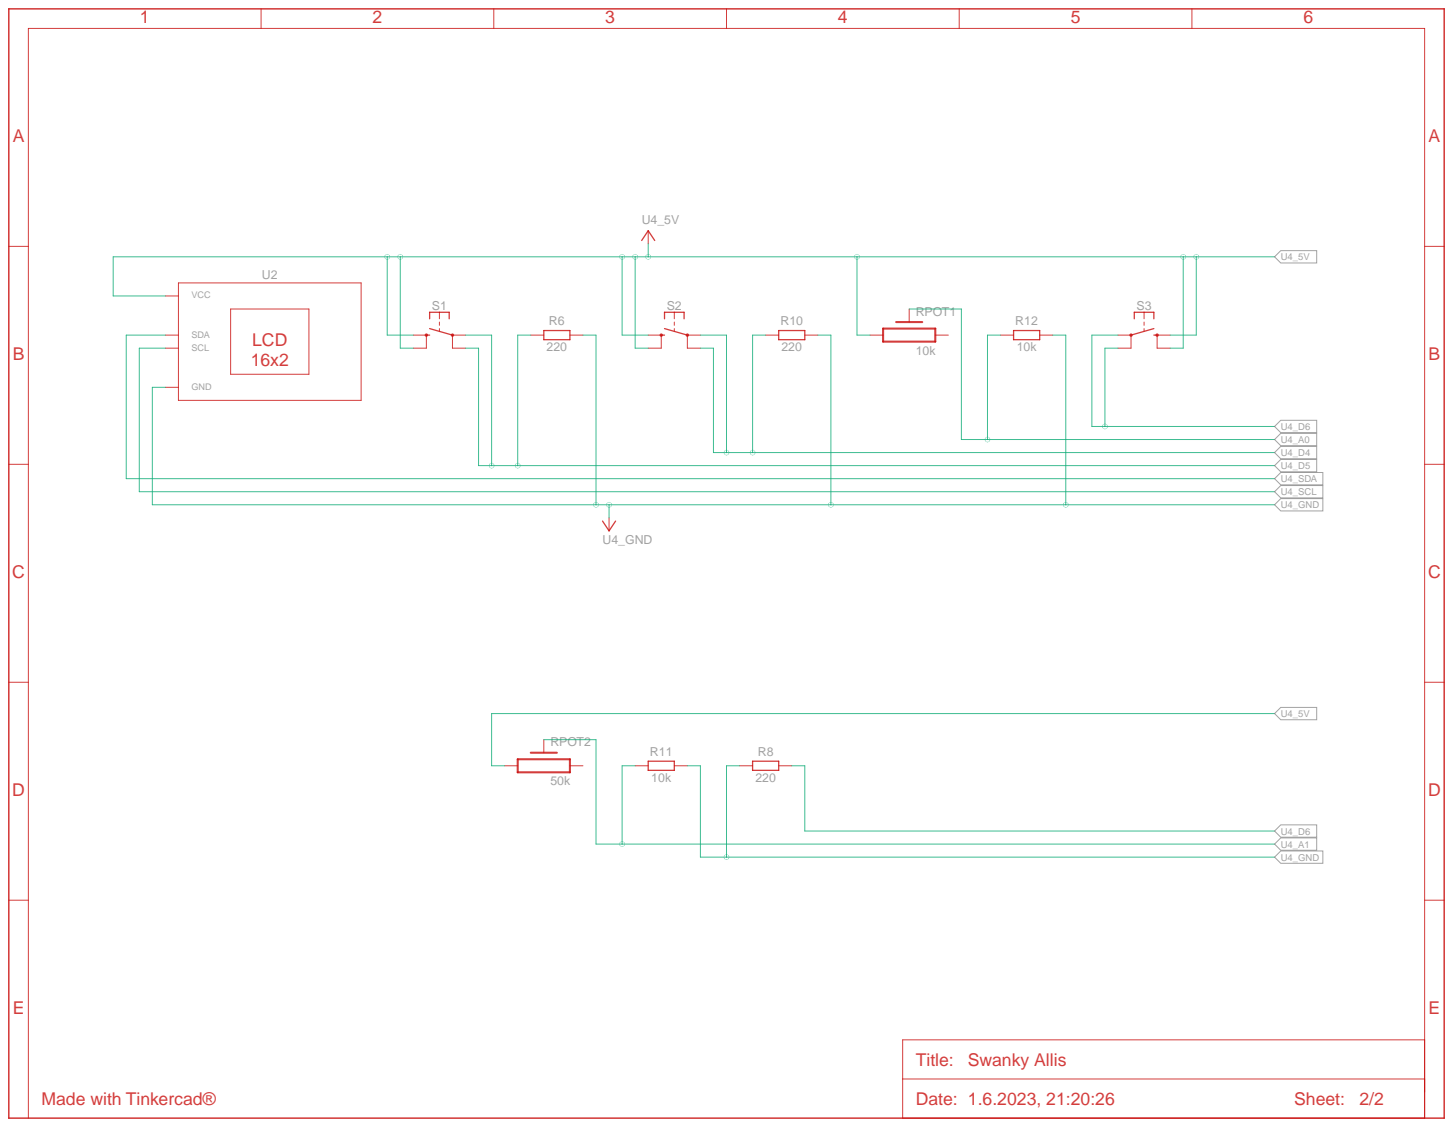
[picture p57: page 2]
Date: 1.6.2023, 21:20:26; Sheet: 2/2; VCC; SDA SCL; GND; LCD 16x2; RPOT1; U4_GND; RPOT2; U4_SCL; U4_SDA

Title: Swanky Allis

Made with Tinkercad®
