YagelTasa/Smart_water_bar/(list of files, drawings)

Other design files:
Simulation.ms14
