YagelTasa/Smart_water_bar/(commit log)

2023-07-04 Create Arduino code
2023-07-04 Rename Arduino code to Arduino /Arduino code
